IngMiguelMartinez/cnc-3d-social-housing-thesis/media/demo_cnc_2.gif

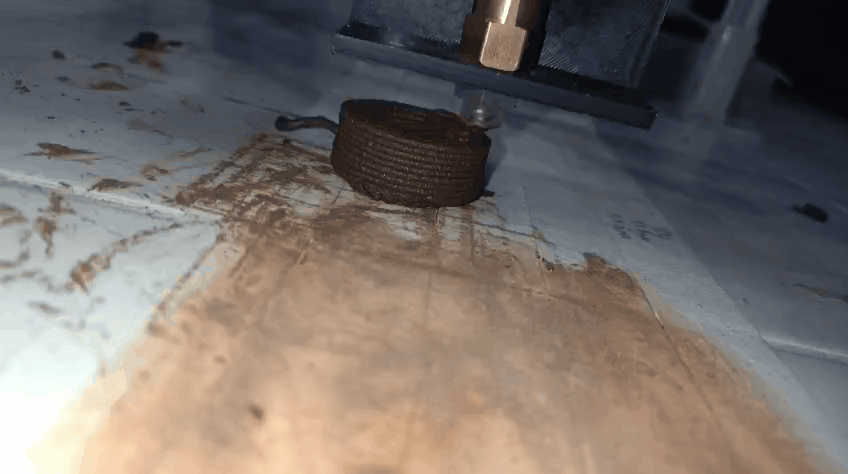
media/demo_cnc_2.gif
