IngMiguelMartinez/cnc-3d-social-housing-thesis/media/Vista_Frontal.jpeg

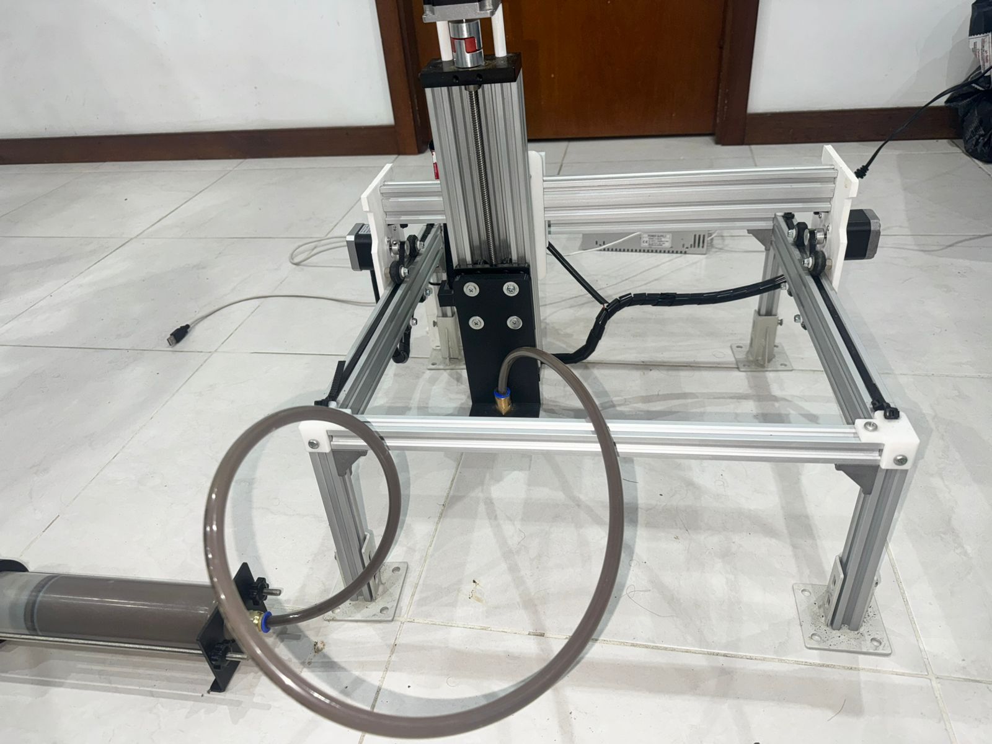
media/Vista_Frontal.jpeg
