IngMiguelMartinez/cnc-3d-social-housing-thesis/media/Vista_Frrontal2.jpeg

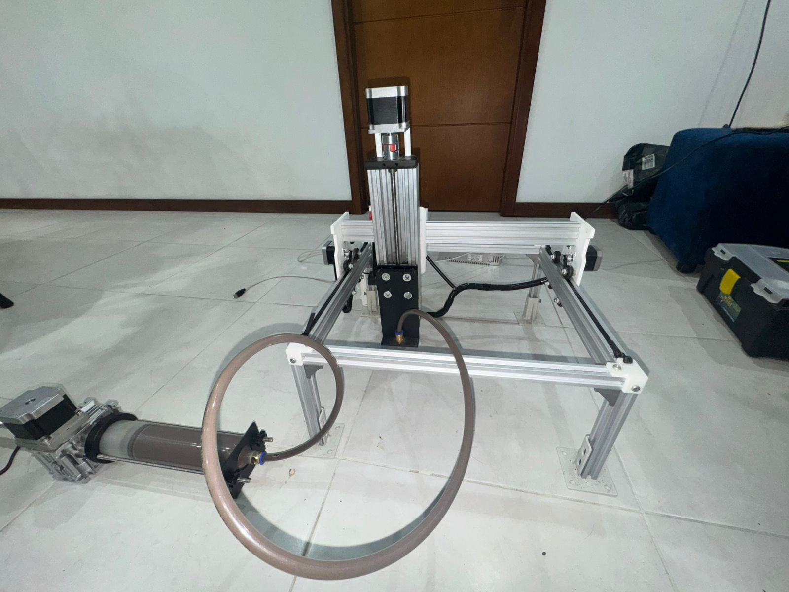
media/Vista_Frrontal2.jpeg
