IngMiguelMartinez/cnc-3d-social-housing-thesis/hardware/cad/ensamblaje_solidworks/Eje Z 300mm.SLDASM

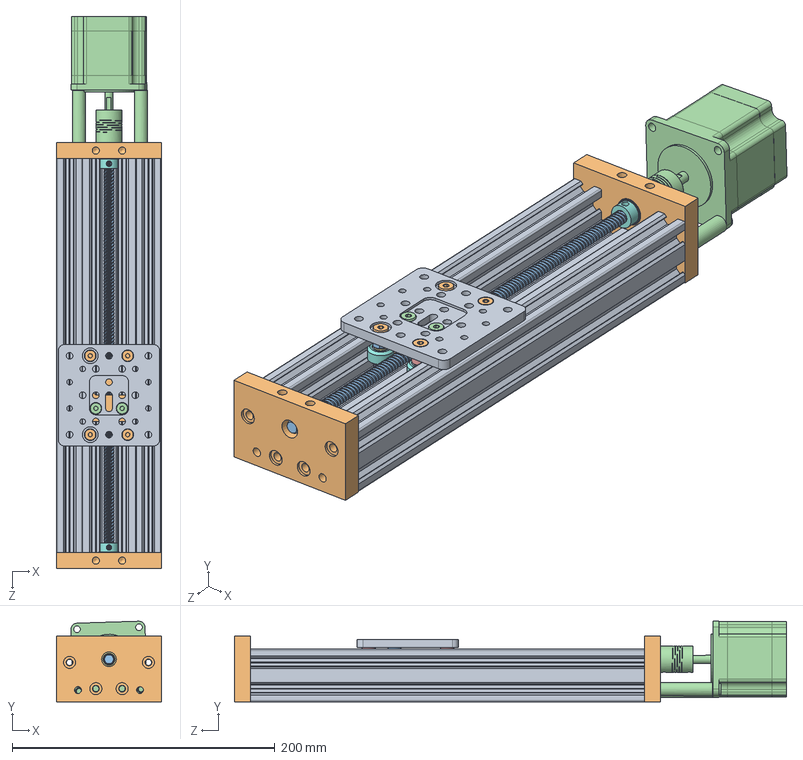
[picture p8: CAD file, 2026-01-31]
hardware/cad/ensamblaje_solidworks/Eje Z 300mm.SLDASM
80.0 x 61.3 x 420.0 mm
PF20-13 - Perfil 4080 C-Beam
Pieza85 x 2
Tornillo z
Acople FlexibleSLDPRT
dis_bilezik x 2
ic_bilezik x 2
kapak x 4
Lock Collar 8mm x 2
BaseMovil
Antibacklash camisa
Espaciador de aluminio 3mm x 2
Low Profile Screw M5 [20mm] x 2
Espaciador de aluminio 6mm x 2
Nylon Insert Lock Nut M5 x 4
Precision Shim 8 x 5 x 1 x 8
Xtreme Mini V Wheel x 4
Ball Bearing 5 x 10 x 4.2 x 8
Low Profile Screw M5 [25mm] x 4
Mini Eccentric Spacer 6mm x 2
Nema 23
