IngMiguelMartinez/cnc-3d-social-housing-thesis/hardware/cad/ensamblaje_solidworks/Rueda_ensamblZguia.SLDASM

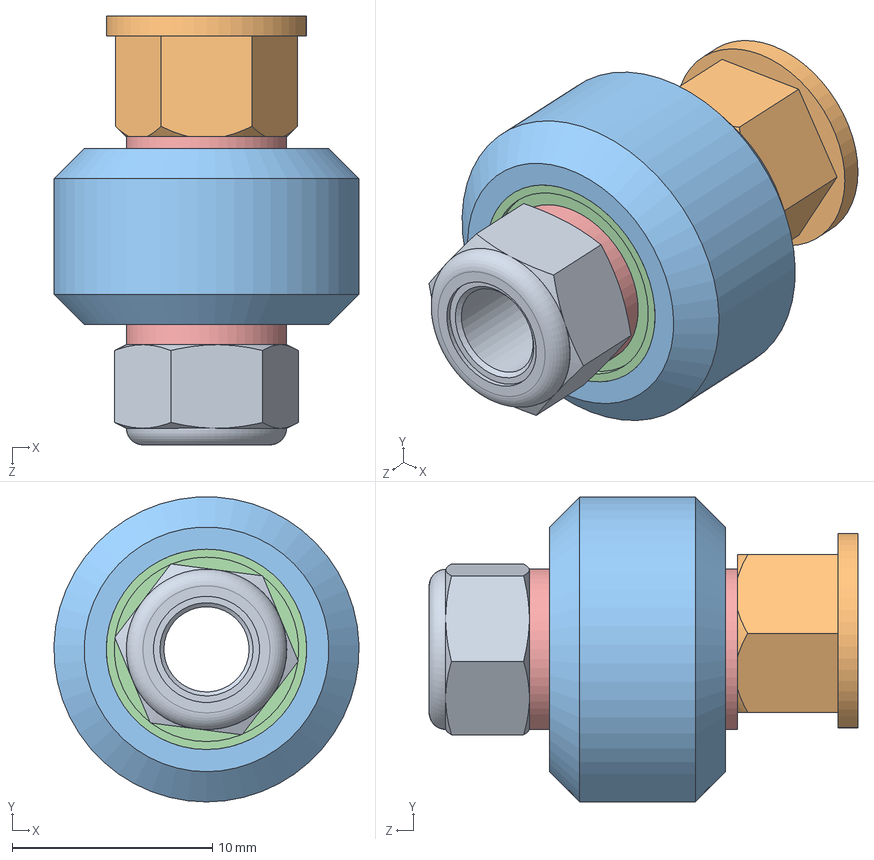
[picture p9: CAD file, 2026-01-31]
hardware/cad/ensamblaje_solidworks/Rueda_ensamblZguia.SLDASM
15.2 x 15.2 x 21.4 mm
Nylon Insert Lock Nut M5
Mini Eccentric Spacer 6mm
Xtreme Mini V Wheel
Ball Bearing 5 x 10 x 4.2 x 2
Precision Shim 8 x 5 x 1 x 2
