IngMiguelMartinez/cnc-3d-social-housing-thesis/hardware/cad/ensamblaje_solidworks/rueda_ensamb_x.SLDASM

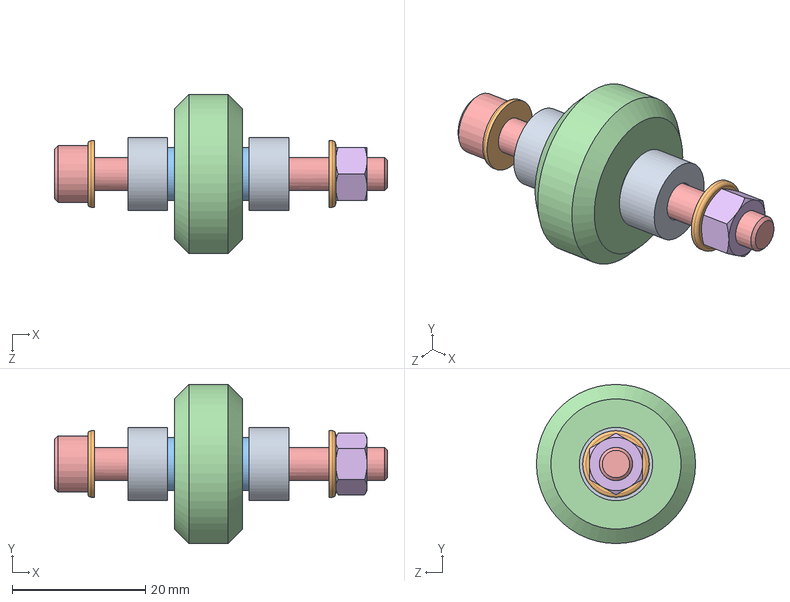
[picture p10: CAD file, 2026-01-31]
hardware/cad/ensamblaje_solidworks/rueda_ensamb_x.SLDASM
50.0 x 23.9 x 23.9 mm
anillo x 2
arandela x 2
arandela_presion x 2
rueda
socket head cap screw_am
hex nut style 1_am
