IngMiguelMartinez/cnc-3d-social-housing-thesis/hardware/cad/ensamblaje_solidworks/Ensamblaje XY.SLDASM

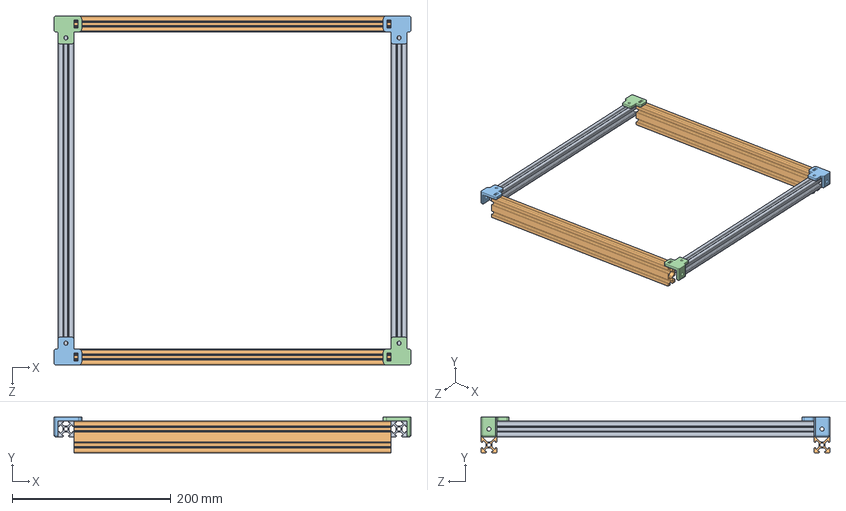
[picture p11: CAD file, 2026-01-31]
hardware/cad/ensamblaje_solidworks/Ensamblaje XY.SLDASM
450.0 x 45.0 x 440.0 mm
FRONTAL_PERFIL_2020 x 2
LATERAL_PERFIL_2040 x 2
tensorRtensor_correa x 2
tensor_correa x 2
