IngMiguelMartinez/cnc-3d-social-housing-thesis/hardware/cad/ensamblaje_solidworks/Prueba soporte.SLDASM

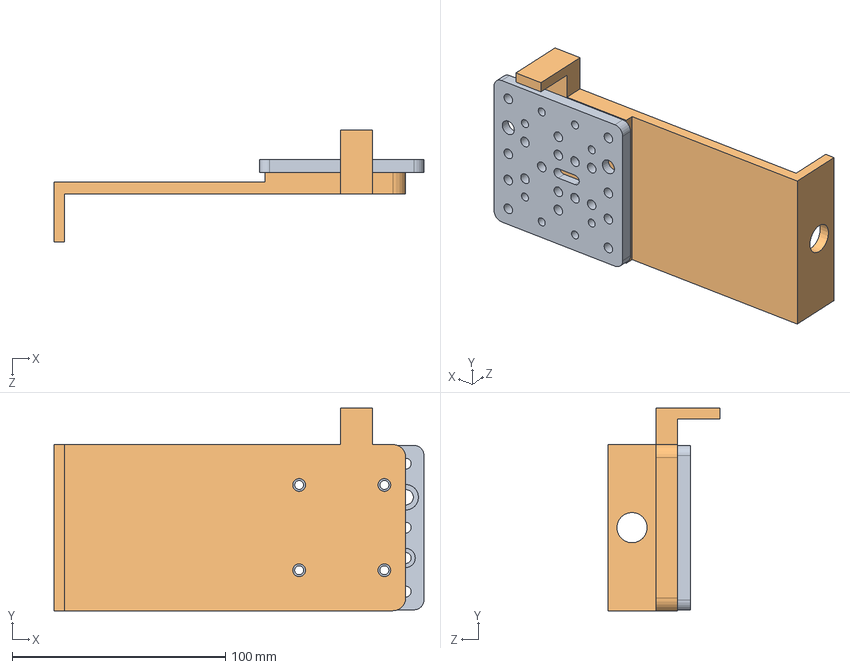
[picture p12: CAD file, 2026-01-31]
hardware/cad/ensamblaje_solidworks/Prueba soporte.SLDASM
173.6 x 95.0 x 52.7 mm
BaseMovil
Preliminar soporte boquilla
