IngMiguelMartinez/cnc-3d-social-housing-thesis/hardware/cad/ensamblaje_solidworks/EnsambleCarroY.SLDASM

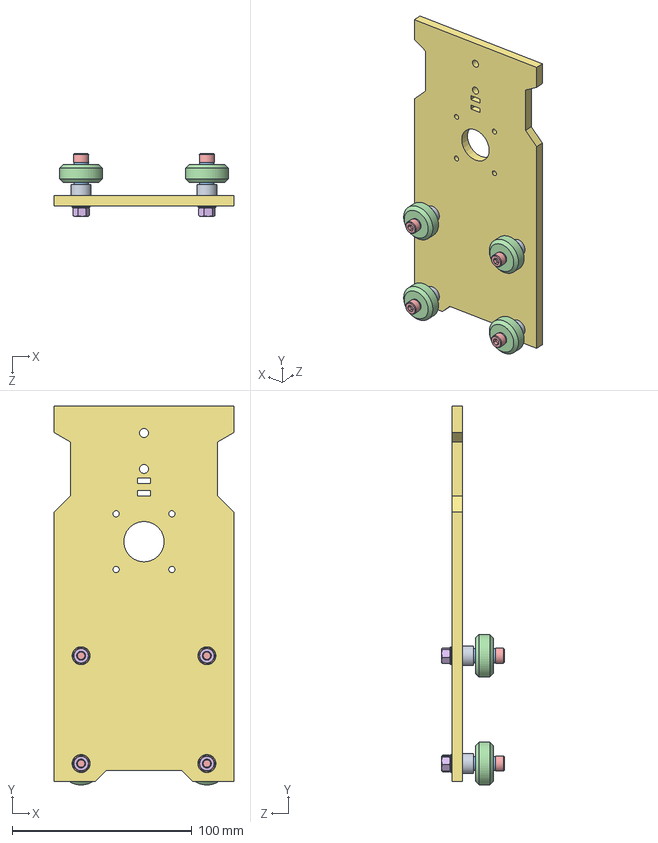
[picture p13: CAD file, 2026-01-31]
hardware/cad/ensamblaje_solidworks/EnsambleCarroY.SLDASM
100.0 x 210.9 x 35.0 mm
anillo x 4
arandela x 4
arandela_presion x 8
rueda x 4
socket head cap screw_am x 4
hex nut style 1_am x 4
carro eje Y
