IngMiguelMartinez/cnc-3d-social-housing-thesis/hardware/cad/ensamblaje_solidworks/688zz_bearing.SLDASM

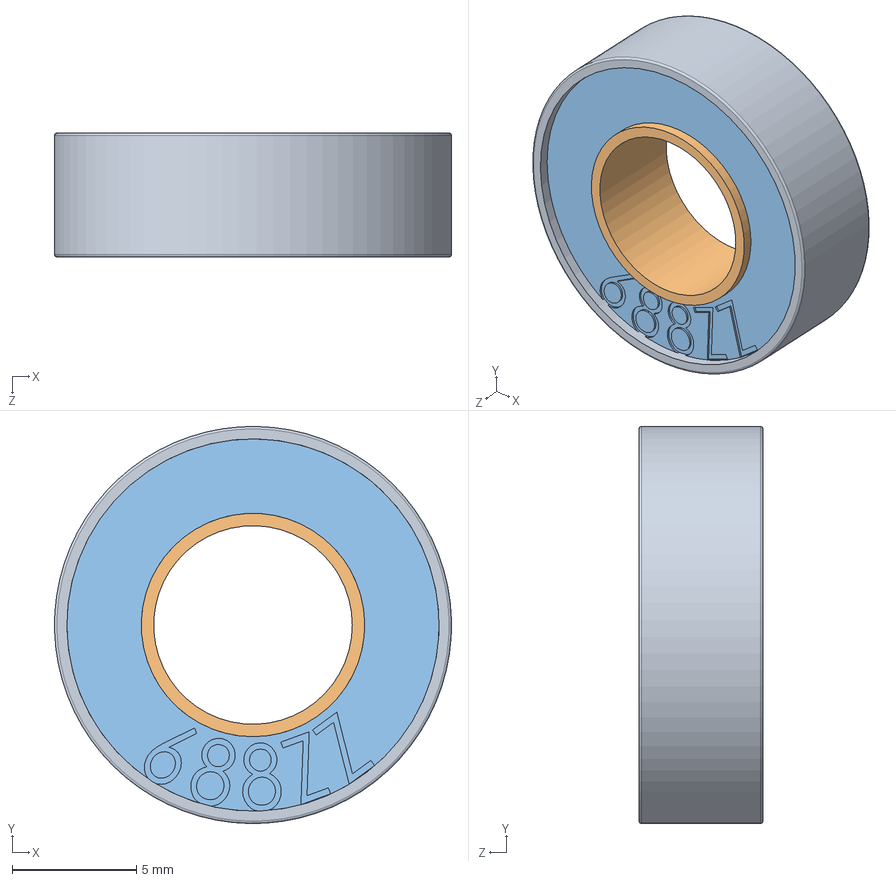
[picture p14: CAD file, 2026-01-31]
hardware/cad/ensamblaje_solidworks/688zz_bearing.SLDASM
16.0 x 16.0 x 5.00 mm
dis_bilezik
ic_bilezik
kapak x 2
