IngMiguelMartinez/cnc-3d-social-housing-thesis/hardware/cad/ensamblaje_solidworks/CarroX.SLDASM

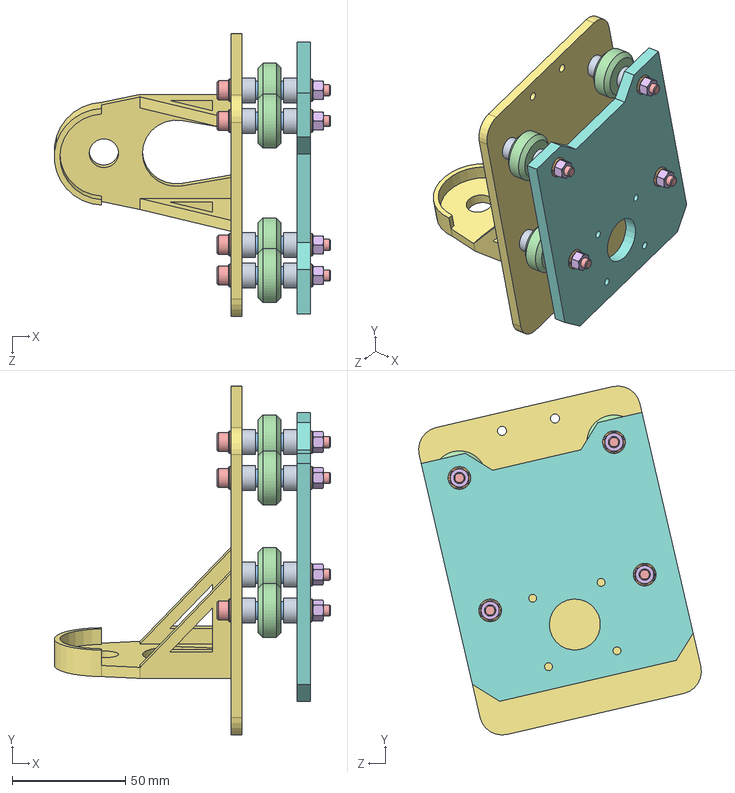
[picture p15: CAD file, 2026-01-31]
hardware/cad/ensamblaje_solidworks/CarroX.SLDASM
121.8 x 154.0 x 124.8 mm
anillo x 8
arandela x 8
arandela_presion x 8
rueda x 4
socket head cap screw_am x 4
hex nut style 1_am x 4
carro eje X_frontal
carro eje X
