IngMiguelMartinez/cnc-3d-social-housing-thesis/hardware/cad/ensamblaje_solidworks/Ensamblaje tanque.SLDASM

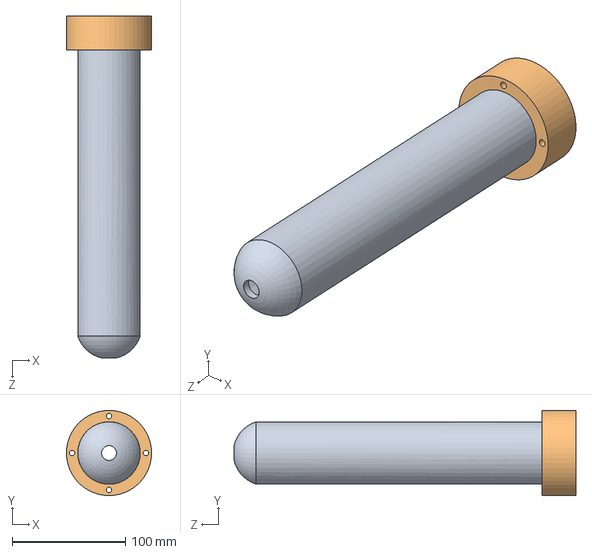
[picture p16: CAD file, 2026-01-31]
hardware/cad/ensamblaje_solidworks/Ensamblaje tanque.SLDASM
75.0 x 75.0 x 301.3 mm
Tanque
Tapa
