IngMiguelMartinez/cnc-3d-social-housing-thesis/hardware/cad/ensamblaje_solidworks/NMRV030.SLDASM

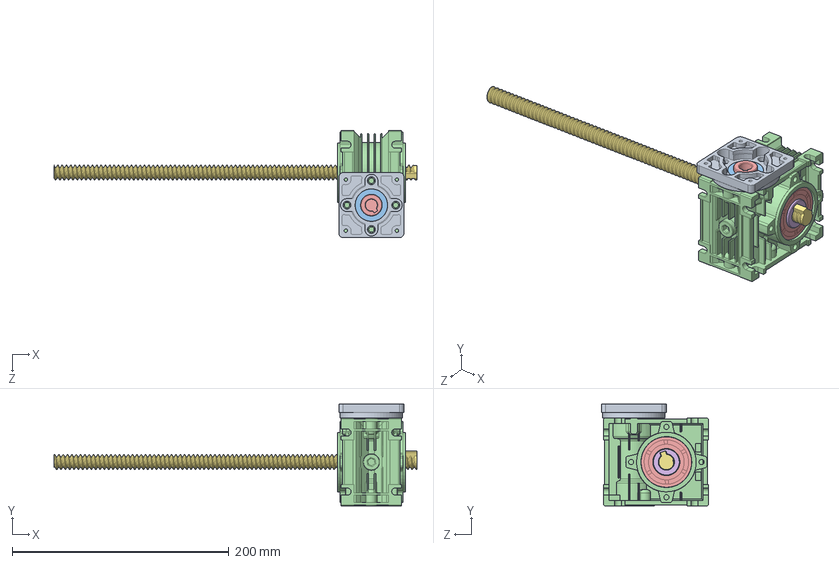
[picture p18: CAD file, 2026-01-31]
hardware/cad/ensamblaje_solidworks/NMRV030.SLDASM
335.0 x 94.0 x 99.0 mm
PrirubaDC300W
Okrouzek33x2
Gufero7x30x20
GearboxRV030Case
Gufero7x47x25 x 2
GearboxRV030OutputShaft
GearboxRV030Shaft
ZátkaNBR_32x7
Lozisko_16005_47x25x8 x 2
Pojistny Krouzek DIN 472 x 2
Lozisko_6201_32x12x10
Lozisko_61904_37x20x9
HridelSnek
