IngMiguelMartinez/cnc-3d-social-housing-thesis/hardware/cad/ensamblaje_solidworks/rueda_ensambl1.SLDASM

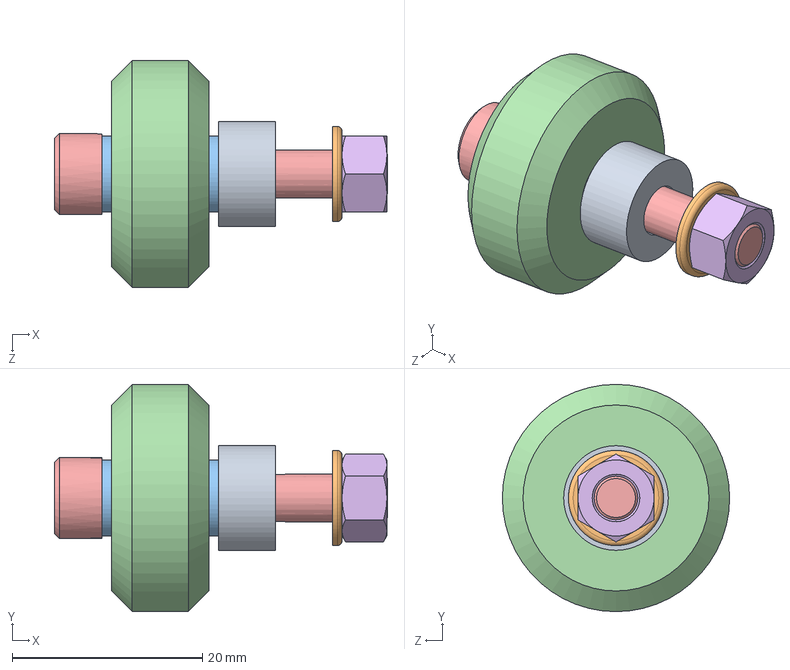
[picture p19: CAD file, 2026-01-31]
hardware/cad/ensamblaje_solidworks/rueda_ensambl1.SLDASM
35.0 x 23.9 x 23.9 mm
anillo
arandela
arandela_presion x 2
rueda
socket head cap screw_am
hex nut style 1_am
