IngMiguelMartinez/cnc-3d-social-housing-thesis/hardware/cad/ensamblaje_solidworks/GearboxRV030OutputShaft.SLDPRT

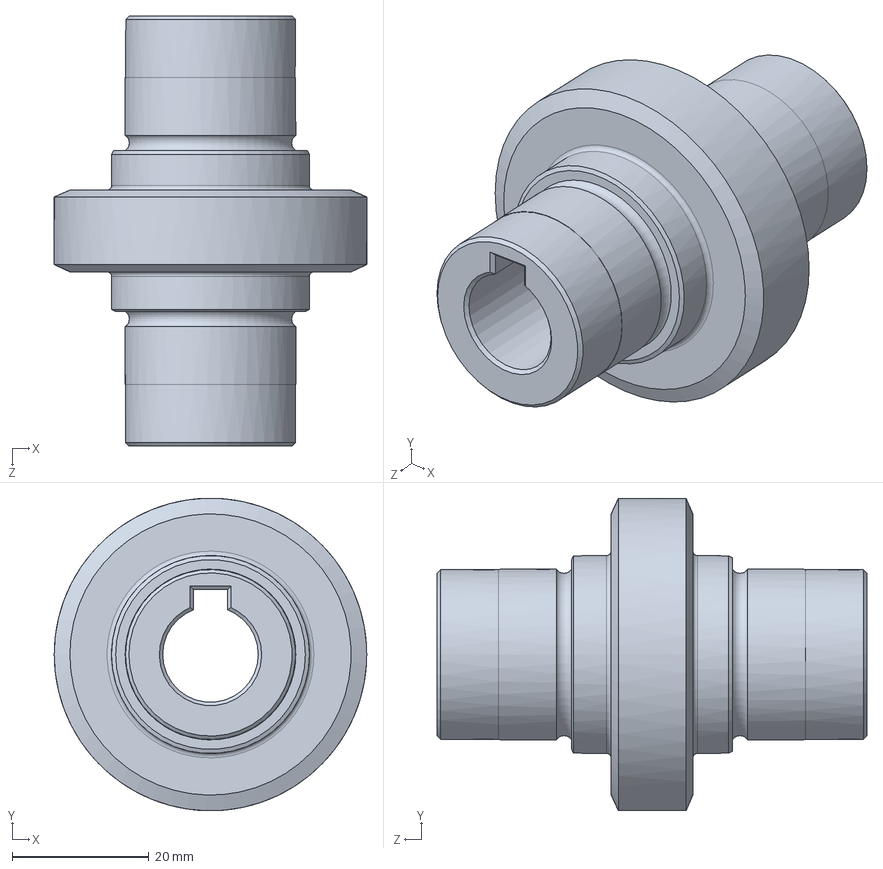
[picture p20: CAD file, 2026-01-31]
hardware/cad/ensamblaje_solidworks/GearboxRV030OutputShaft.SLDPRT
45.8 x 45.8 x 63.0 mm
