IngMiguelMartinez/cnc-3d-social-housing-thesis/hardware/cad/ensamblaje_solidworks/kapak.SLDPRT

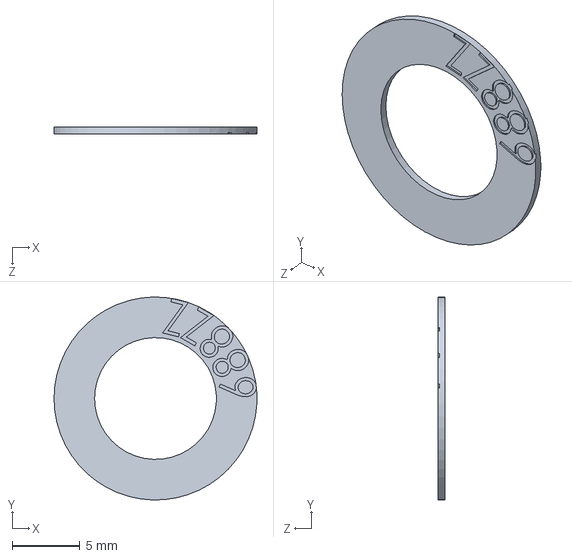
[picture p21: CAD file, 2026-01-31]
hardware/cad/ensamblaje_solidworks/kapak.SLDPRT
15.0 x 15.0 x 0.5 mm
