IngMiguelMartinez/cnc-3d-social-housing-thesis/hardware/cad/ensamblaje_solidworks/tensorRtensor_correa.SLDPRT

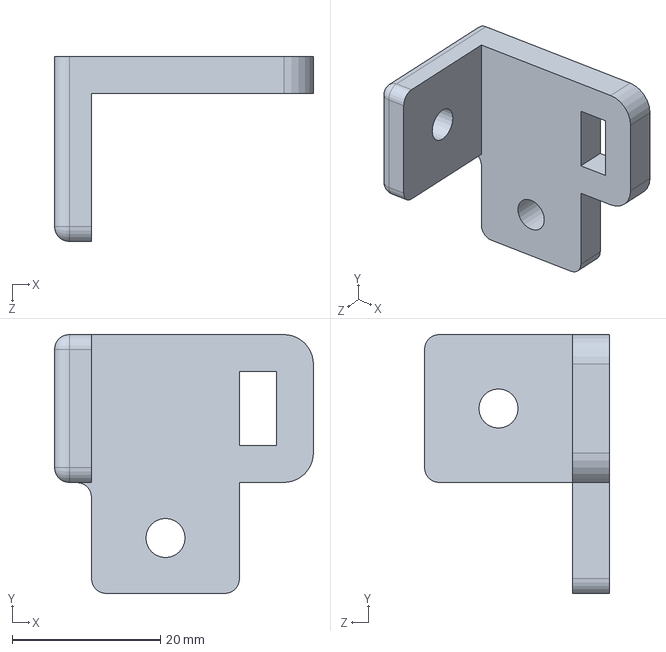
[picture p22: CAD file, 2026-01-31]
hardware/cad/ensamblaje_solidworks/tensorRtensor_correa.SLDPRT
35.0 x 35.0 x 25.0 mm
