IngMiguelMartinez/cnc-3d-social-housing-thesis/hardware/cad/ensamblaje_solidworks/carro eje Y.SLDPRT

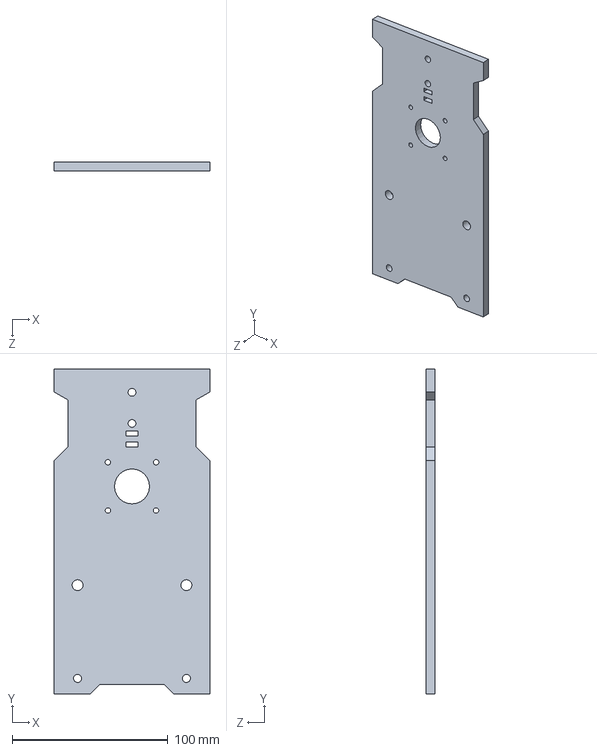
[picture p23: CAD file, 2026-01-31]
hardware/cad/ensamblaje_solidworks/carro eje Y.SLDPRT
100.0 x 209.0 x 6.00 mm
