IngMiguelMartinez/cnc-3d-social-housing-thesis/hardware/cad/ensamblaje_solidworks/ic_bilezik.SLDPRT

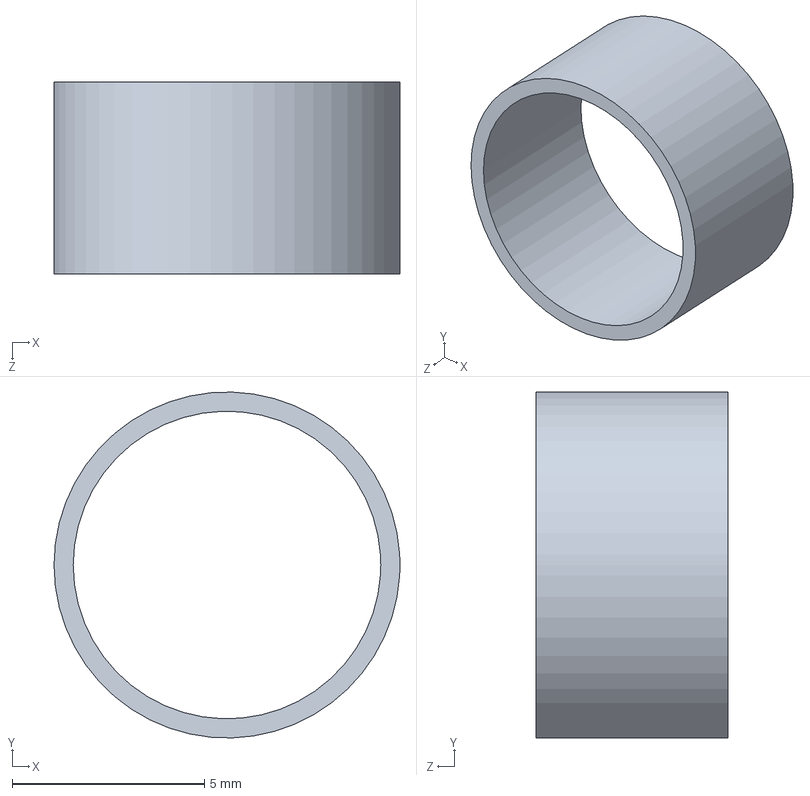
[picture p24: CAD file, 2026-01-31]
hardware/cad/ensamblaje_solidworks/ic_bilezik.SLDPRT
9.00 x 9.00 x 5.00 mm
