IngMiguelMartinez/cnc-3d-social-housing-thesis/hardware/cad/ensamblaje_solidworks/Nema 23.SLDPRT

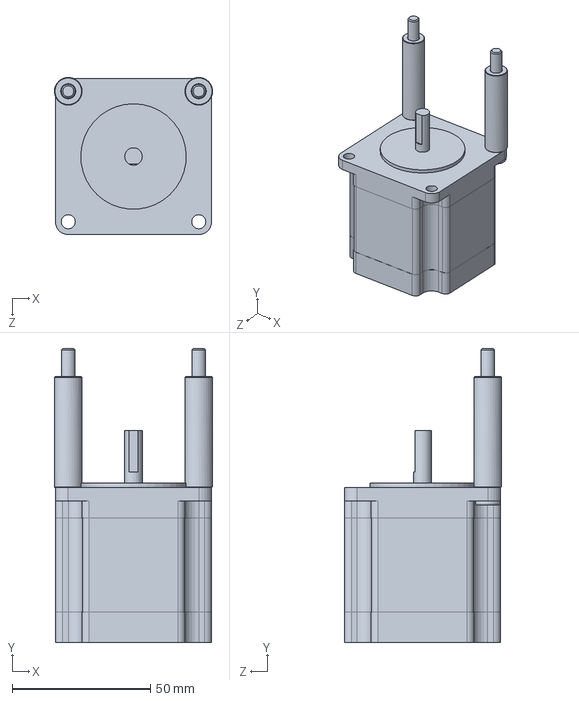
[picture p25: CAD file, 2026-01-31]
hardware/cad/ensamblaje_solidworks/Nema 23.SLDPRT
57.1 x 106.2 x 56.8 mm
