IngMiguelMartinez/cnc-3d-social-housing-thesis/hardware/cad/ensamblaje_solidworks/LATERAL_PERFIL_2040 X.SLDPRT

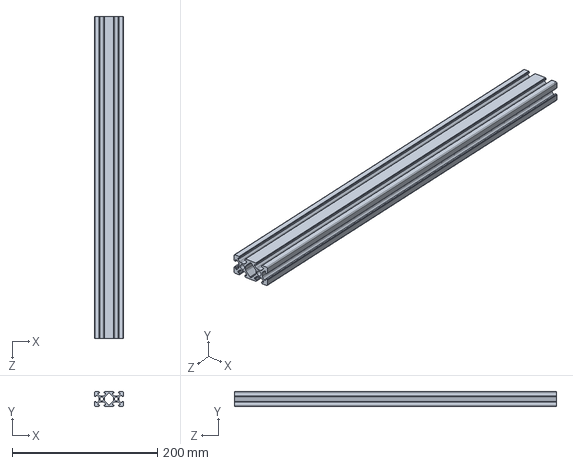
[picture p26: CAD file, 2026-01-31]
hardware/cad/ensamblaje_solidworks/LATERAL_PERFIL_2040 X.SLDPRT
40.0 x 20.0 x 444.0 mm
