IngMiguelMartinez/cnc-3d-social-housing-thesis/hardware/cad/ensamblaje_solidworks/ZátkaNBR_32x7.SLDPRT

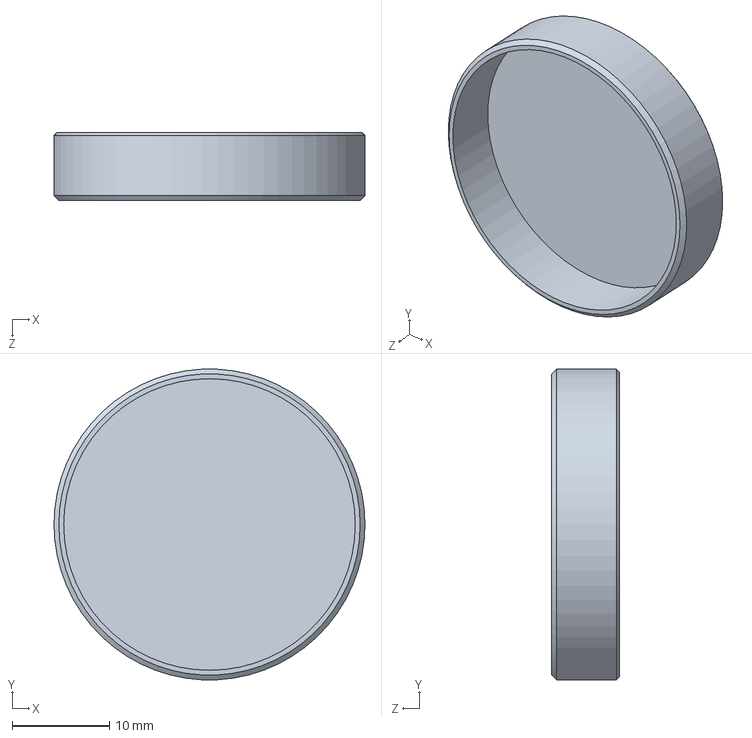
[picture p27: CAD file, 2026-01-31]
hardware/cad/ensamblaje_solidworks/ZátkaNBR_32x7.SLDPRT
32.0 x 32.0 x 7.00 mm
