IngMiguelMartinez/cnc-3d-social-housing-thesis/hardware/cad/ensamblaje_solidworks/Xtreme Mini V Wheel.SLDPRT

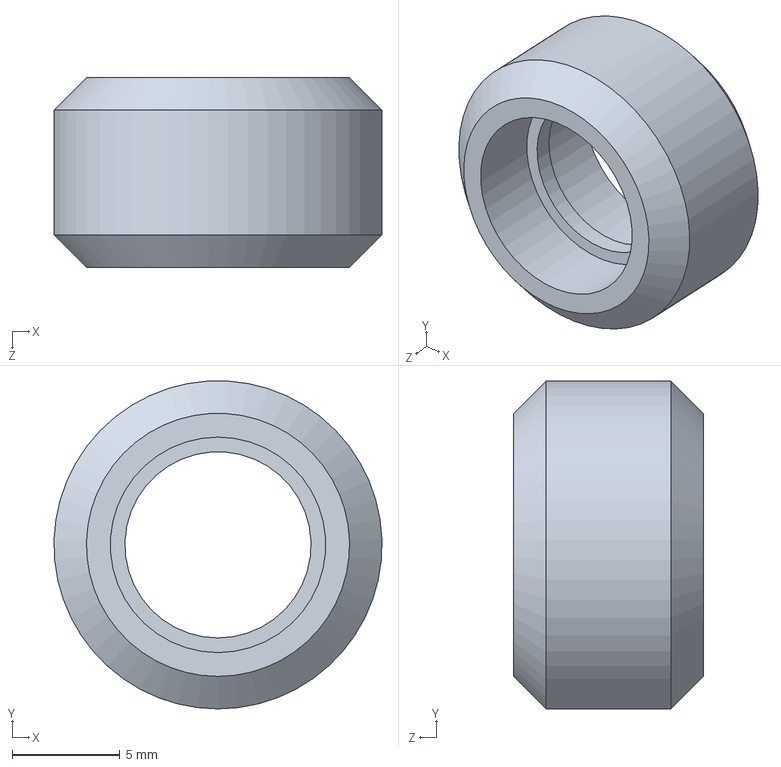
[picture p28: CAD file, 2026-01-31]
hardware/cad/ensamblaje_solidworks/Xtreme Mini V Wheel.SLDPRT
15.2 x 15.2 x 8.80 mm
