IngMiguelMartinez/cnc-3d-social-housing-thesis/hardware/cad/ensamblaje_solidworks/Tanque.SLDPRT

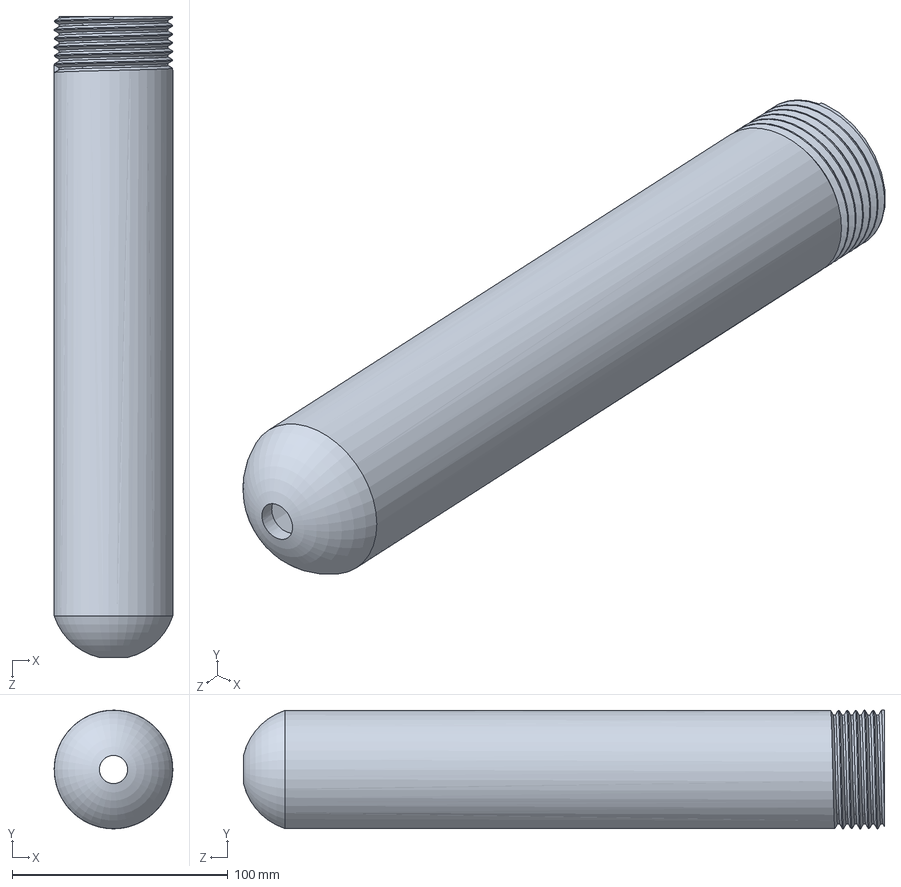
[picture p29: CAD file, 2026-01-31]
hardware/cad/ensamblaje_solidworks/Tanque.SLDPRT
55.0 x 55.0 x 297.3 mm
