IngMiguelMartinez/cnc-3d-social-housing-thesis/hardware/cad/ensamblaje_solidworks/Espaciador de aluminio 6mm.SLDPRT

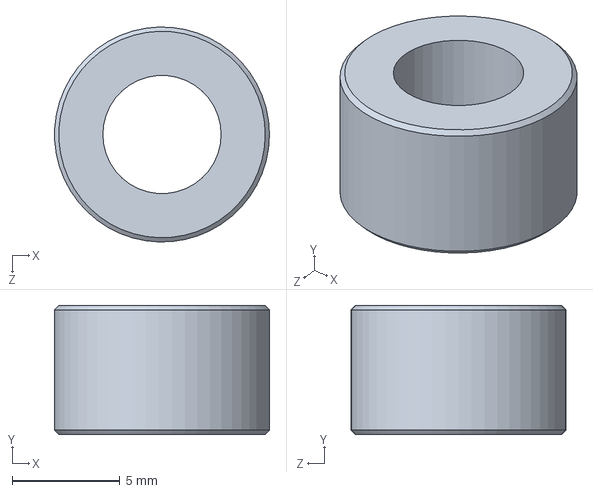
[picture p30: CAD file, 2026-01-31]
hardware/cad/ensamblaje_solidworks/Espaciador de aluminio 6mm.SLDPRT
10.0 x 6.00 x 10.00 mm
