IngMiguelMartinez/cnc-3d-social-housing-thesis/hardware/cad/ensamblaje_solidworks/carro eje X_frontal.SLDPRT

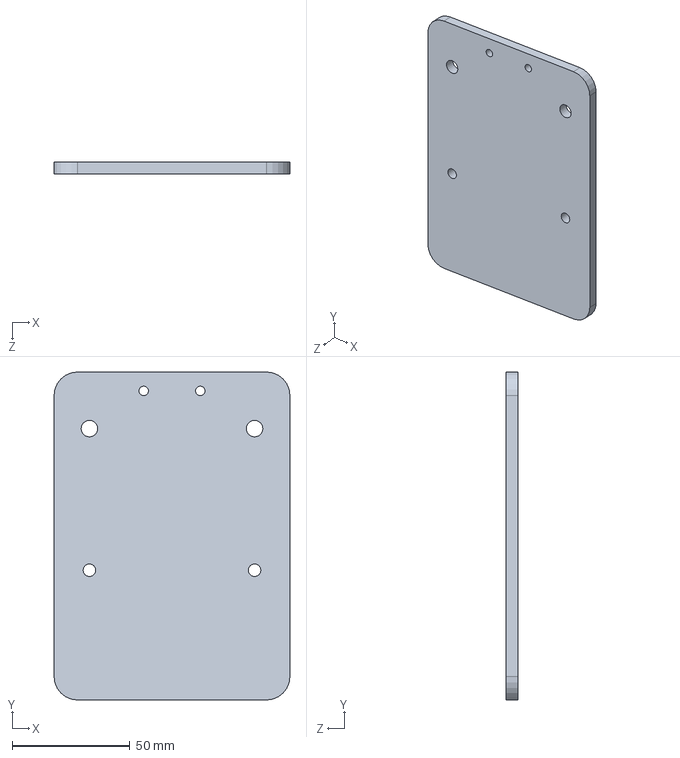
[picture p31: CAD file, 2026-01-31]
hardware/cad/ensamblaje_solidworks/carro eje X_frontal.SLDPRT
100.0 x 139.0 x 5.00 mm
