IngMiguelMartinez/cnc-3d-social-housing-thesis/hardware/cad/ensamblaje_solidworks/dis_bilezik.SLDPRT

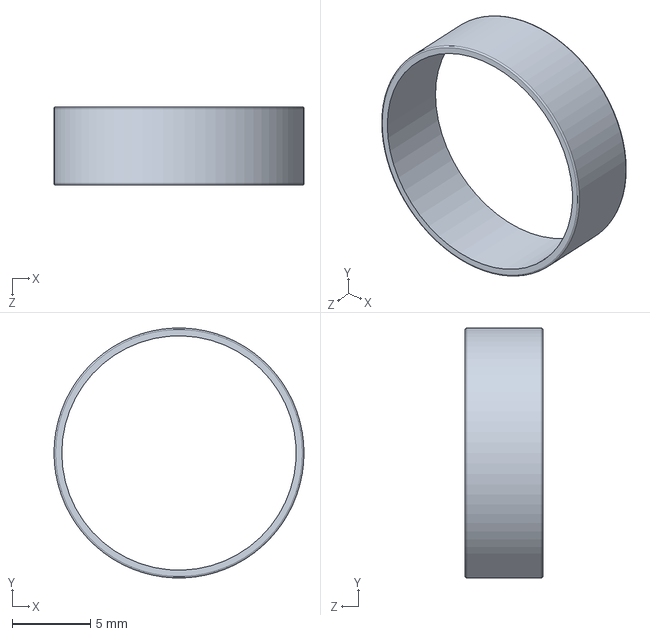
[picture p32: CAD file, 2026-01-31]
hardware/cad/ensamblaje_solidworks/dis_bilezik.SLDPRT
16.0 x 16.0 x 5.00 mm
