IngMiguelMartinez/cnc-3d-social-housing-thesis/hardware/cad/ensamblaje_solidworks/anillo.SLDPRT

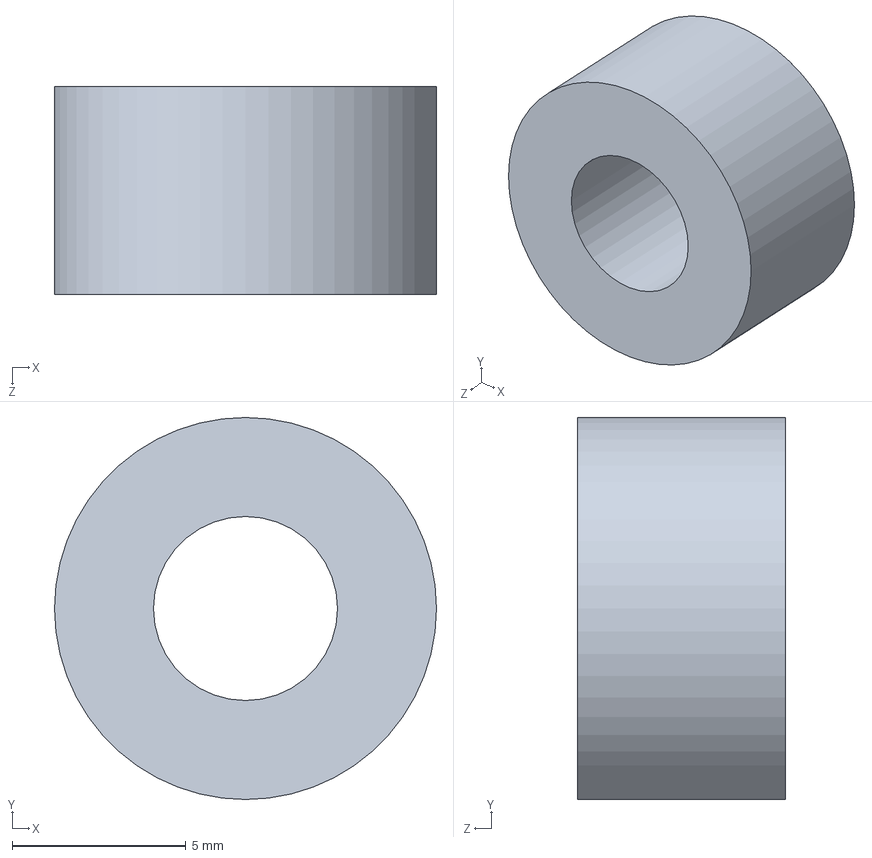
[picture p33: CAD file, 2026-01-31]
hardware/cad/ensamblaje_solidworks/anillo.SLDPRT
11.0 x 11.0 x 6.00 mm
