IngMiguelMartinez/cnc-3d-social-housing-thesis/hardware/cad/ensamblaje_solidworks/FRONTAL_PERFIL_2020.SLDPRT

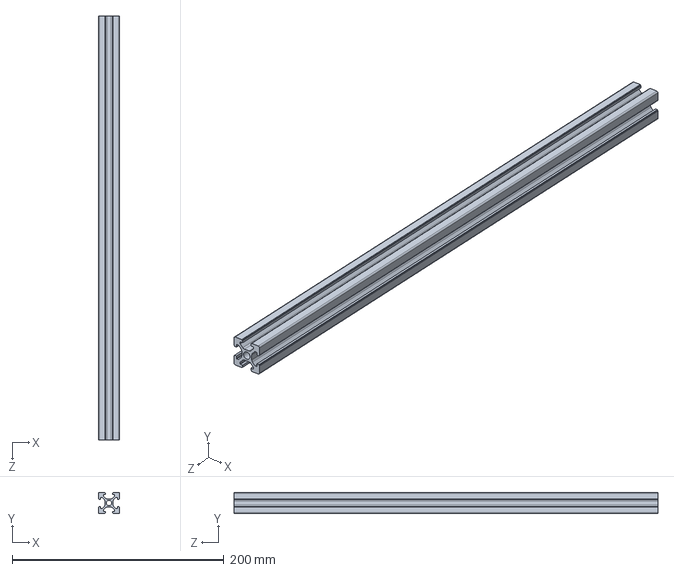
[picture p34: CAD file, 2026-01-31]
hardware/cad/ensamblaje_solidworks/FRONTAL_PERFIL_2020.SLDPRT
20.0 x 20.0 x 400.0 mm
