IngMiguelMartinez/cnc-3d-social-housing-thesis/hardware/cad/ensamblaje_solidworks/Lozisko_61904_37x20x9.SLDPRT

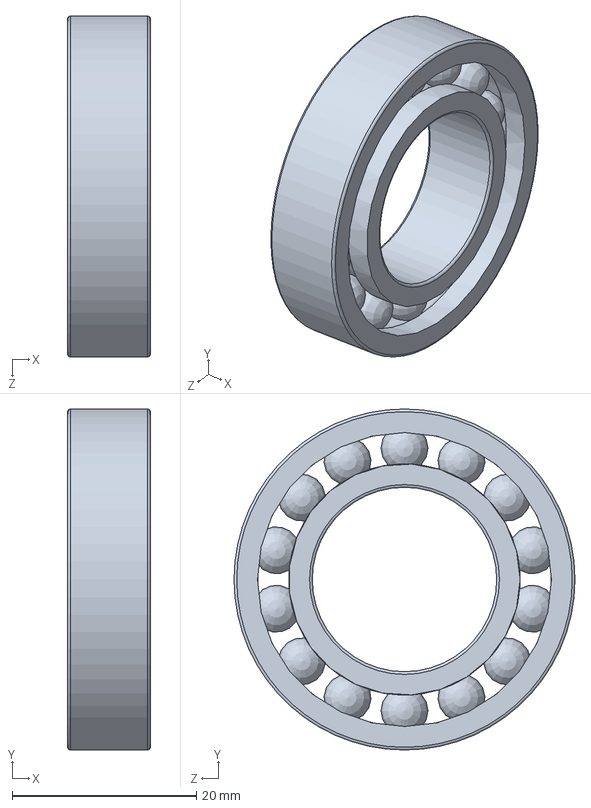
[picture p35: CAD file, 2026-01-31]
hardware/cad/ensamblaje_solidworks/Lozisko_61904_37x20x9.SLDPRT
9.00 x 37.0 x 37.0 mm
