IngMiguelMartinez/cnc-3d-social-housing-thesis/hardware/cad/ensamblaje_solidworks/arandela.SLDPRT

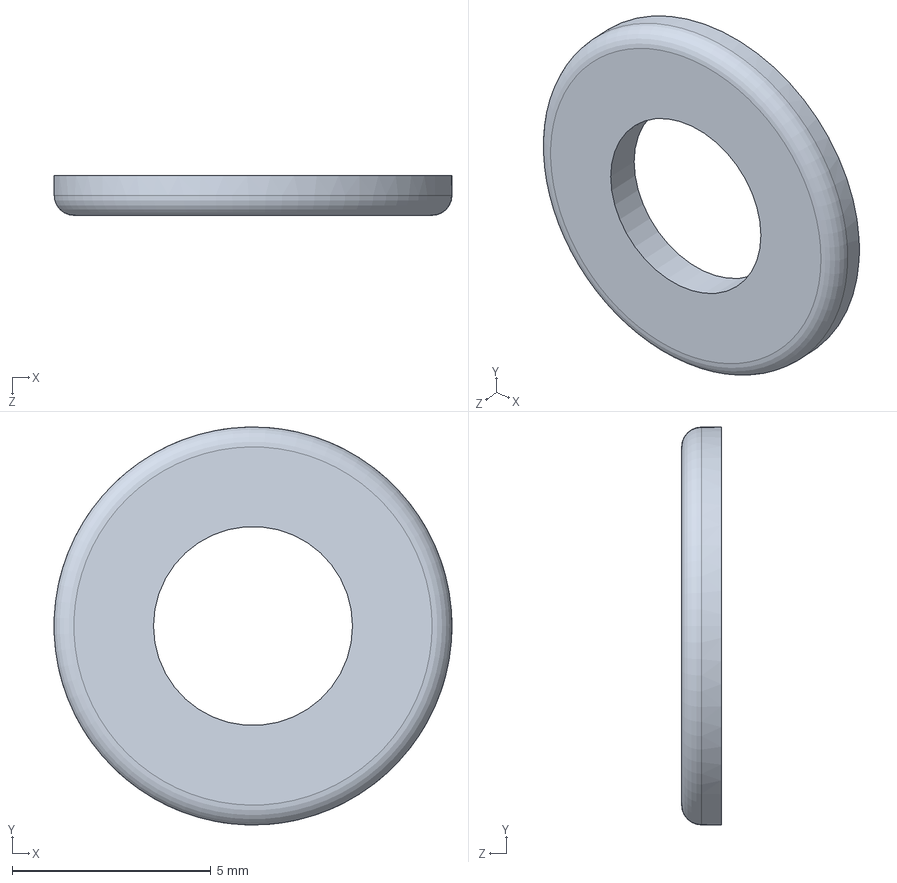
[picture p36: CAD file, 2026-01-31]
hardware/cad/ensamblaje_solidworks/arandela.SLDPRT
10.0 x 10.00 x 1.00 mm
