IngMiguelMartinez/cnc-3d-social-housing-thesis/hardware/cad/ensamblaje_solidworks/arandela_presion.SLDPRT

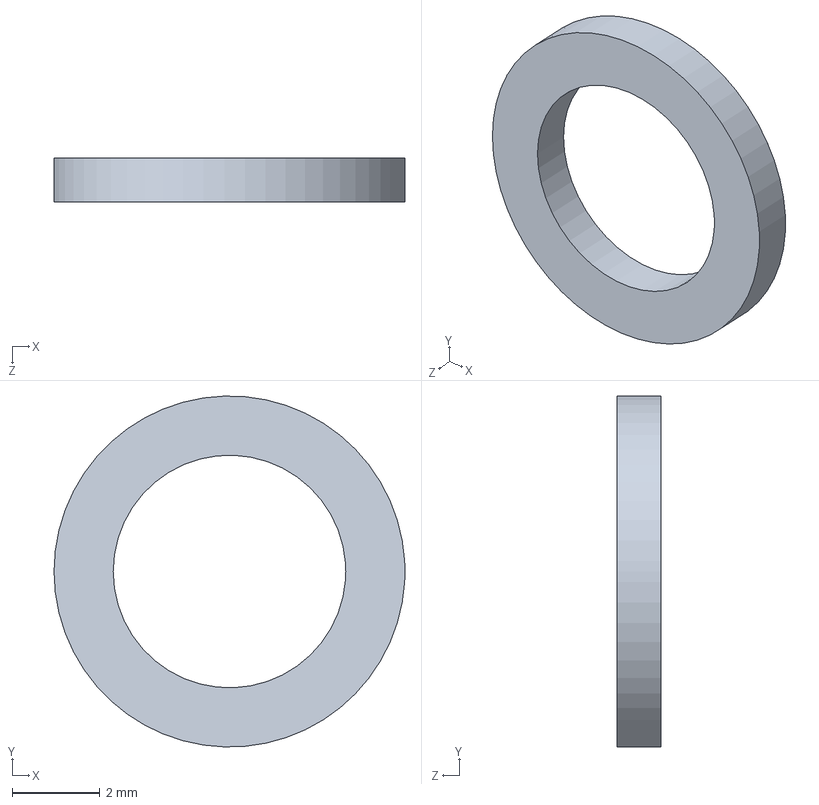
[picture p37: CAD file, 2026-01-31]
hardware/cad/ensamblaje_solidworks/arandela_presion.SLDPRT
8.00 x 8.00 x 1.00 mm
