IngMiguelMartinez/cnc-3d-social-housing-thesis/hardware/cad/ensamblaje_solidworks/Lock Collar 8mm.SLDPRT

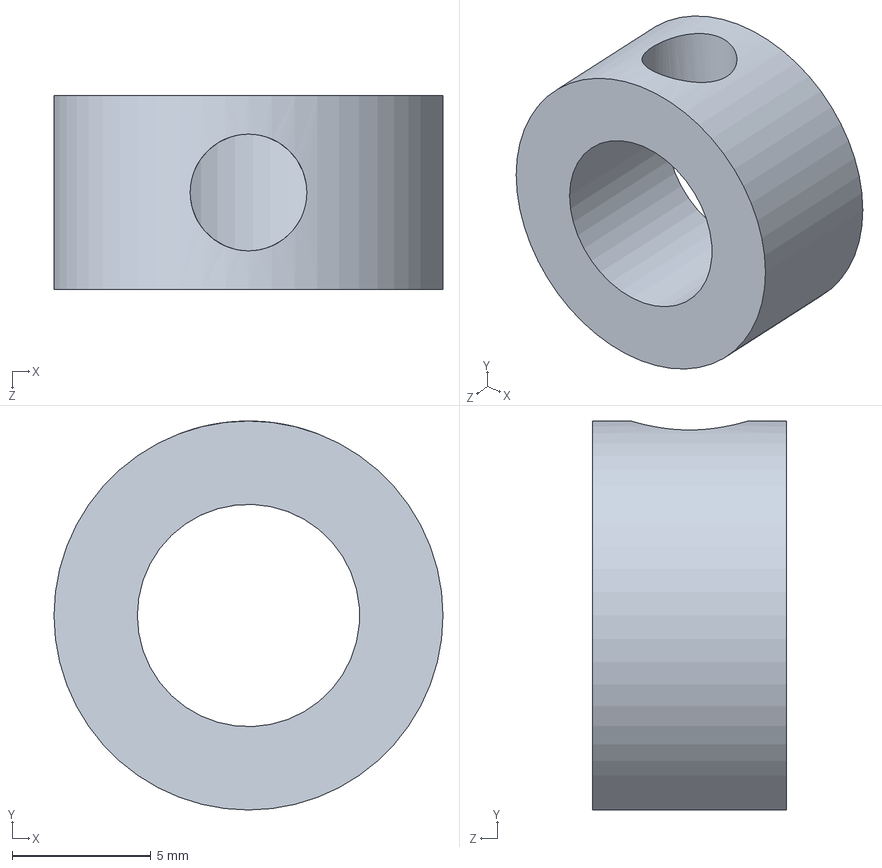
[picture p38: CAD file, 2026-01-31]
hardware/cad/ensamblaje_solidworks/Lock Collar 8mm.SLDPRT
14.0 x 14.0 x 7.00 mm
