IngMiguelMartinez/cnc-3d-social-housing-thesis/hardware/cad/ensamblaje_solidworks/Gufero7x30x20.SLDPRT

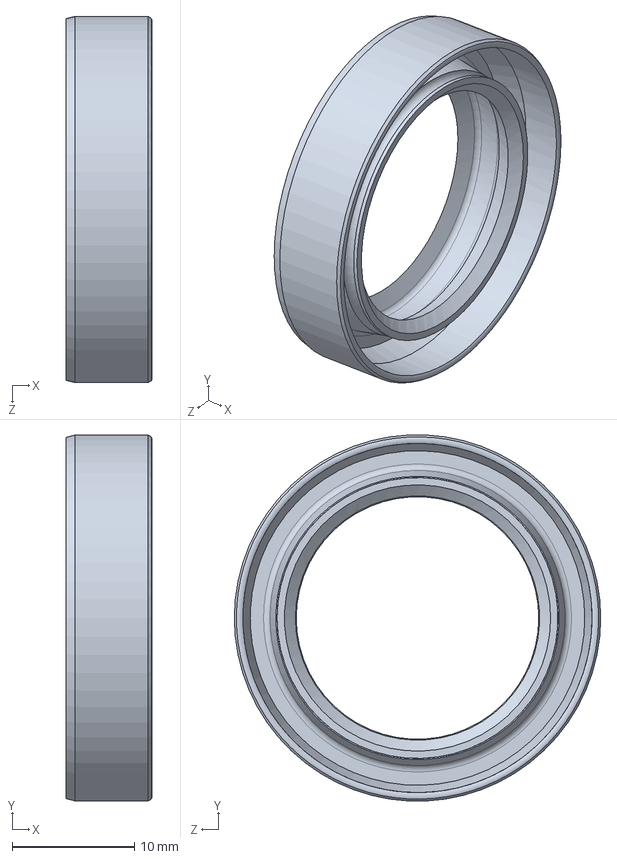
[picture p39: CAD file, 2026-01-31]
hardware/cad/ensamblaje_solidworks/Gufero7x30x20.SLDPRT
7.05 x 30.0 x 30.0 mm
