IngMiguelMartinez/cnc-3d-social-housing-thesis/hardware/cad/ensamblaje_solidworks/Antibacklash camisa.SLDPRT

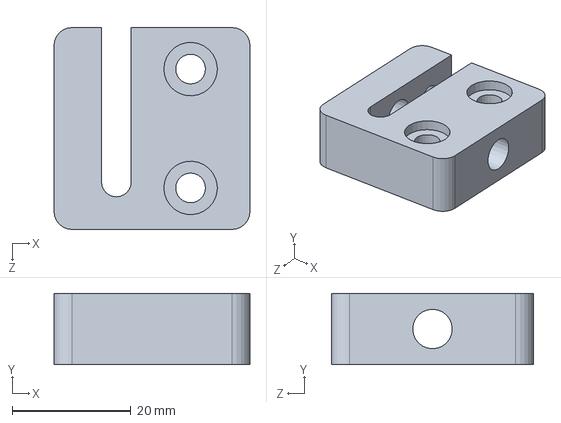
[picture p40: CAD file, 2026-01-31]
hardware/cad/ensamblaje_solidworks/Antibacklash camisa.SLDPRT
33.0 x 12.0 x 34.0 mm
