IngMiguelMartinez/cnc-3d-social-housing-thesis/hardware/cad/ensamblaje_solidworks/GearboxRV030Shaft.SLDPRT

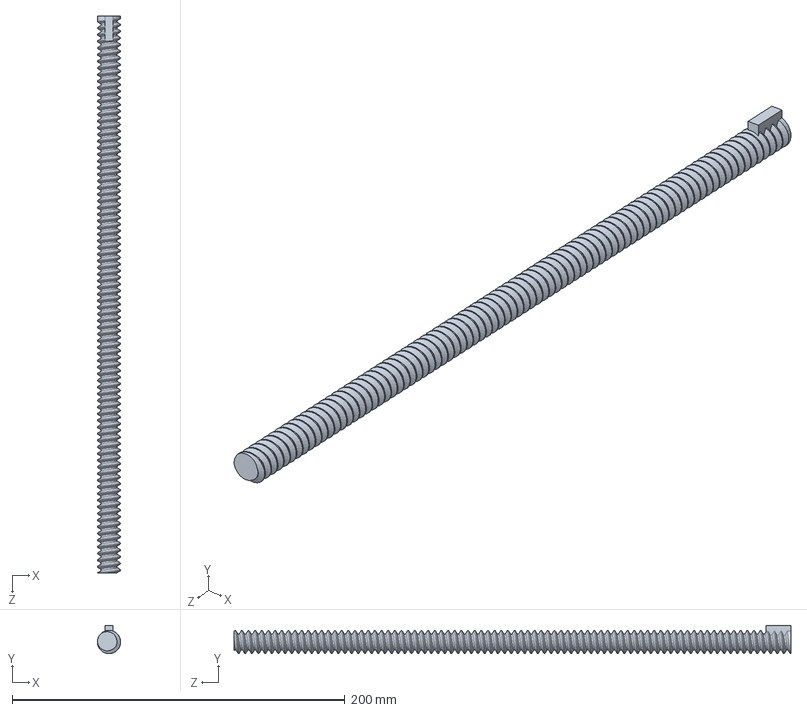
[picture p41: CAD file, 2026-01-31]
hardware/cad/ensamblaje_solidworks/GearboxRV030Shaft.SLDPRT
14.0 x 17.0 x 335.0 mm
