IngMiguelMartinez/cnc-3d-social-housing-thesis/hardware/cad/ensamblaje_solidworks/Okrouzek33x2.SLDPRT

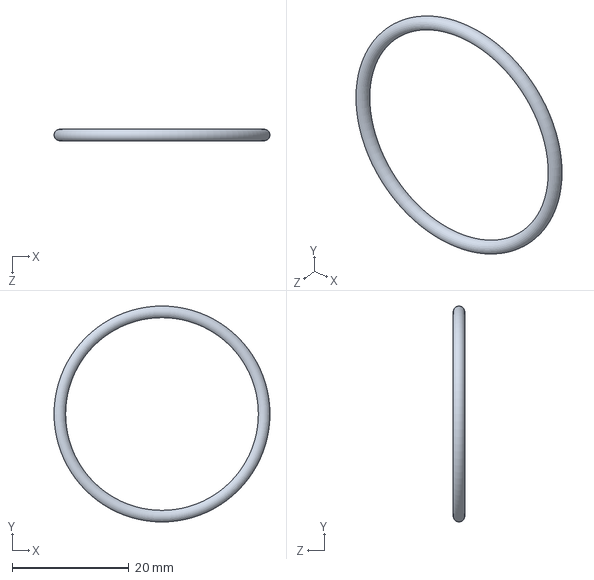
[picture p42: CAD file, 2026-01-31]
hardware/cad/ensamblaje_solidworks/Okrouzek33x2.SLDPRT
37.0 x 37.0 x 2.00 mm
