IngMiguelMartinez/cnc-3d-social-housing-thesis/hardware/cad/ensamblaje_solidworks/BaseMovil.SLDPRT

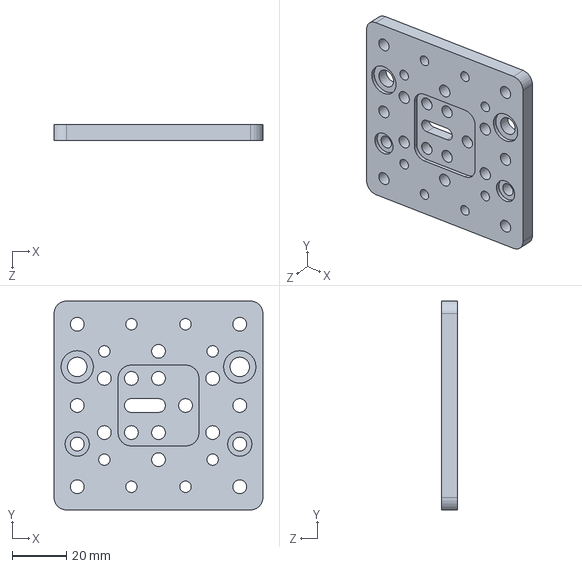
[picture p43: CAD file, 2026-01-31]
hardware/cad/ensamblaje_solidworks/BaseMovil.SLDPRT
77.2 x 77.2 x 6.00 mm
