IngMiguelMartinez/cnc-3d-social-housing-thesis/hardware/cad/ensamblaje_solidworks/Lozisko_6201_32x12x10.SLDPRT

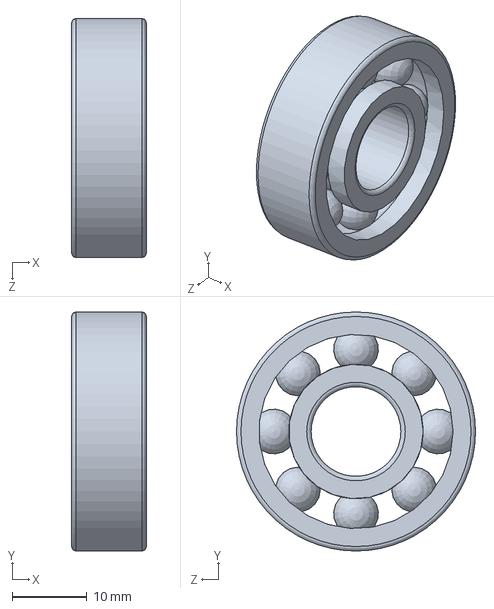
[picture p44: CAD file, 2026-01-31]
hardware/cad/ensamblaje_solidworks/Lozisko_6201_32x12x10.SLDPRT
10.0 x 32.0 x 32.0 mm
