IngMiguelMartinez/cnc-3d-social-housing-thesis/hardware/cad/ensamblaje_solidworks/Nema17.SLDPRT

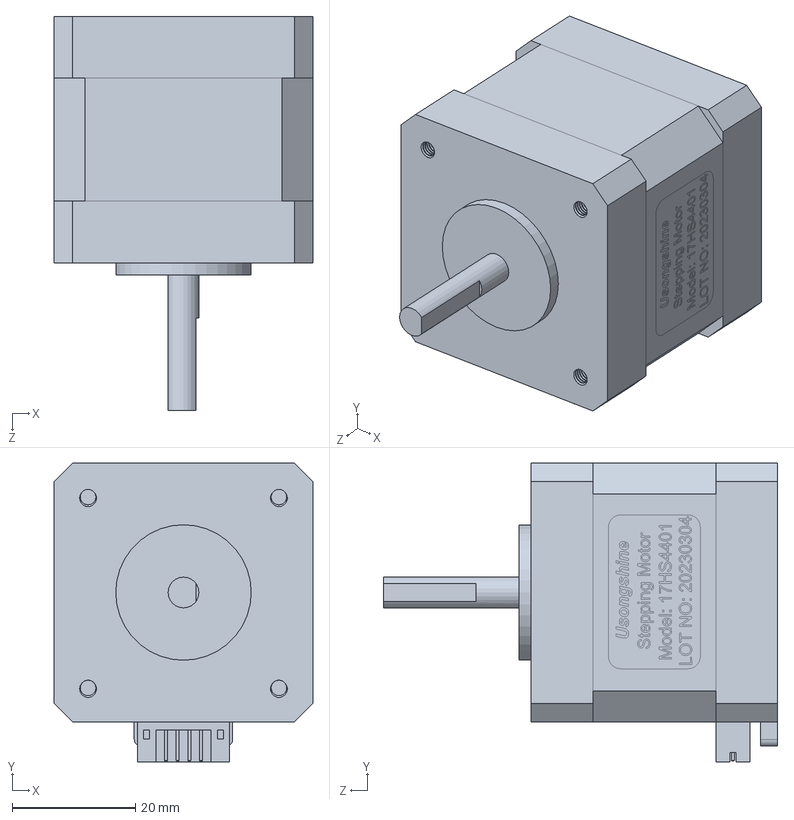
[picture p45: CAD file, 2026-01-31]
hardware/cad/ensamblaje_solidworks/Nema17.SLDPRT
42.0 x 48.5 x 64.0 mm
