IngMiguelMartinez/cnc-3d-social-housing-thesis/hardware/cad/ensamblaje_solidworks/Lozisko_16005_47x25x8.SLDPRT

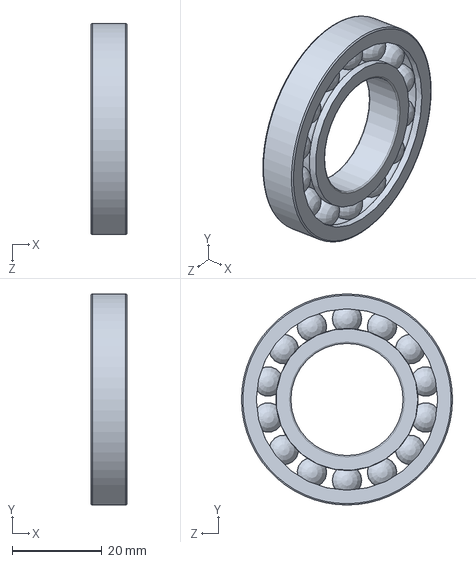
[picture p46: CAD file, 2026-01-31]
hardware/cad/ensamblaje_solidworks/Lozisko_16005_47x25x8.SLDPRT
8.00 x 47.0 x 47.0 mm
