IngMiguelMartinez/cnc-3d-social-housing-thesis/hardware/cad/ensamblaje_solidworks/Tornillo z.SLDPRT

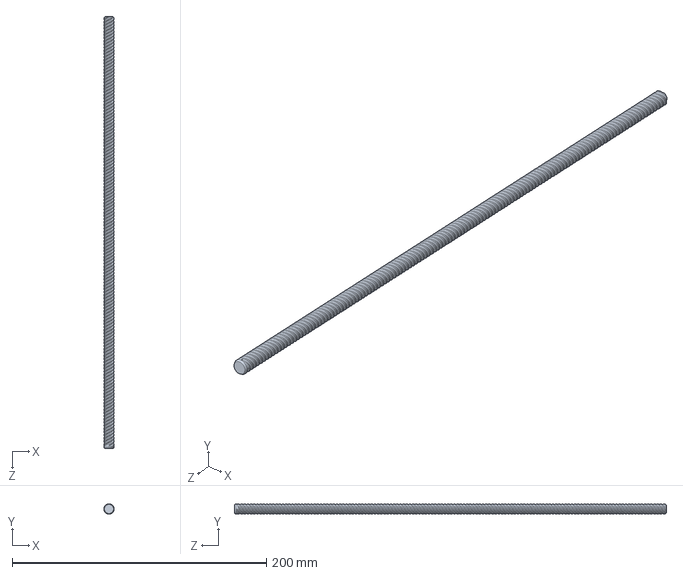
[picture p47: CAD file, 2026-01-31]
hardware/cad/ensamblaje_solidworks/Tornillo z.SLDPRT
8.00 x 8.00 x 340.0 mm
