IngMiguelMartinez/cnc-3d-social-housing-thesis/hardware/cad/ensamblaje_solidworks/Piston.SLDPRT

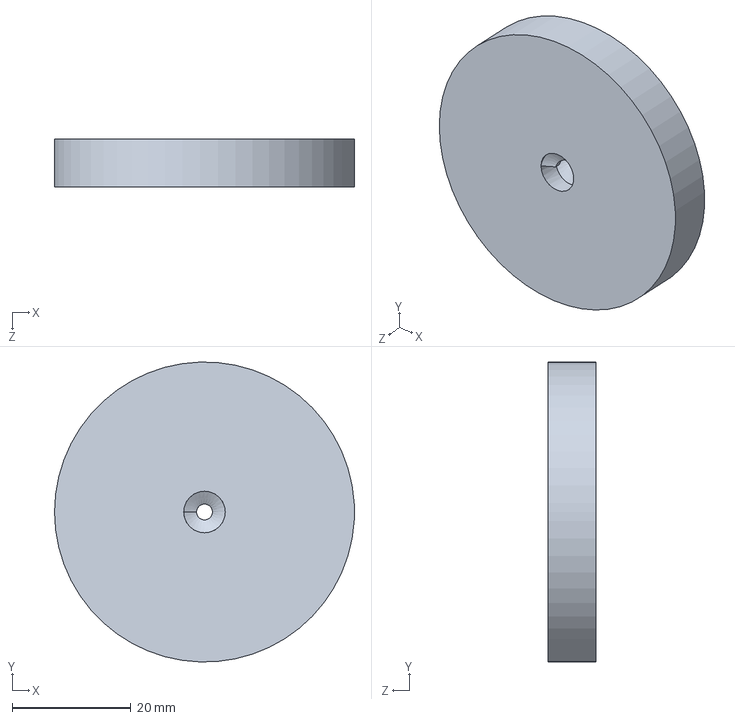
[picture p48: CAD file, 2026-01-31]
hardware/cad/ensamblaje_solidworks/Piston.SLDPRT
50.5 x 50.4 x 8.00 mm
