IngMiguelMartinez/cnc-3d-social-housing-thesis/hardware/cad/ensamblaje_solidworks/PF20-01 - Perfil 2020 básico.SLDPRT

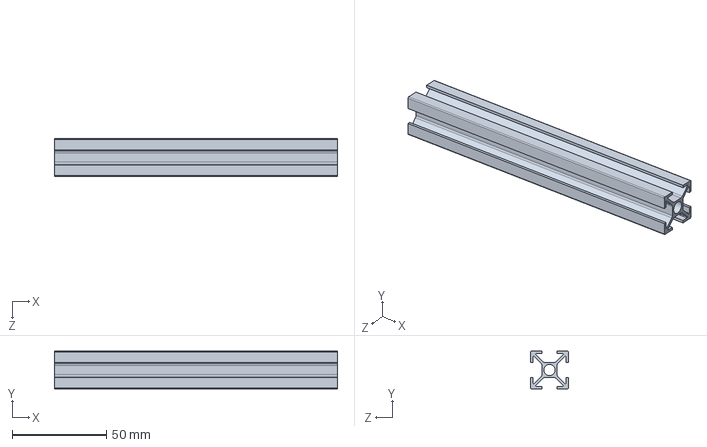
[picture p49: CAD file, 2026-01-31]
hardware/cad/ensamblaje_solidworks/PF20-01 - Perfil 2020 básico.SLDPRT
150.0 x 20.0 x 20.0 mm
