IngMiguelMartinez/cnc-3d-social-housing-thesis/hardware/cad/ensamblaje_solidworks/GearboxRV030Case.SLDPRT

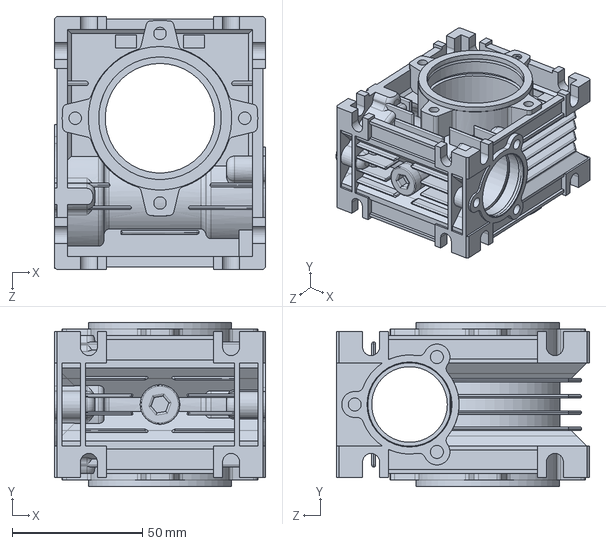
[picture p50: CAD file, 2026-01-31]
hardware/cad/ensamblaje_solidworks/GearboxRV030Case.SLDPRT
81.0 x 63.0 x 97.0 mm
