IngMiguelMartinez/cnc-3d-social-housing-thesis/hardware/cad/ensamblaje_solidworks/PrirubaDC300W.SLDPRT

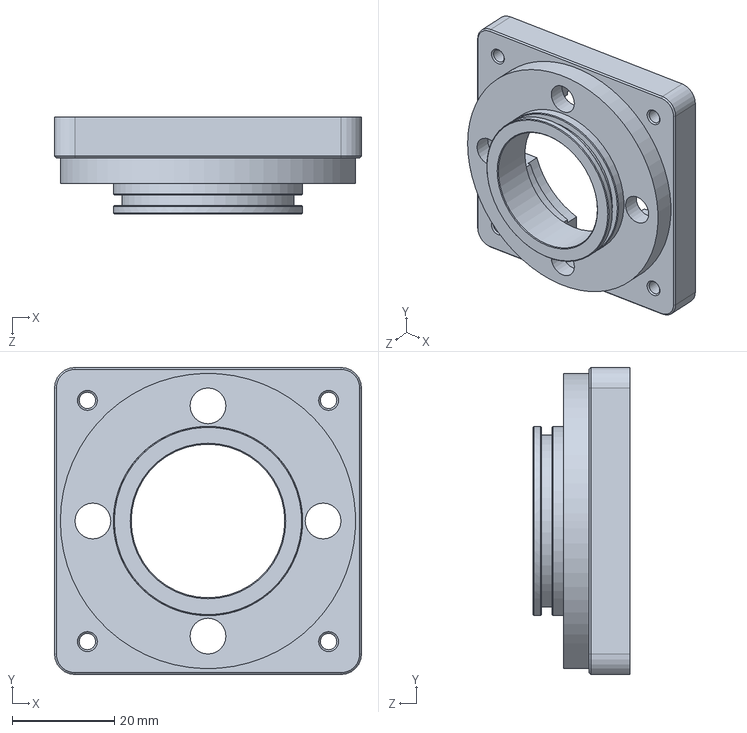
[picture p51: CAD file, 2026-01-31]
hardware/cad/ensamblaje_solidworks/PrirubaDC300W.SLDPRT
60.0 x 60.0 x 19.0 mm
