IngMiguelMartinez/cnc-3d-social-housing-thesis/hardware/cad/ensamblaje_solidworks/HridelSnek.SLDPRT

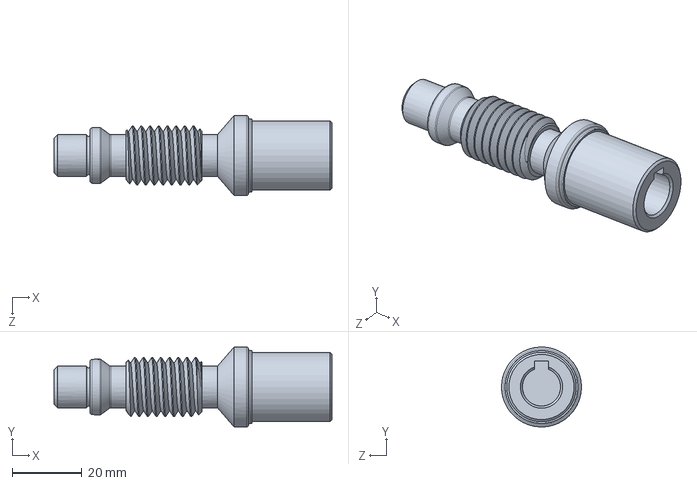
[picture p52: CAD file, 2026-01-31]
hardware/cad/ensamblaje_solidworks/HridelSnek.SLDPRT
80.0 x 23.0 x 23.0 mm
