IngMiguelMartinez/cnc-3d-social-housing-thesis/hardware/cad/ensamblaje_solidworks/carro eje X.SLDPRT

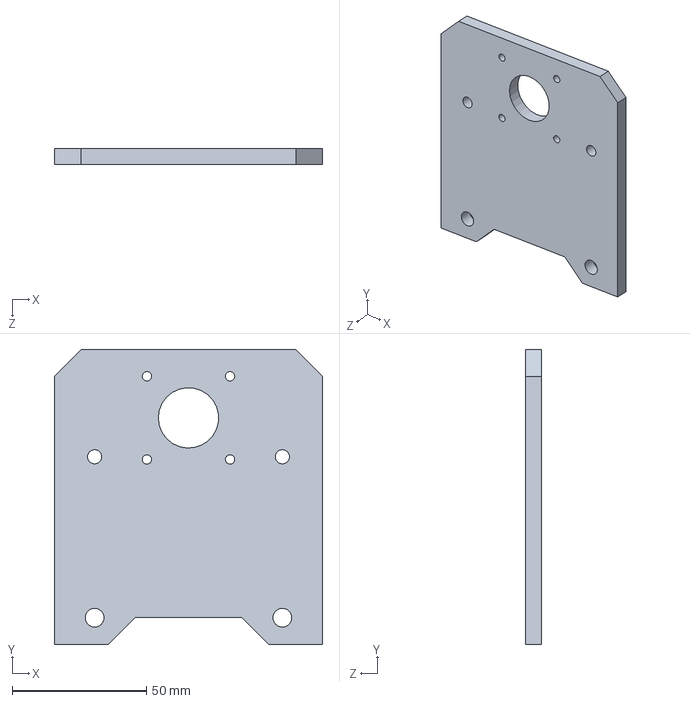
[picture p53: CAD file, 2026-01-31]
hardware/cad/ensamblaje_solidworks/carro eje X.SLDPRT
100.0 x 110.0 x 6.00 mm
