IngMiguelMartinez/cnc-3d-social-housing-thesis/hardware/cad/ensamblaje_solidworks/Pieza85.SLDPRT

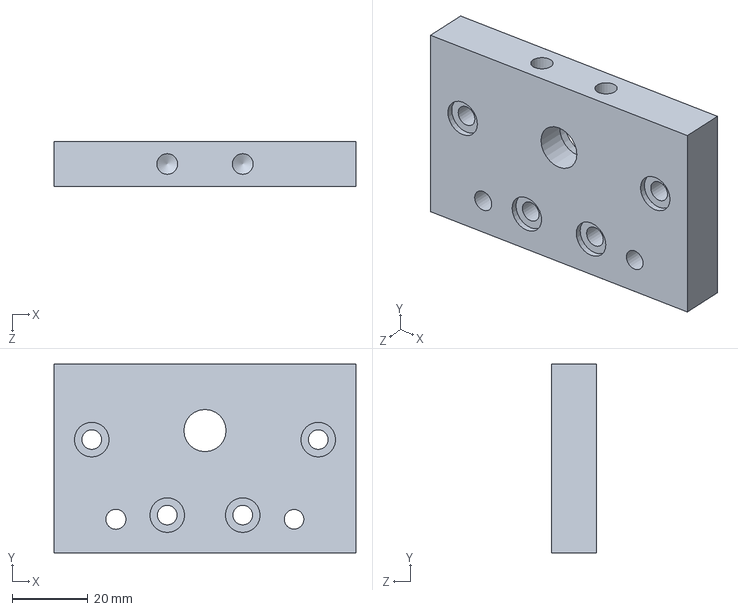
[picture p54: CAD file, 2026-01-31]
hardware/cad/ensamblaje_solidworks/Pieza85.SLDPRT
80.0 x 50.0 x 12.0 mm
