IngMiguelMartinez/cnc-3d-social-housing-thesis/hardware/cad/ensamblaje_solidworks/Precision Shim 8 x 5 x 1.SLDPRT

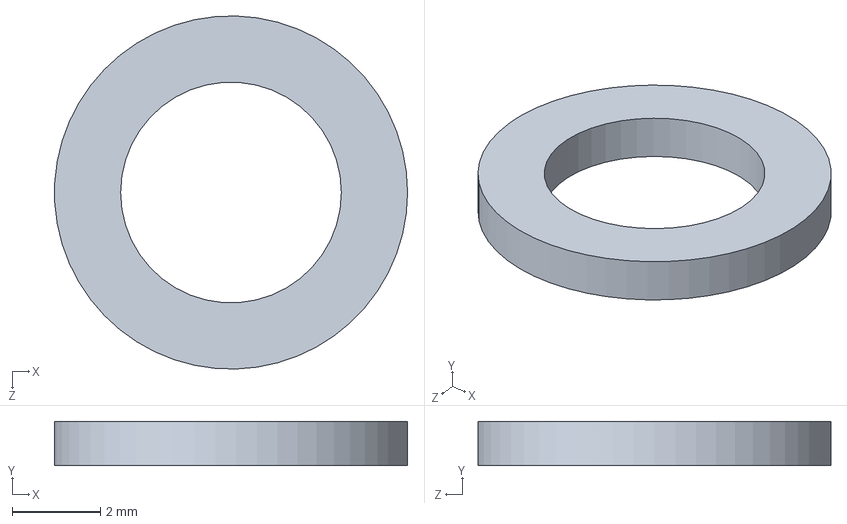
[picture p55: CAD file, 2026-01-31]
hardware/cad/ensamblaje_solidworks/Precision Shim 8 x 5 x 1.SLDPRT
8.00 x 1.00 x 8.00 mm
