IngMiguelMartinez/cnc-3d-social-housing-thesis/hardware/cad/ensamblaje_solidworks/PF20-13 - Perfil 4080 C-Beam.SLDPRT

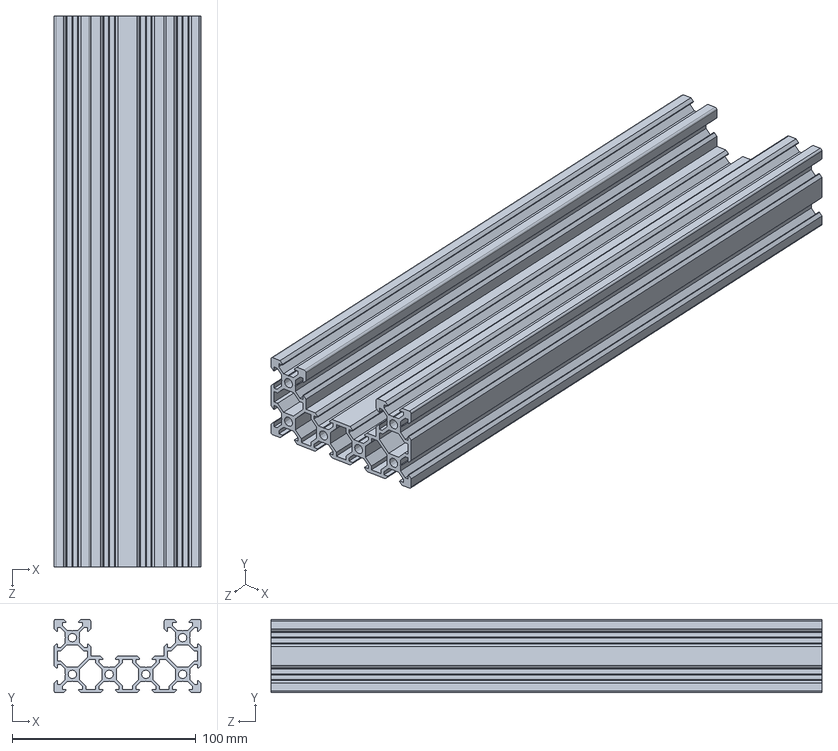
[picture p56: CAD file, 2026-01-31]
hardware/cad/ensamblaje_solidworks/PF20-13 - Perfil 4080 C-Beam.SLDPRT
80.0 x 40.0 x 300.0 mm
