IngMiguelMartinez/cnc-3d-social-housing-thesis/hardware/cad/ensamblaje_solidworks/Gufero7x47x25.SLDPRT

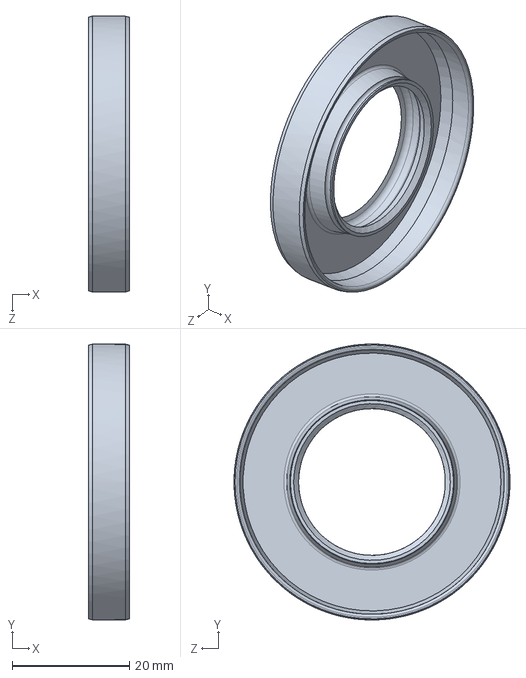
[picture p57: CAD file, 2026-01-31]
hardware/cad/ensamblaje_solidworks/Gufero7x47x25.SLDPRT
7.00 x 47.0 x 47.0 mm
