IngMiguelMartinez/cnc-3d-social-housing-thesis/hardware/cad/ensamblaje_solidworks/Mini Eccentric Spacer 6mm.SLDPRT

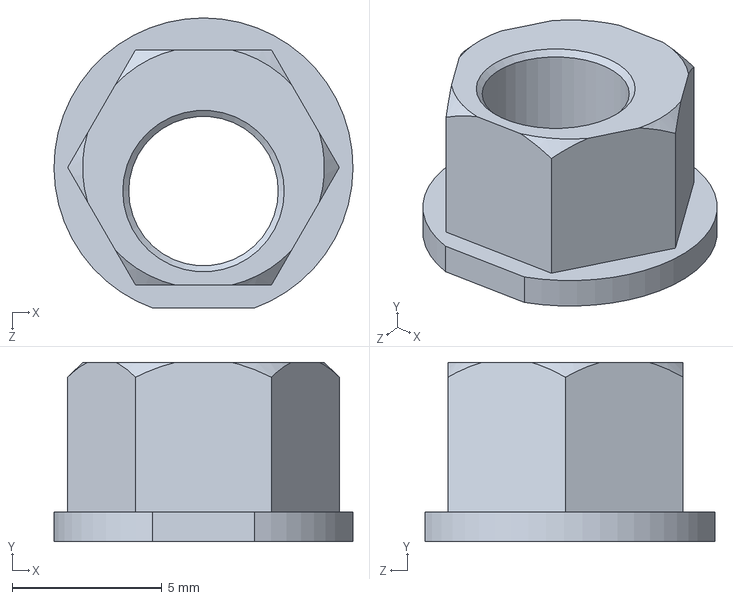
[picture p58: CAD file, 2026-01-31]
hardware/cad/ensamblaje_solidworks/Mini Eccentric Spacer 6mm.SLDPRT
10.00 x 6.00 x 9.70 mm
