IngMiguelMartinez/cnc-3d-social-housing-thesis/hardware/cad/ensamblaje_solidworks/Ball Bearing 5 x 10 x 4.2.SLDPRT

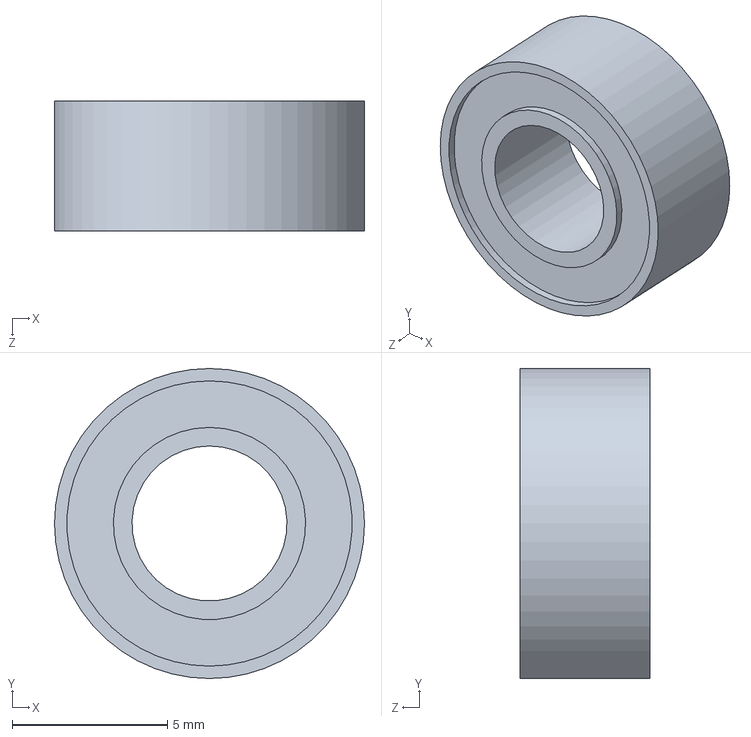
[picture p59: CAD file, 2026-01-31]
hardware/cad/ensamblaje_solidworks/Ball Bearing 5 x 10 x 4.2.SLDPRT
10.0 x 10.0 x 4.20 mm
