IngMiguelMartinez/cnc-3d-social-housing-thesis/hardware/cad/ensamblaje_solidworks/Pojistny Krouzek DIN 472.SLDPRT

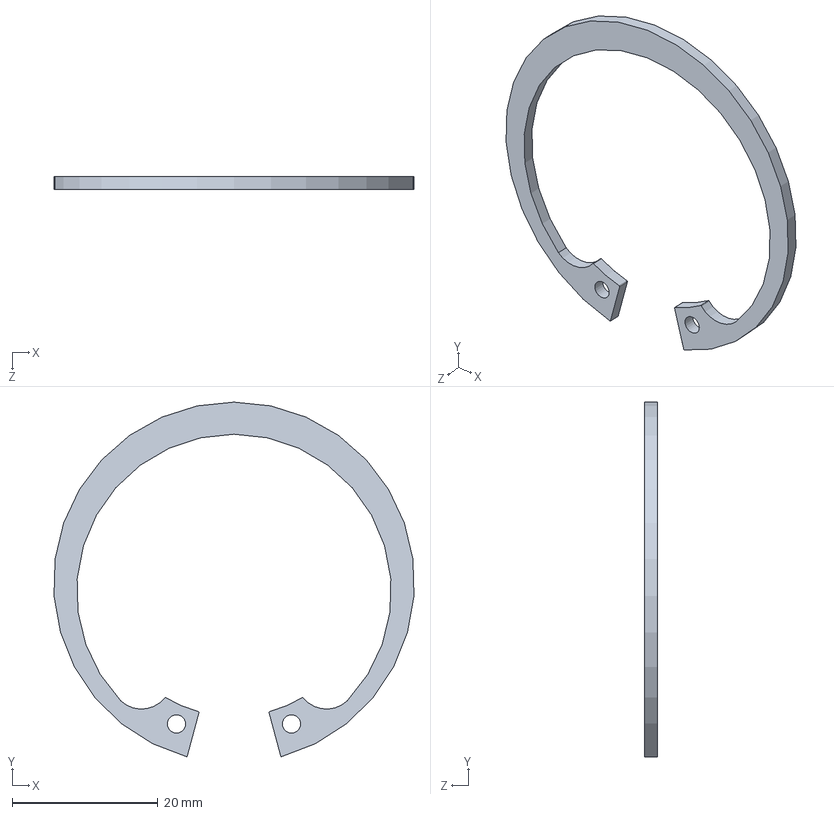
[picture p60: CAD file, 2026-01-31]
hardware/cad/ensamblaje_solidworks/Pojistny Krouzek DIN 472.SLDPRT
49.4 x 48.6 x 1.75 mm
