IngMiguelMartinez/cnc-3d-social-housing-thesis/hardware/cad/ensamblaje_solidworks/Espaciador de aluminio 3mm.SLDPRT

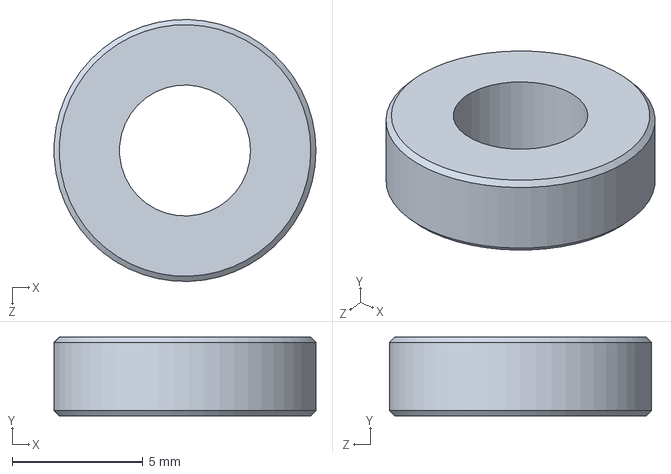
[picture p61: CAD file, 2026-01-31]
hardware/cad/ensamblaje_solidworks/Espaciador de aluminio 3mm.SLDPRT
10.0 x 3.00 x 10.00 mm
