IngMiguelMartinez/cnc-3d-social-housing-thesis/hardware/cad/ensamblaje_solidworks/Preliminar soporte boquilla.SLDPRT

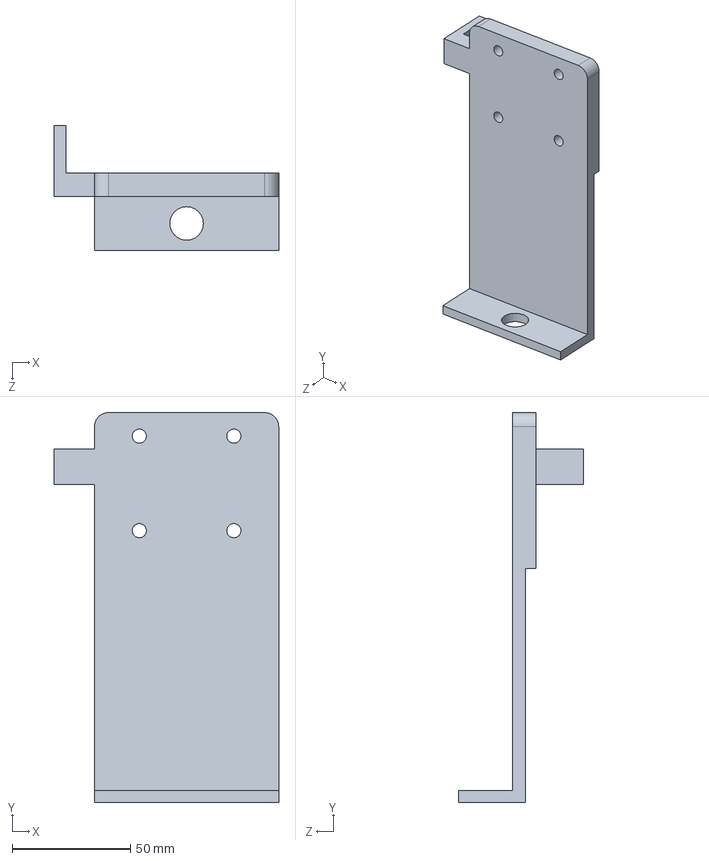
[picture p62: CAD file, 2026-01-31]
hardware/cad/ensamblaje_solidworks/Preliminar soporte boquilla.SLDPRT
95.0 x 165.0 x 52.7 mm
