IngMiguelMartinez/cnc-3d-social-housing-thesis/hardware/cad/ensamblaje_solidworks/Soporte boquilla.3mf

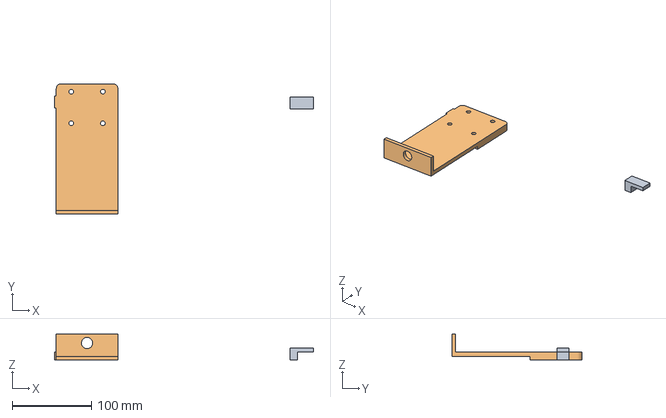
[picture p63: CAD file, 2026-01-31]
hardware/cad/ensamblaje_solidworks/Soporte boquilla.3mf
327.6 x 165.0 x 32.7 mm
Soporte boquilla.STL x 2
