IngMiguelMartinez/cnc-3d-social-housing-thesis/hardware/cad/ensamblaje_solidworks/Tapa.SLDPRT

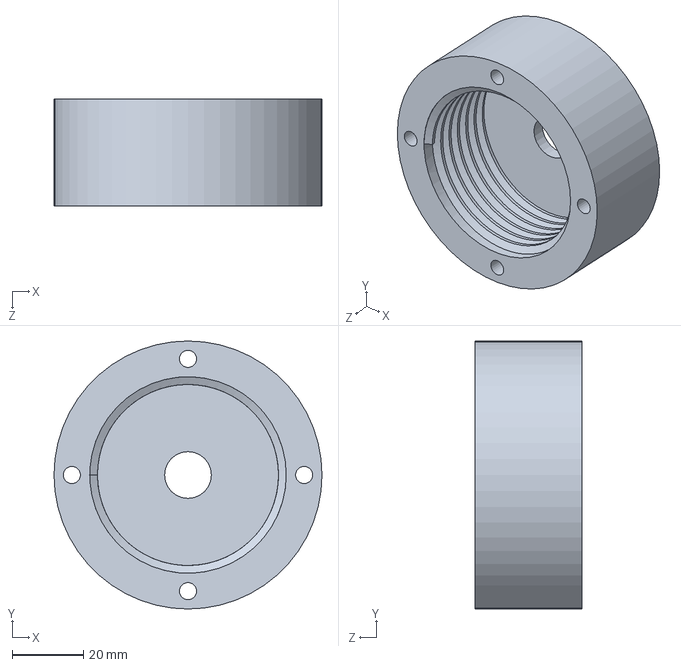
[picture p64: CAD file, 2026-01-31]
hardware/cad/ensamblaje_solidworks/Tapa.SLDPRT
75.0 x 75.0 x 30.0 mm
