IngMiguelMartinez/cnc-3d-social-housing-thesis/hardware/cad/ensamblaje_solidworks/rueda.SLDPRT

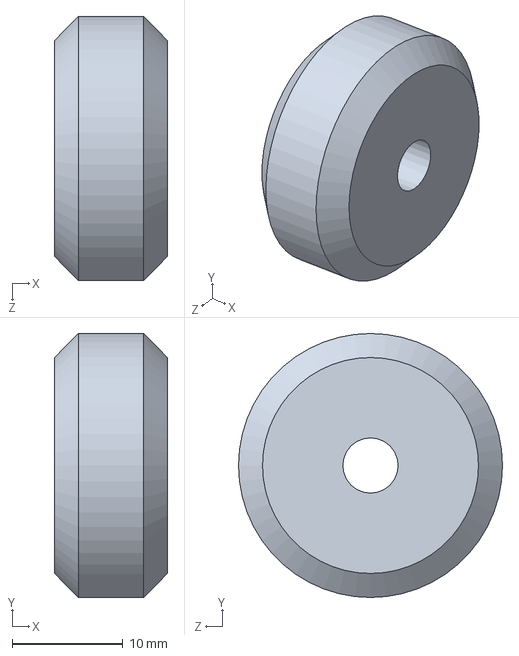
[picture p65: CAD file, 2026-01-31]
hardware/cad/ensamblaje_solidworks/rueda.SLDPRT
10.2 x 23.9 x 23.9 mm
