IngMiguelMartinez/cnc-3d-social-housing-thesis/(list of files, cad)

Other CAD files:
hardware/cad/ensamblaje_solidworks/Rueda_ensamblZ.SLDASM
hardware/cad/ensamblaje_solidworks/tensor_correa.SLDPRT
hardware/cad/ensamblaje_solidworks/Acople FlexibleSLDPRT.SLDPRT
hardware/cad/ensamblaje_solidworks/Low Profile Screw M5 [20mm].SLDPRT
hardware/cad/ensamblaje_solidworks/Low Profile Screw M5 [25mm].SLDPRT
hardware/cad/ensamblaje_solidworks/Nylon Insert Lock Nut M5.SLDPRT
hardware/cad/ensamblaje_solidworks/Soporte boquilla.STL
