IngMiguelMartinez/cnc-3d-social-housing-thesis/hardware/planos/planos.pdf

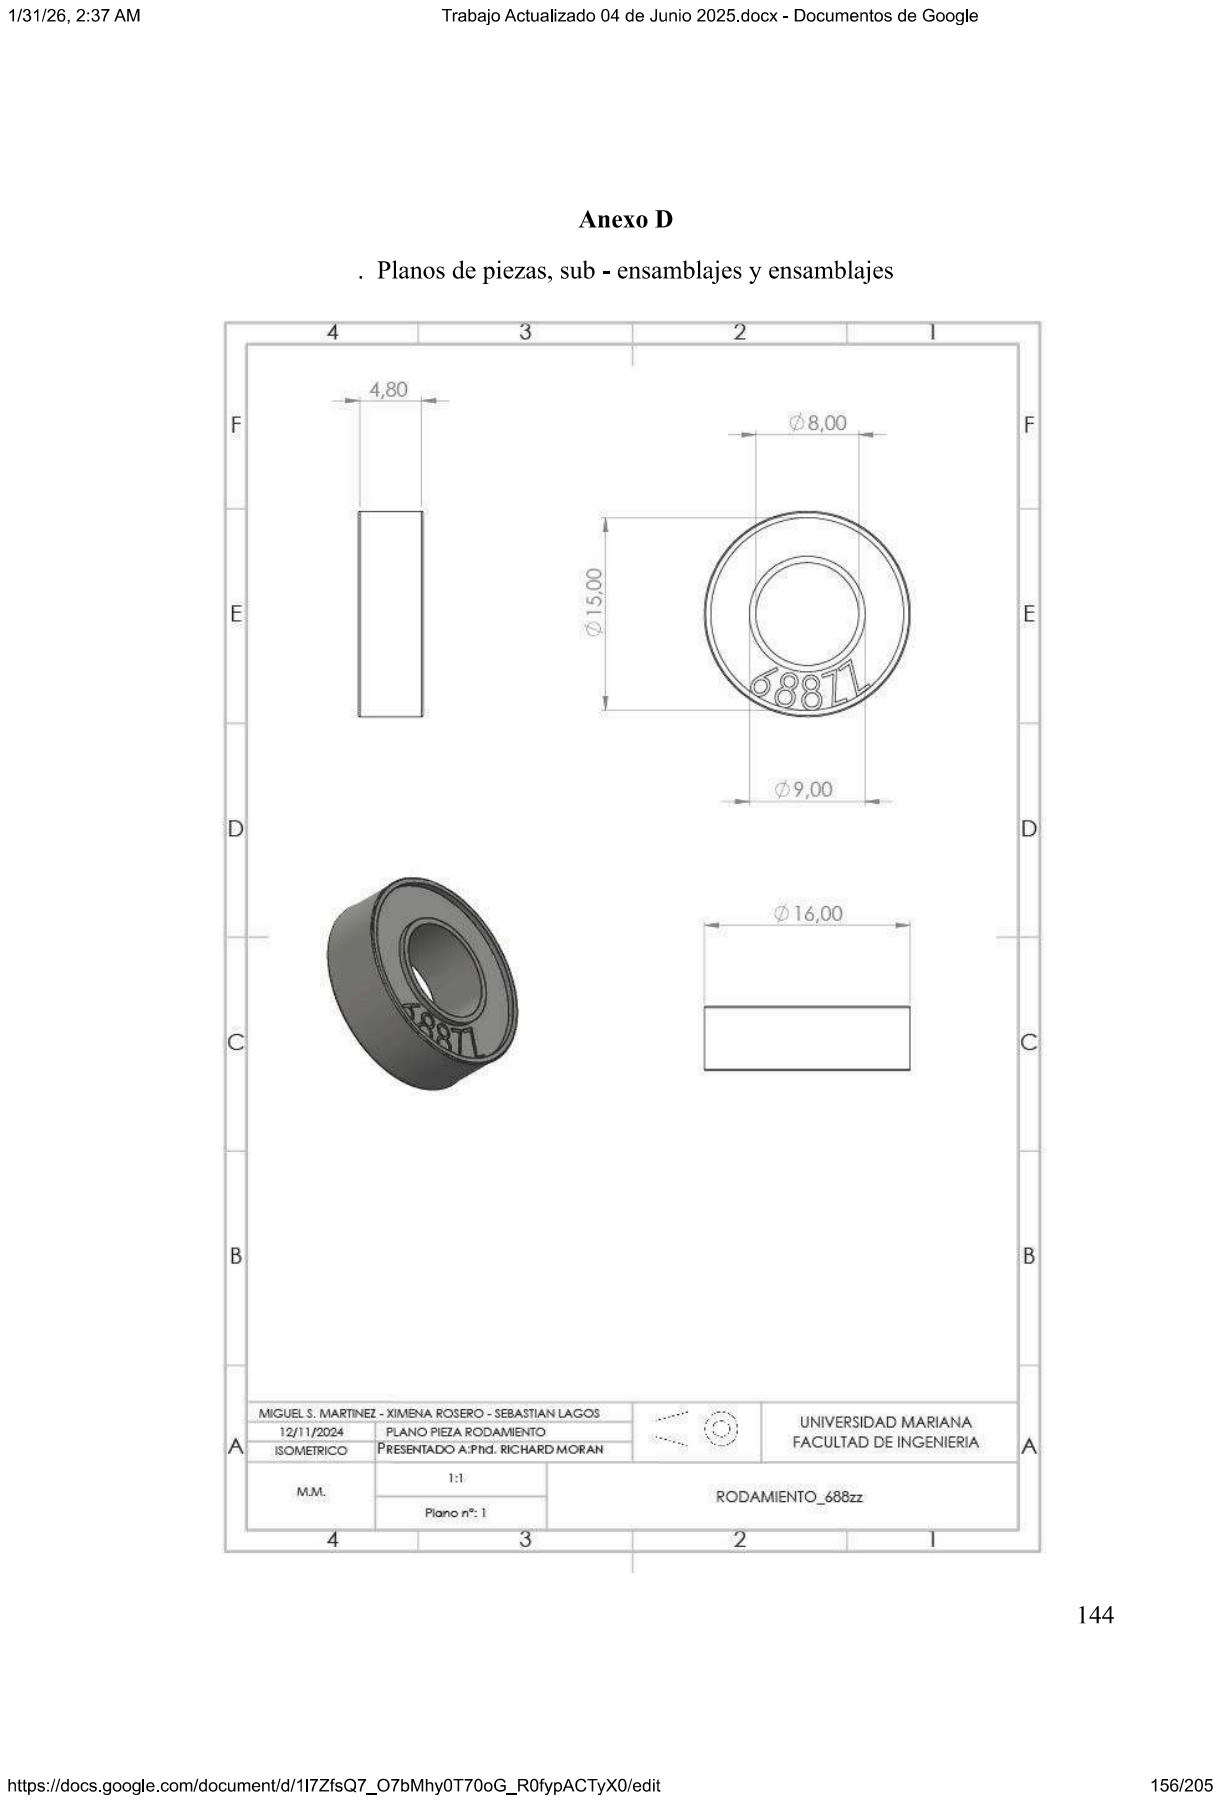
[picture p78: page 1]

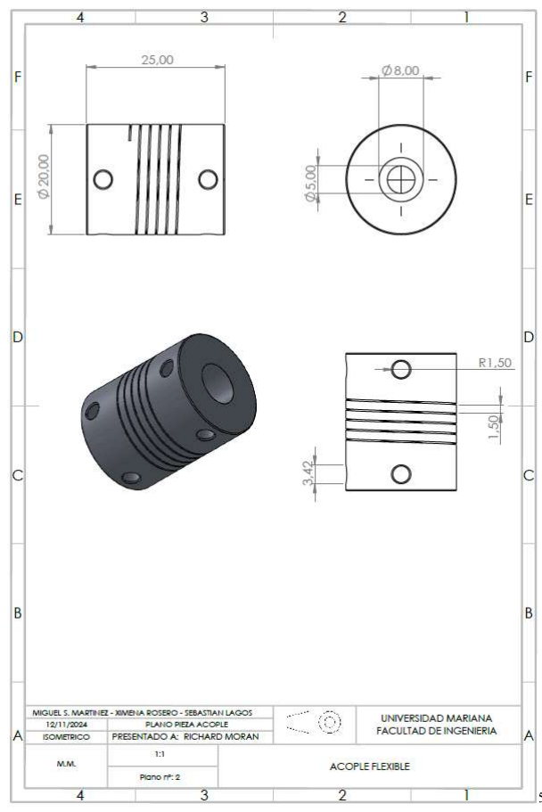
[picture p79: figure]
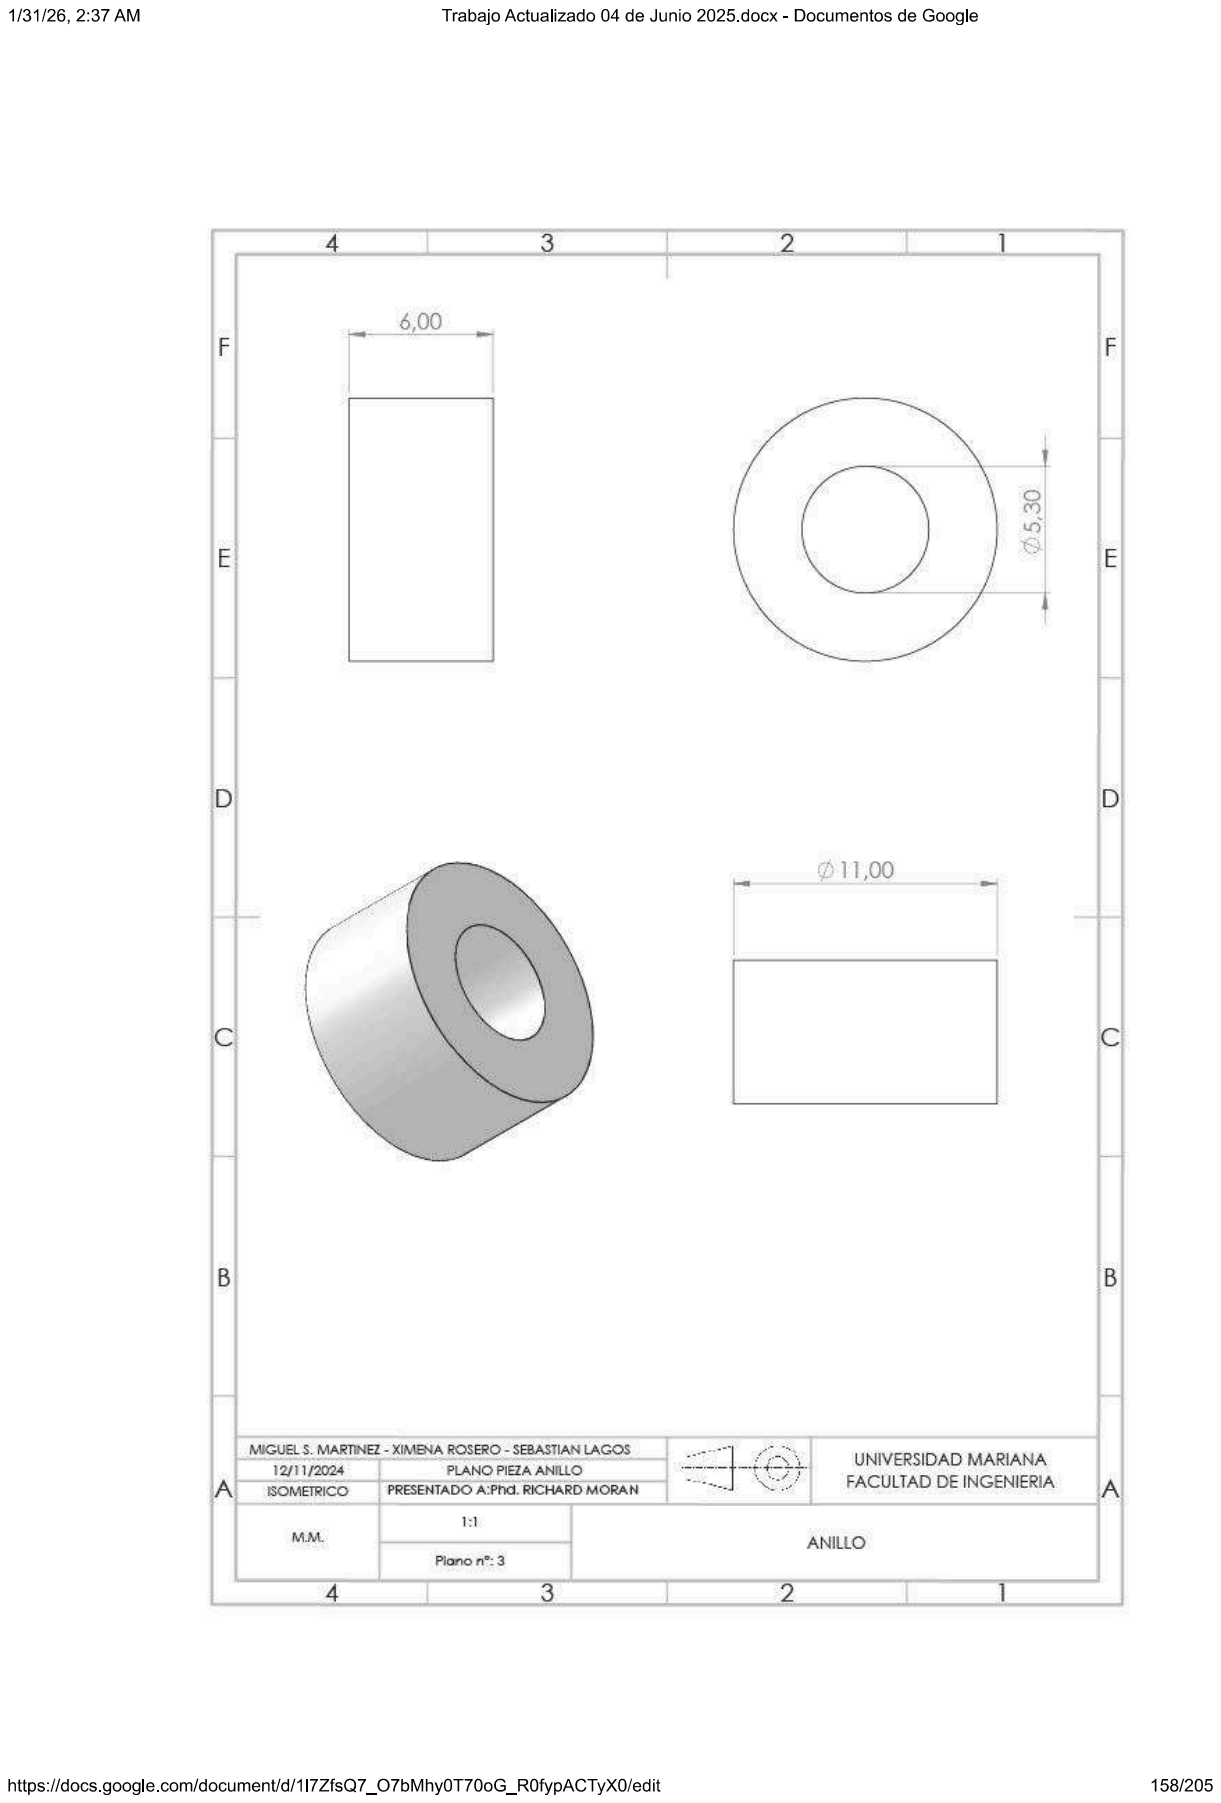
[picture p80: page 3]

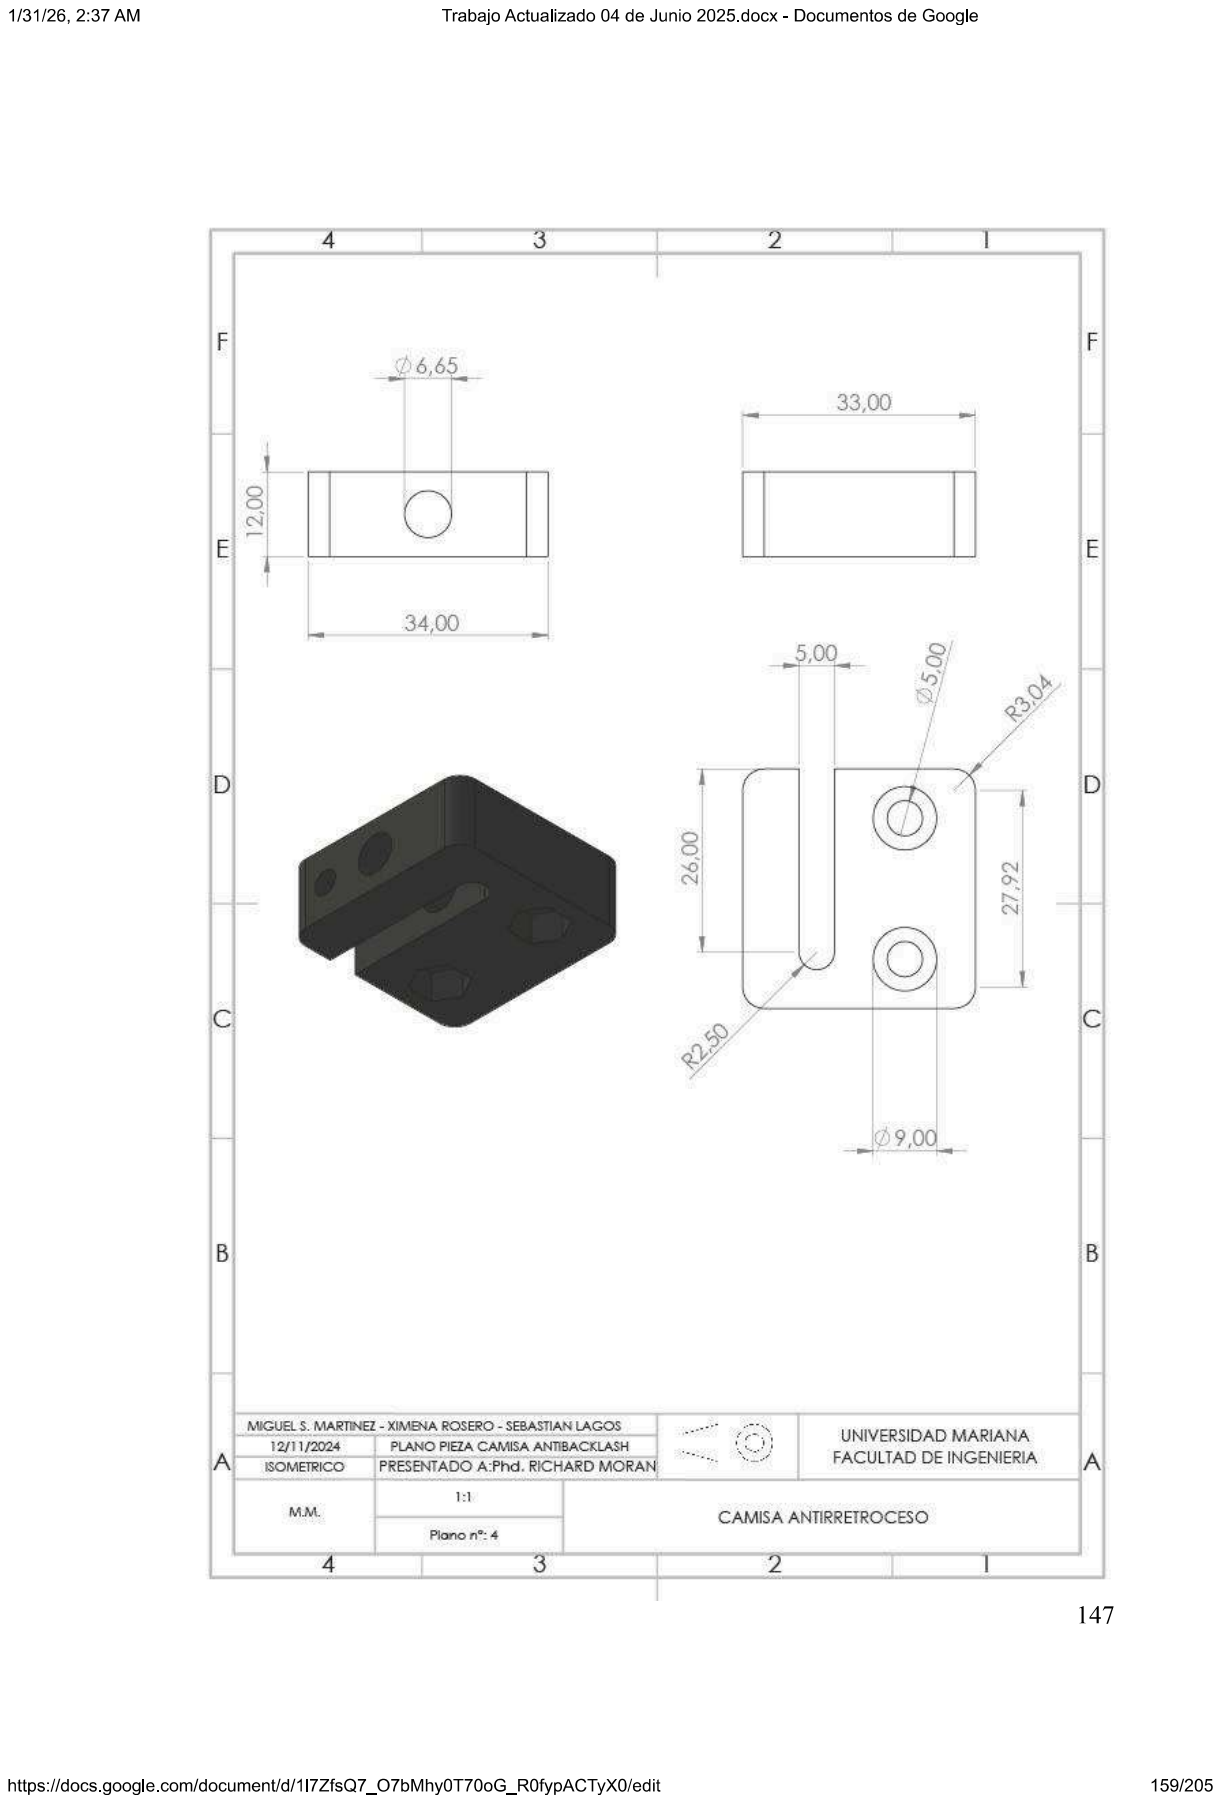
[picture p81: page 4]

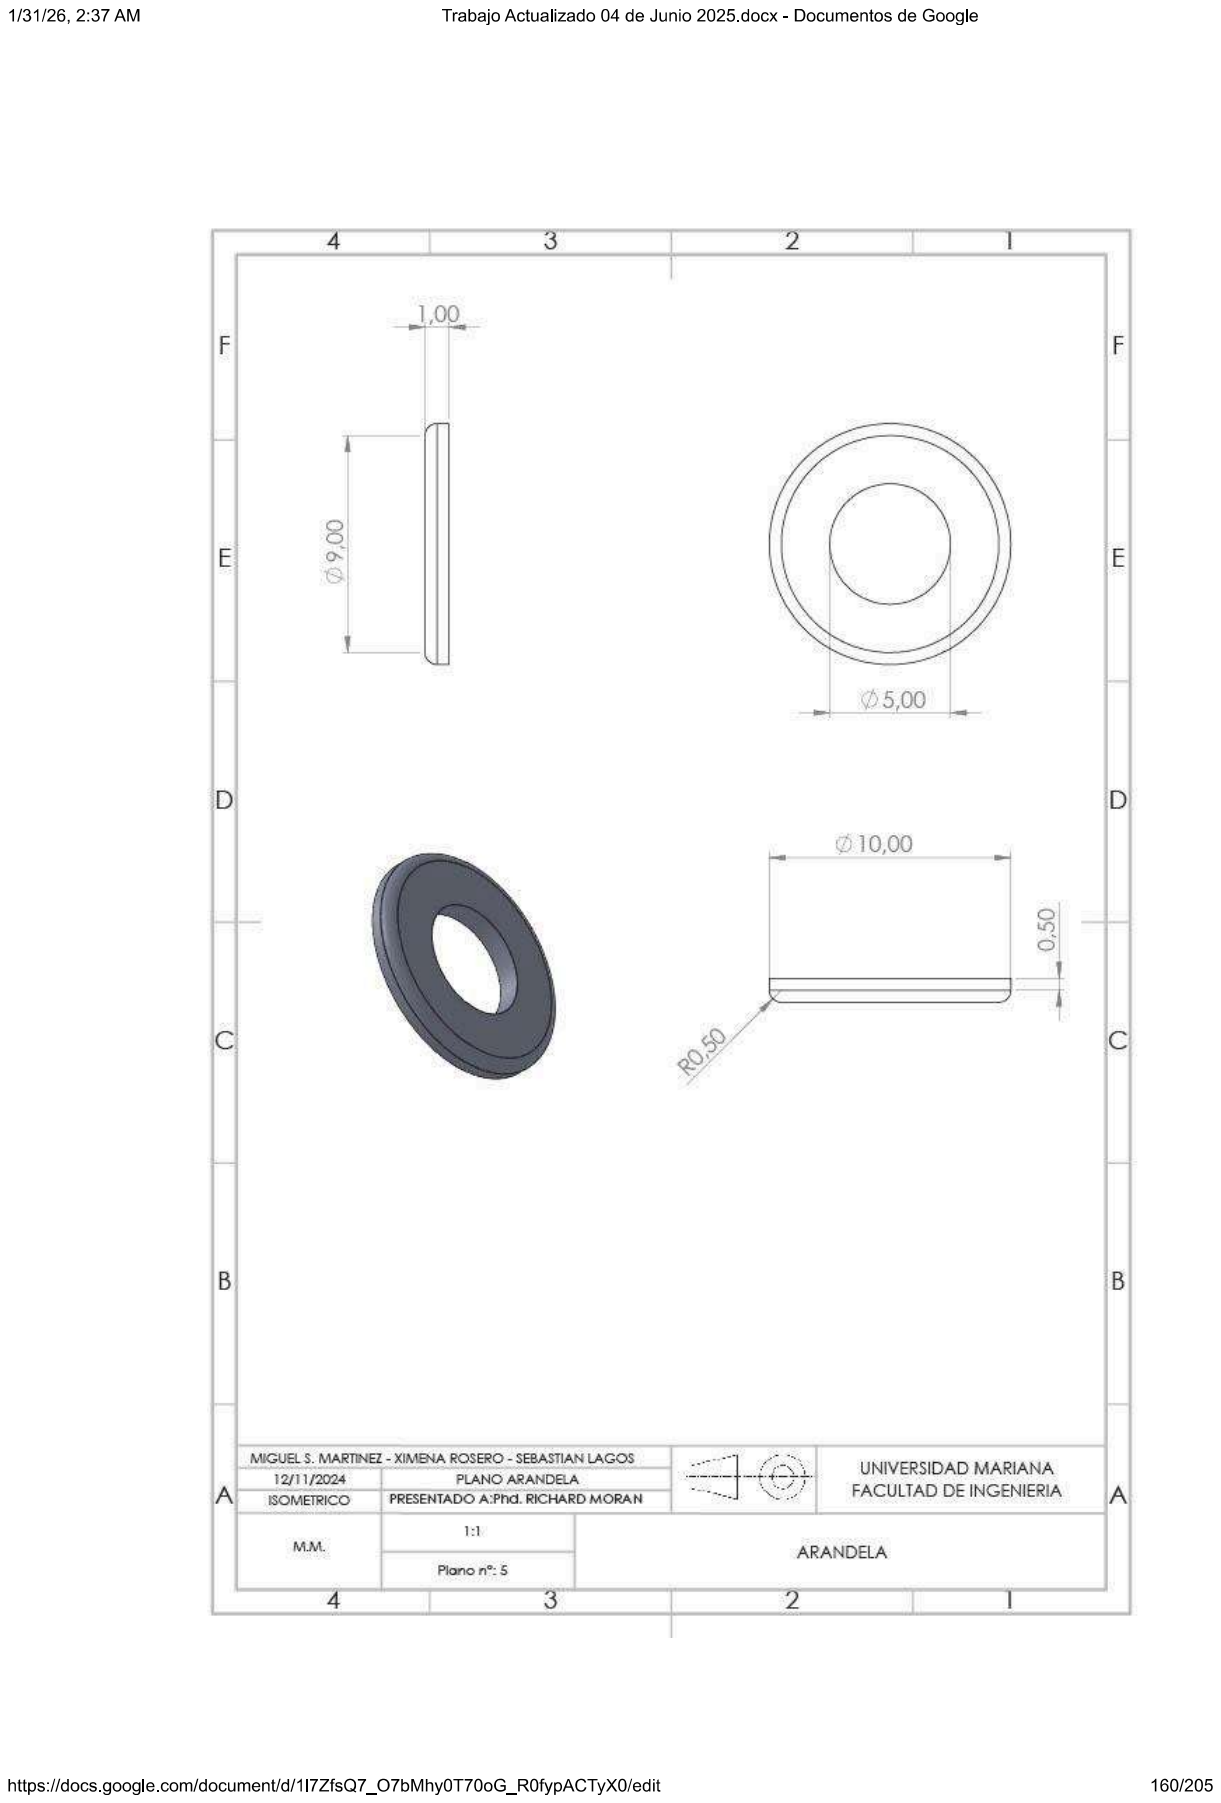
[picture p82: page 5]

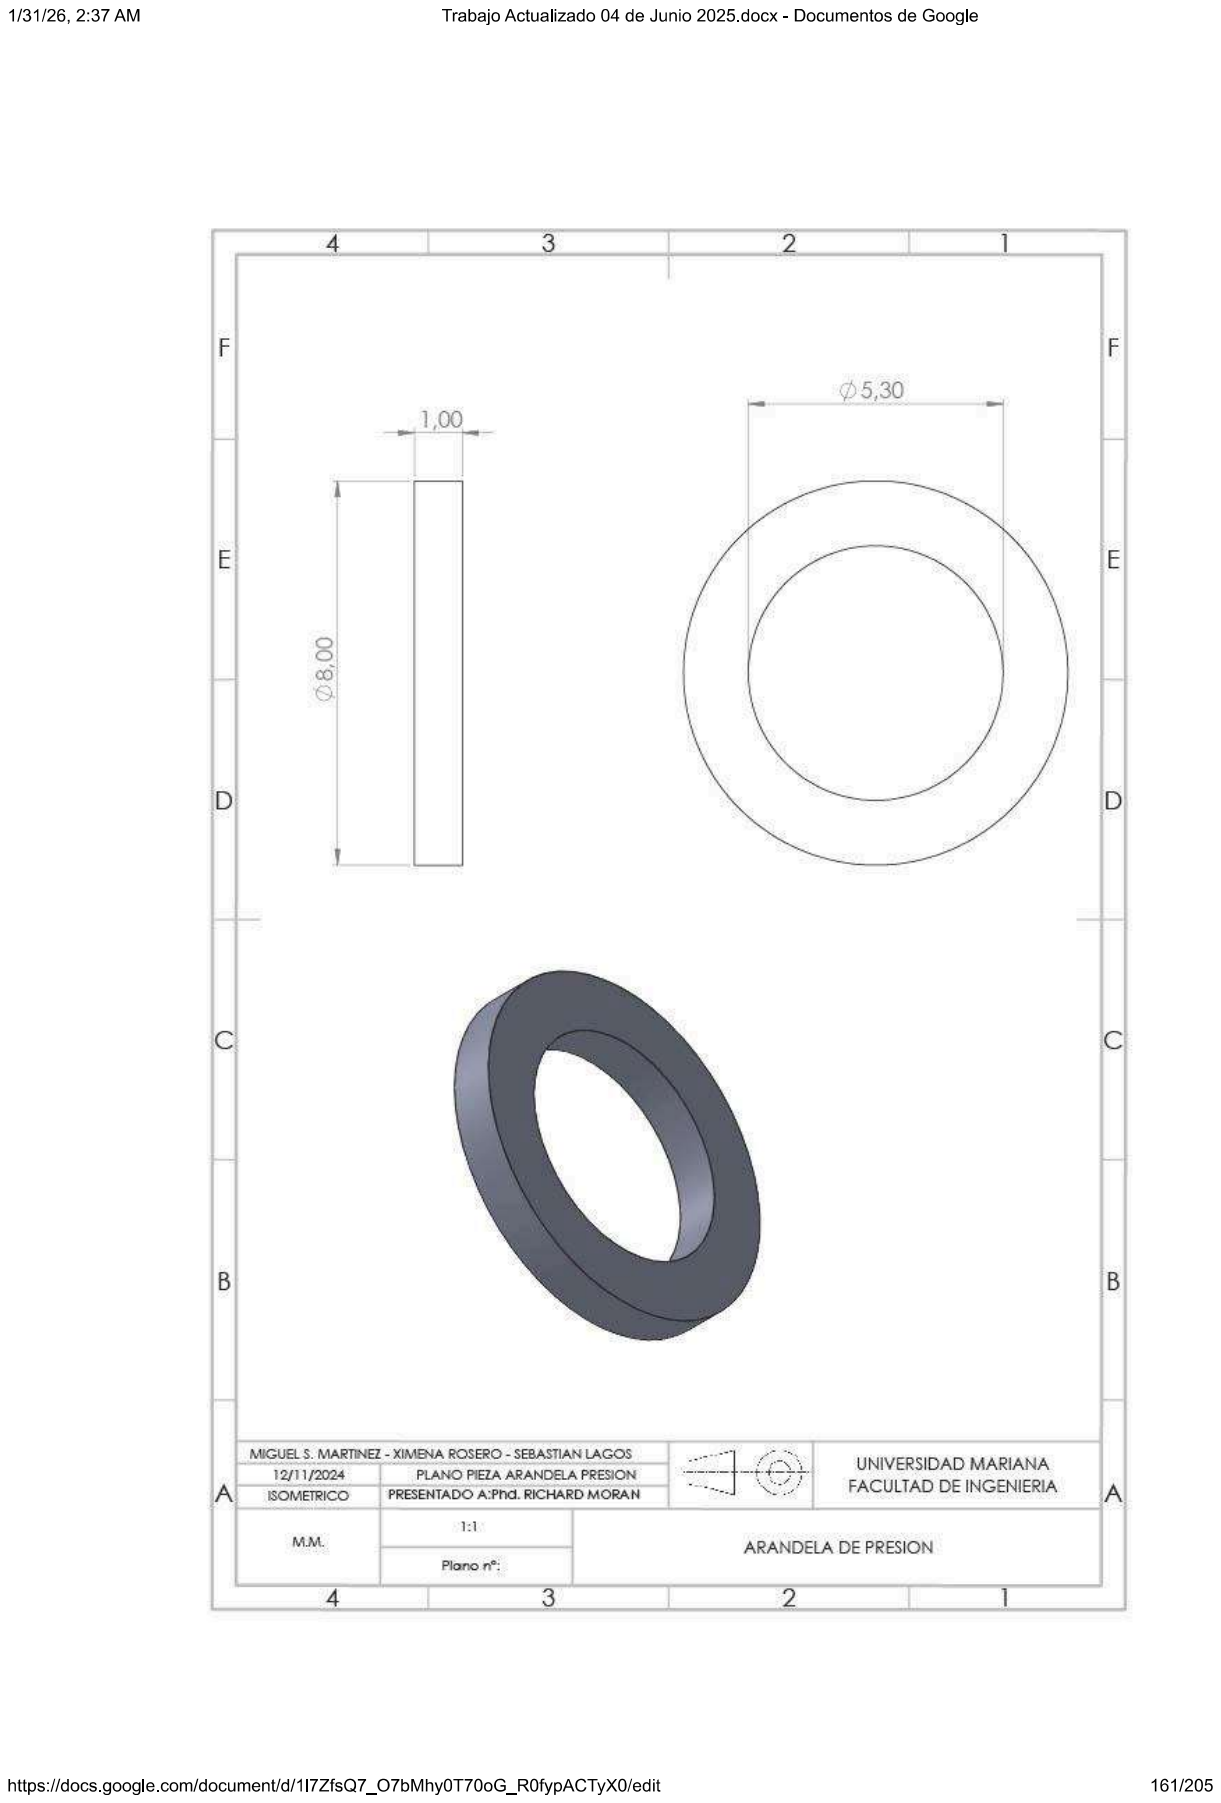
[picture p83: page 6]

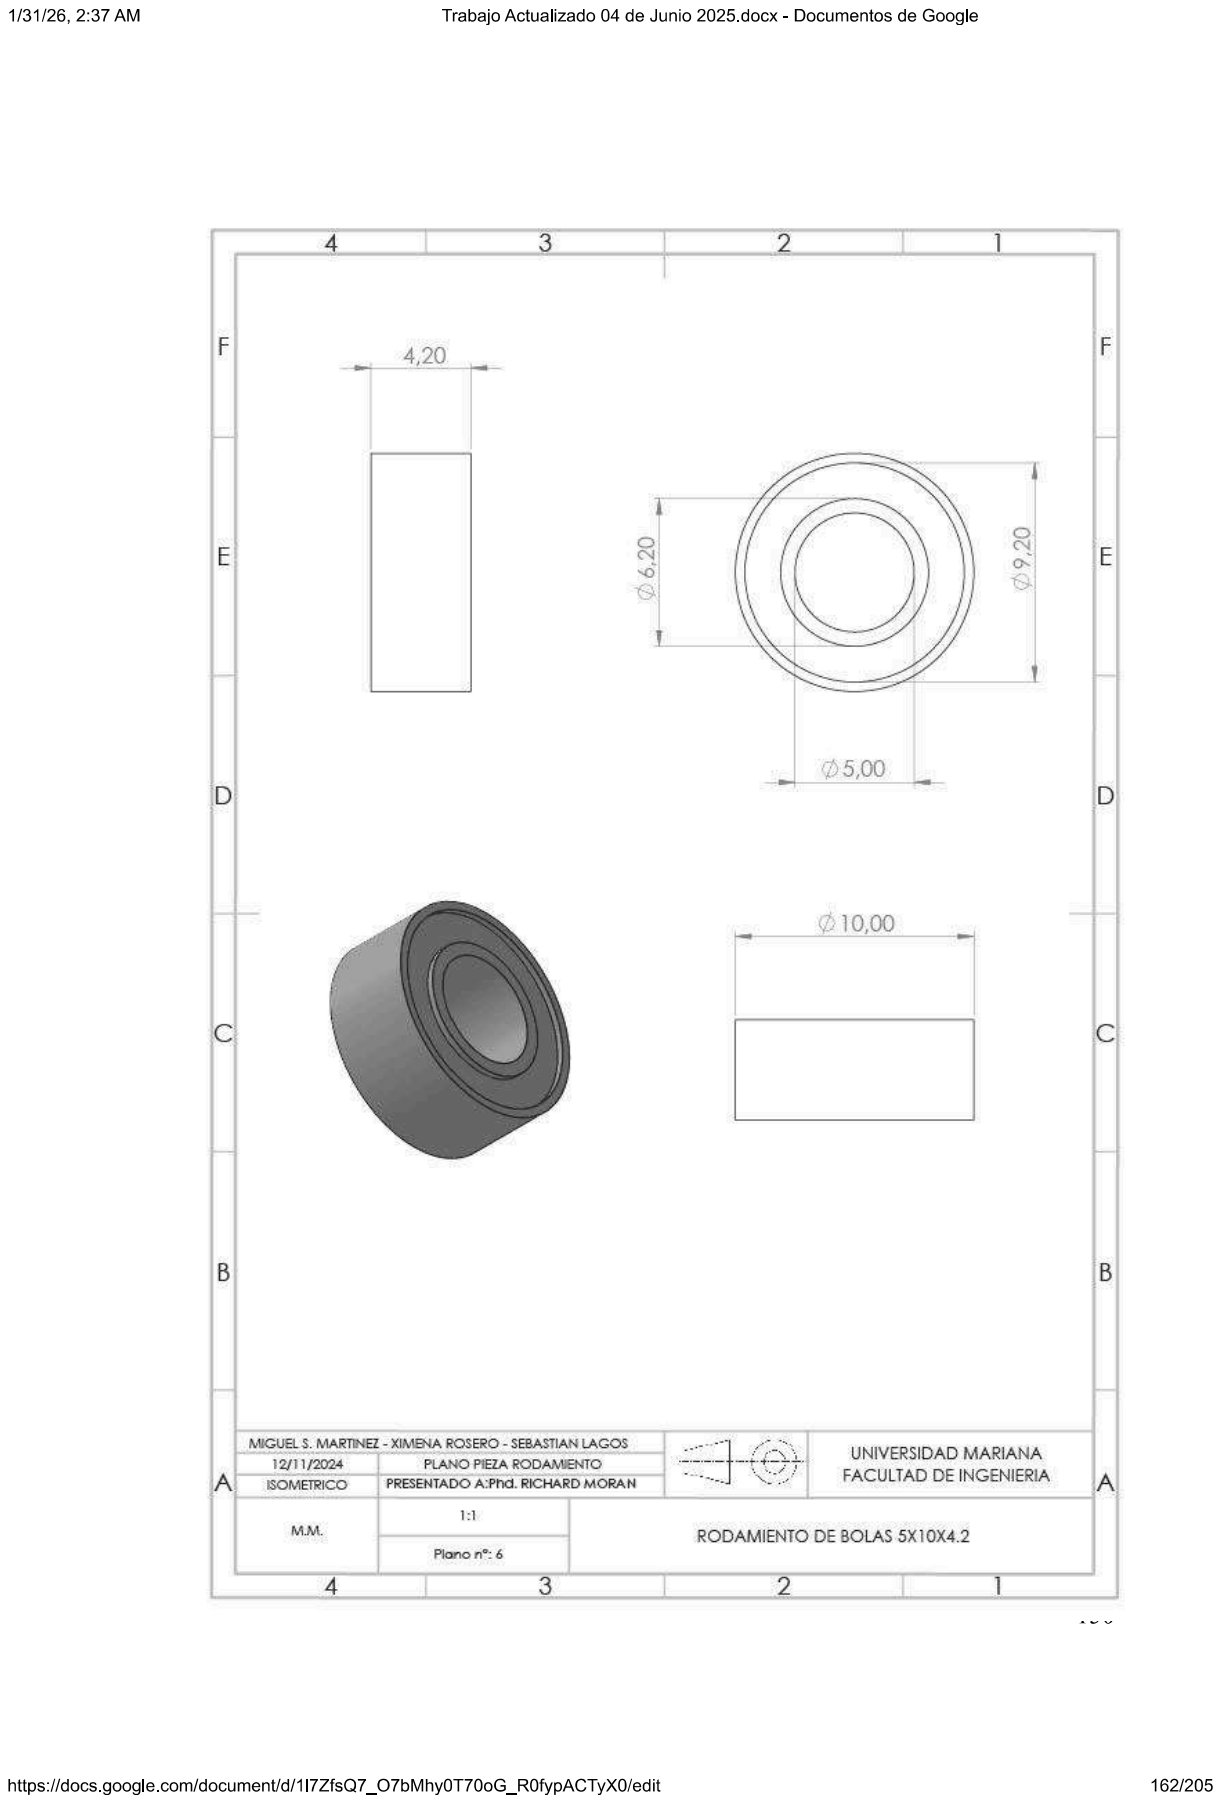
[picture p84: page 7]

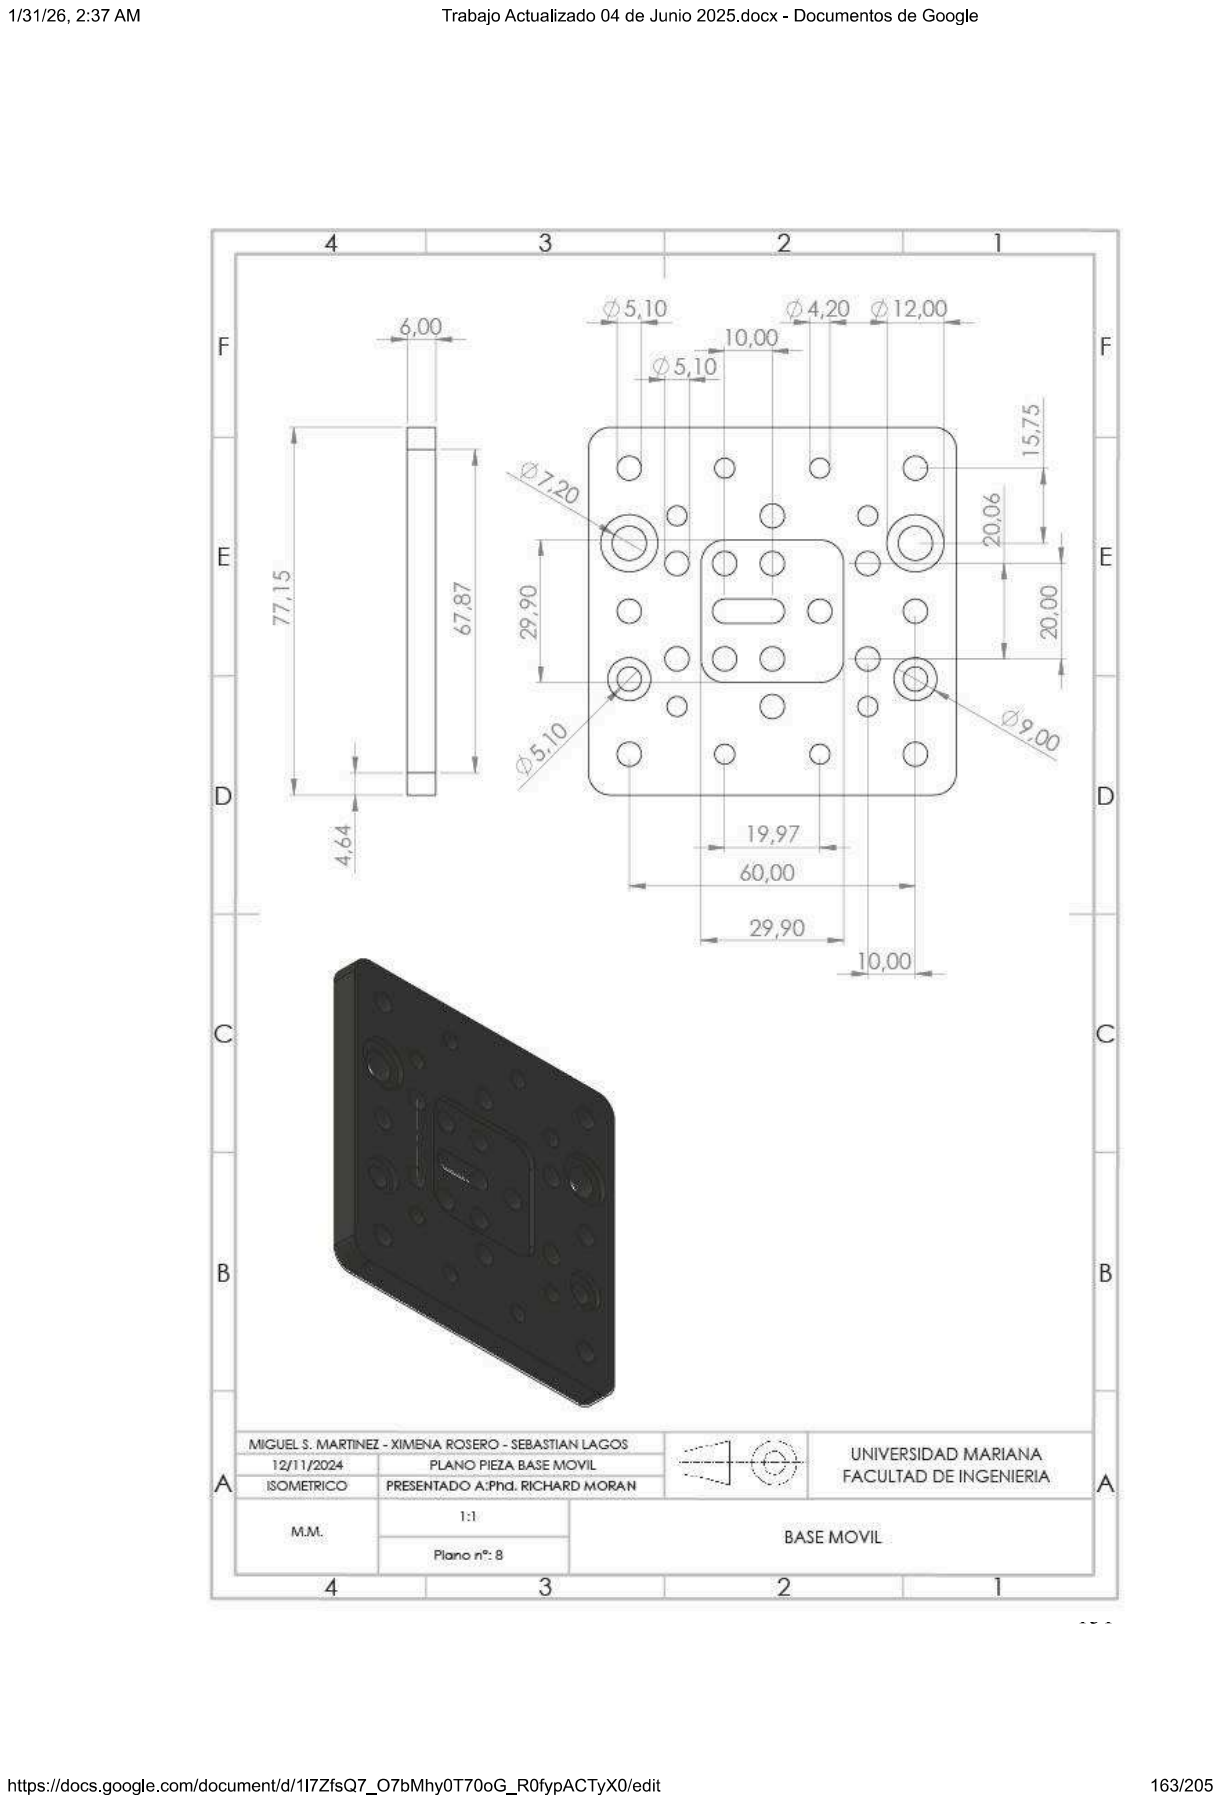
[picture p85: page 8]

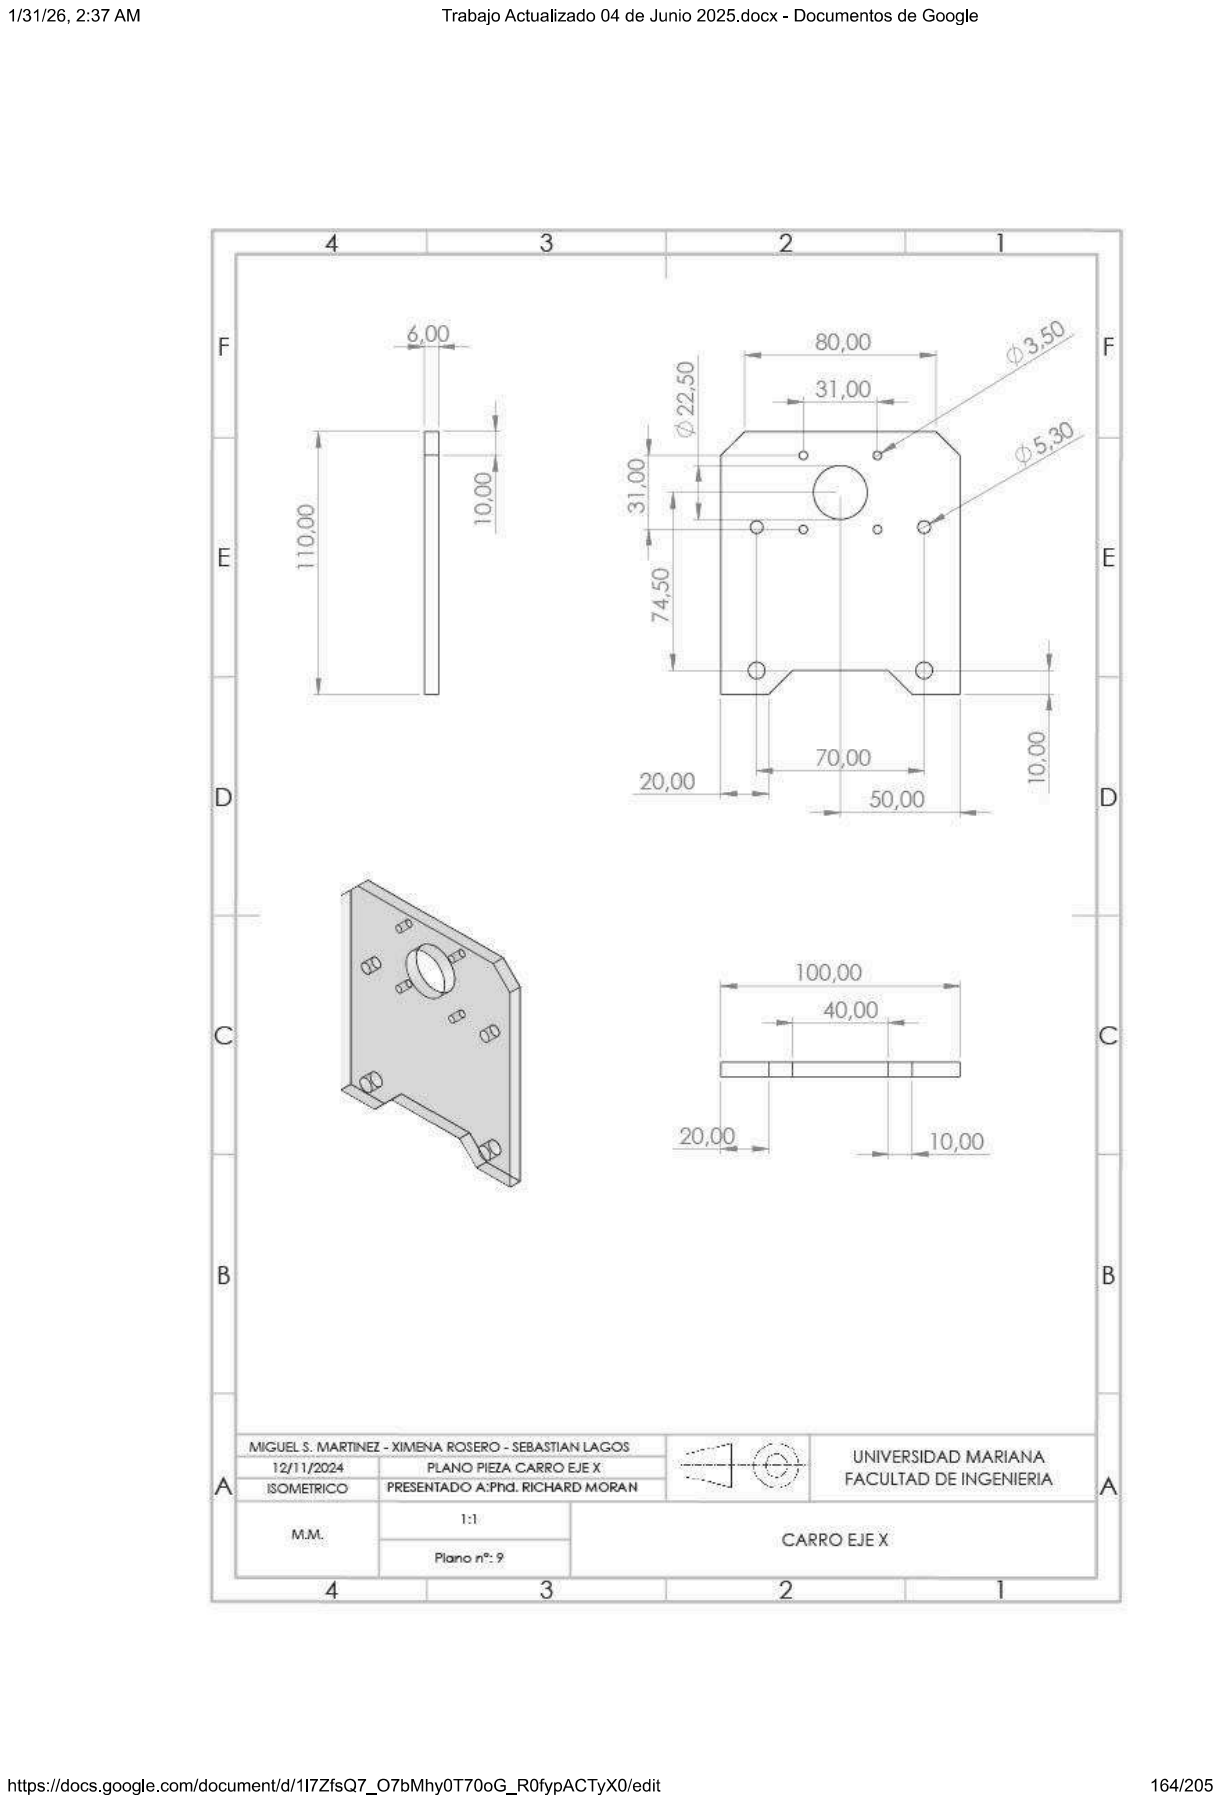
[picture p86: page 9]

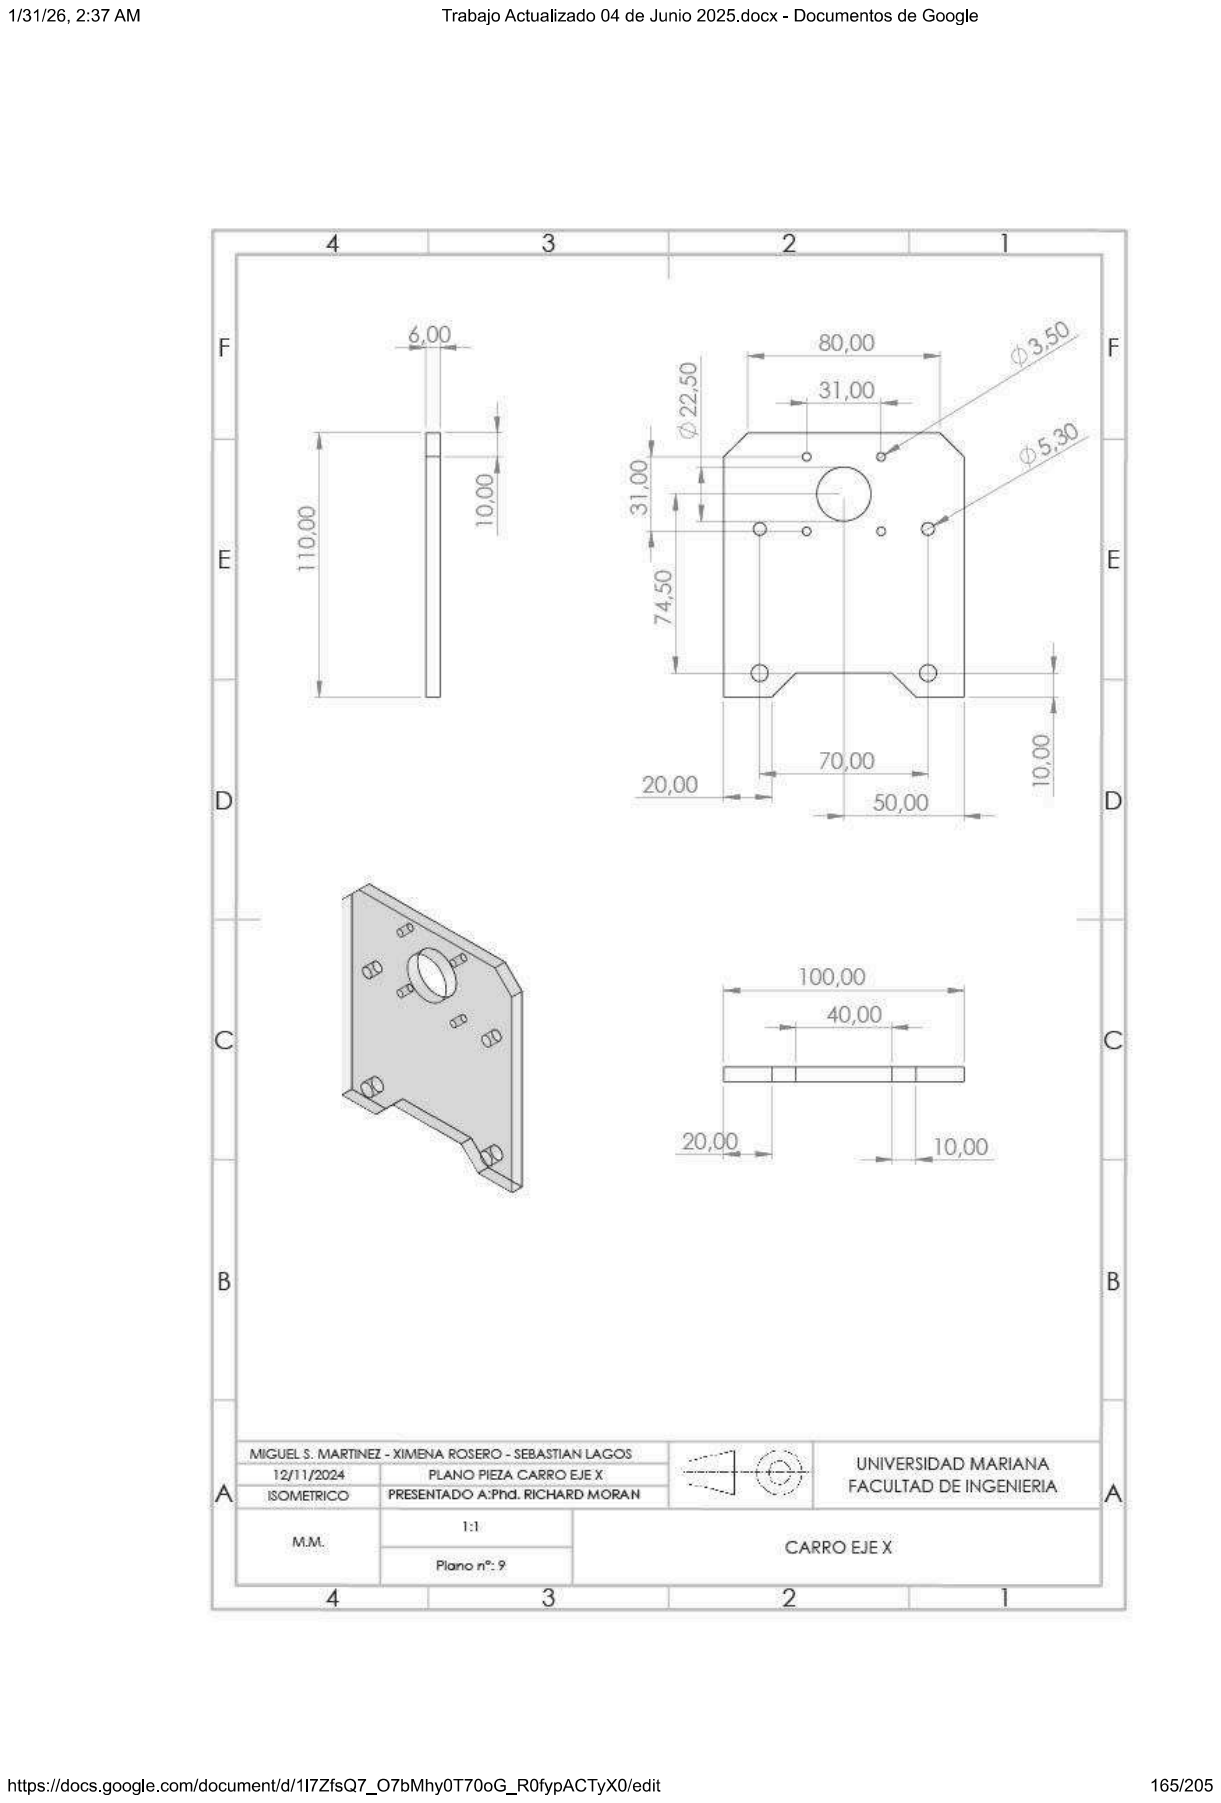
[picture p87: page 10]

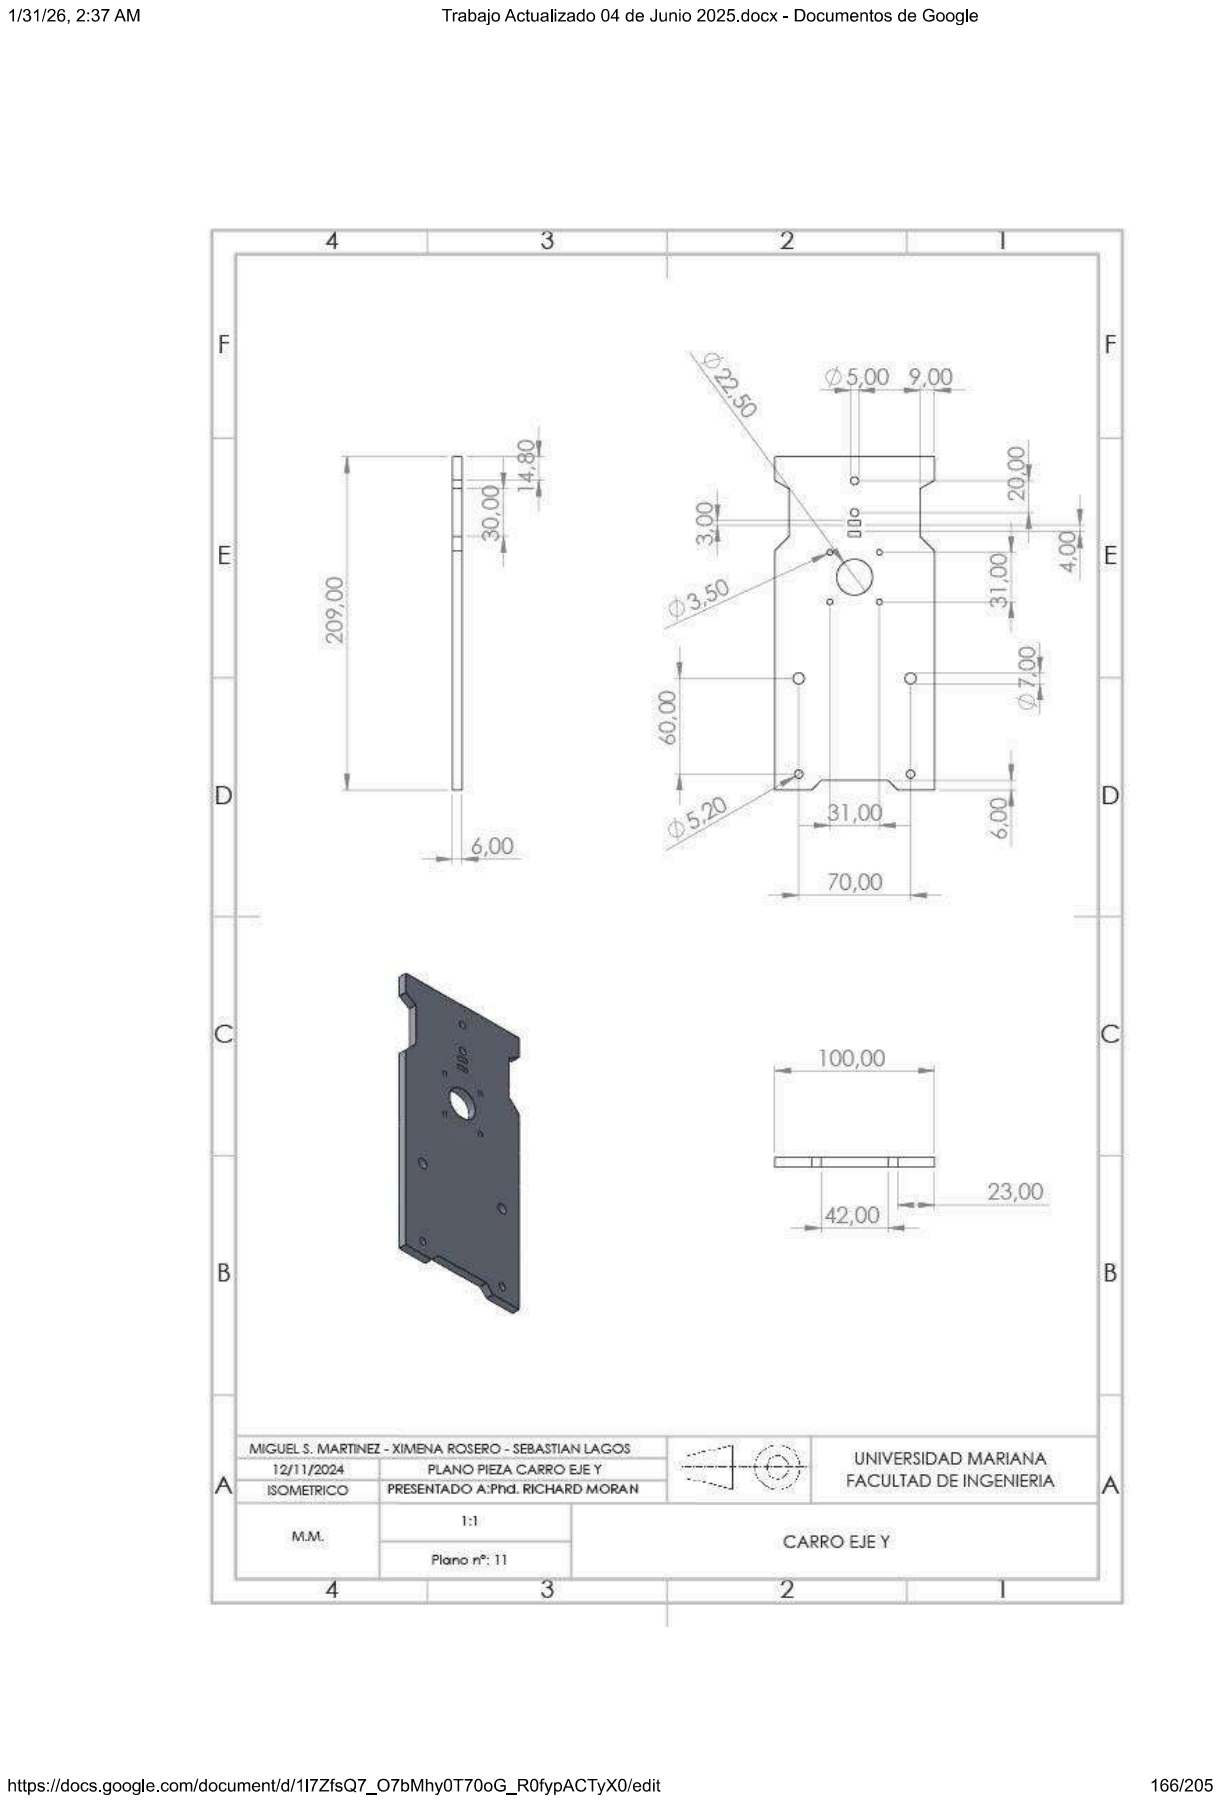
[picture p88: page 11]

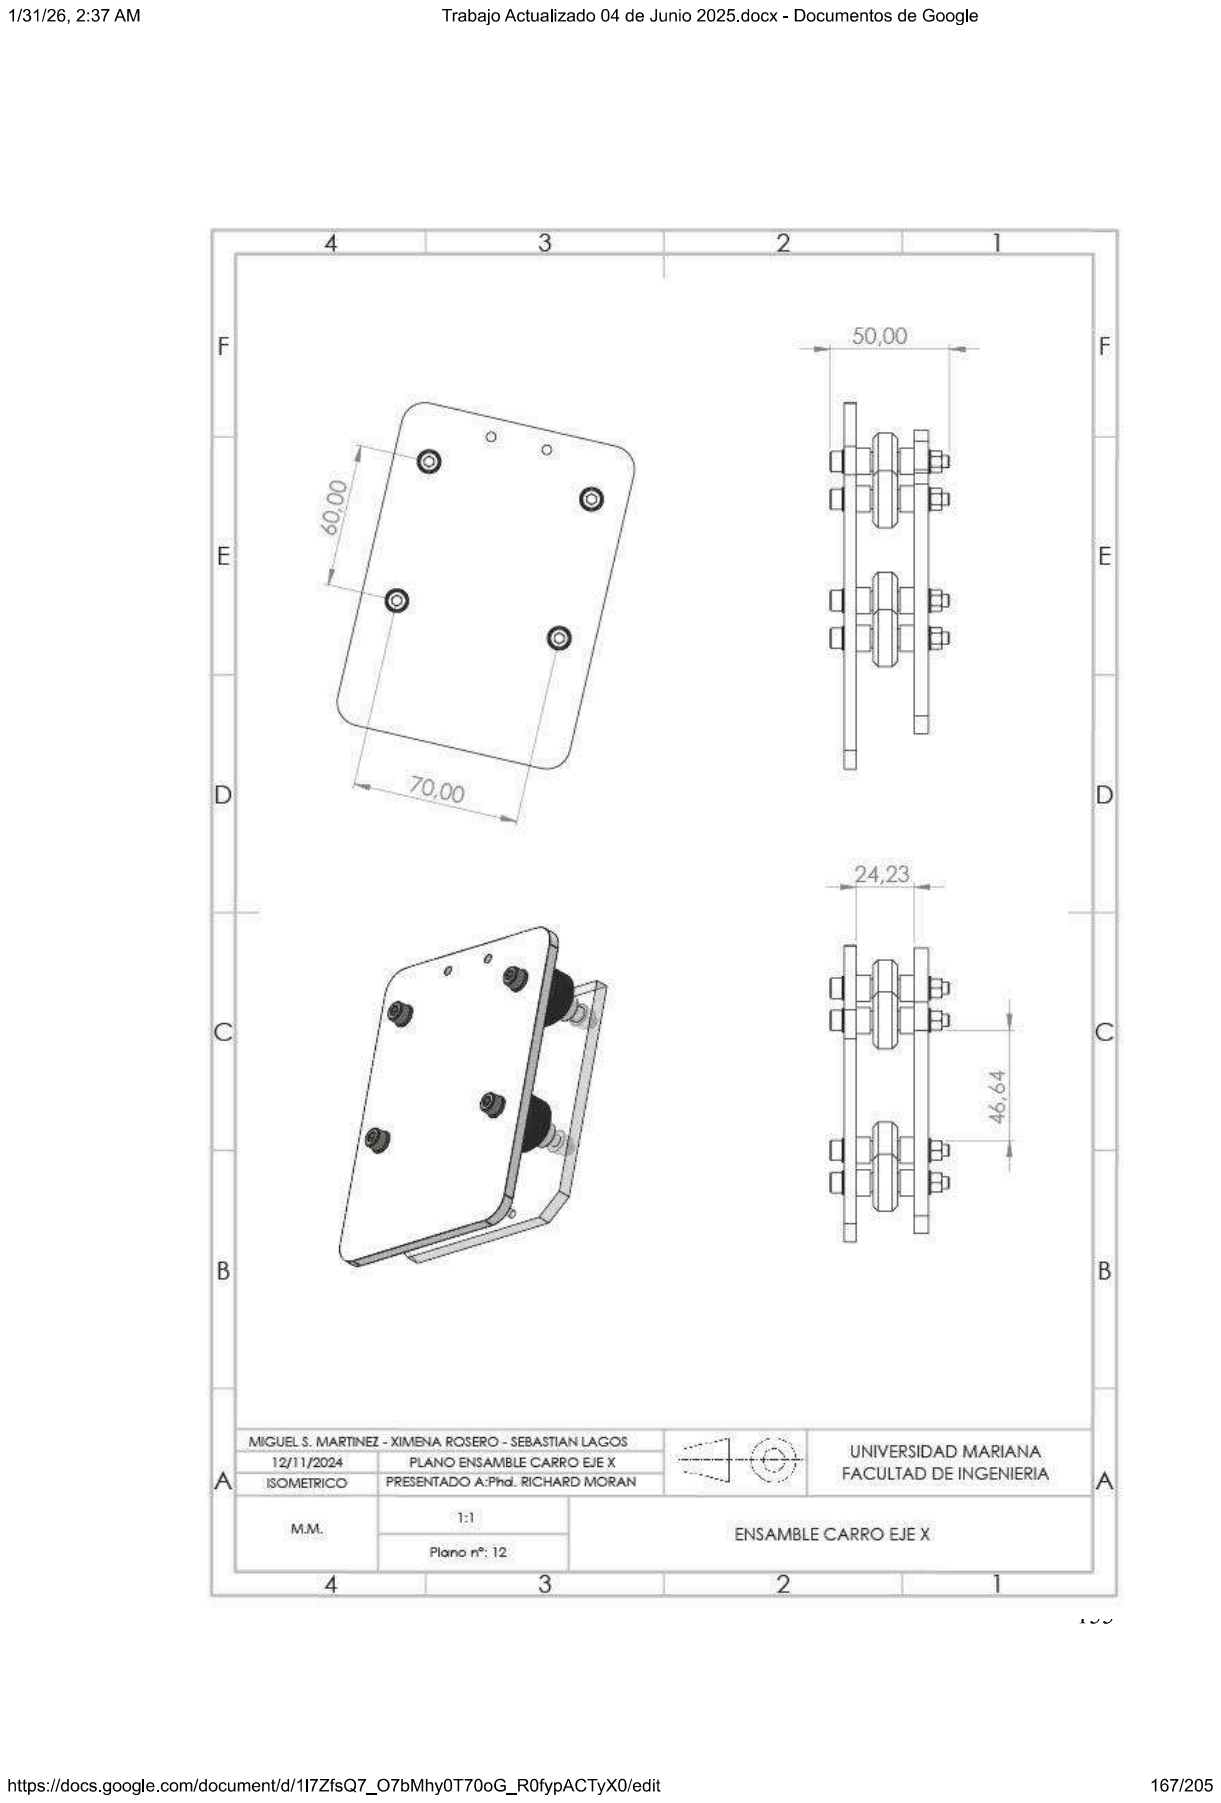
[picture p89: page 12]

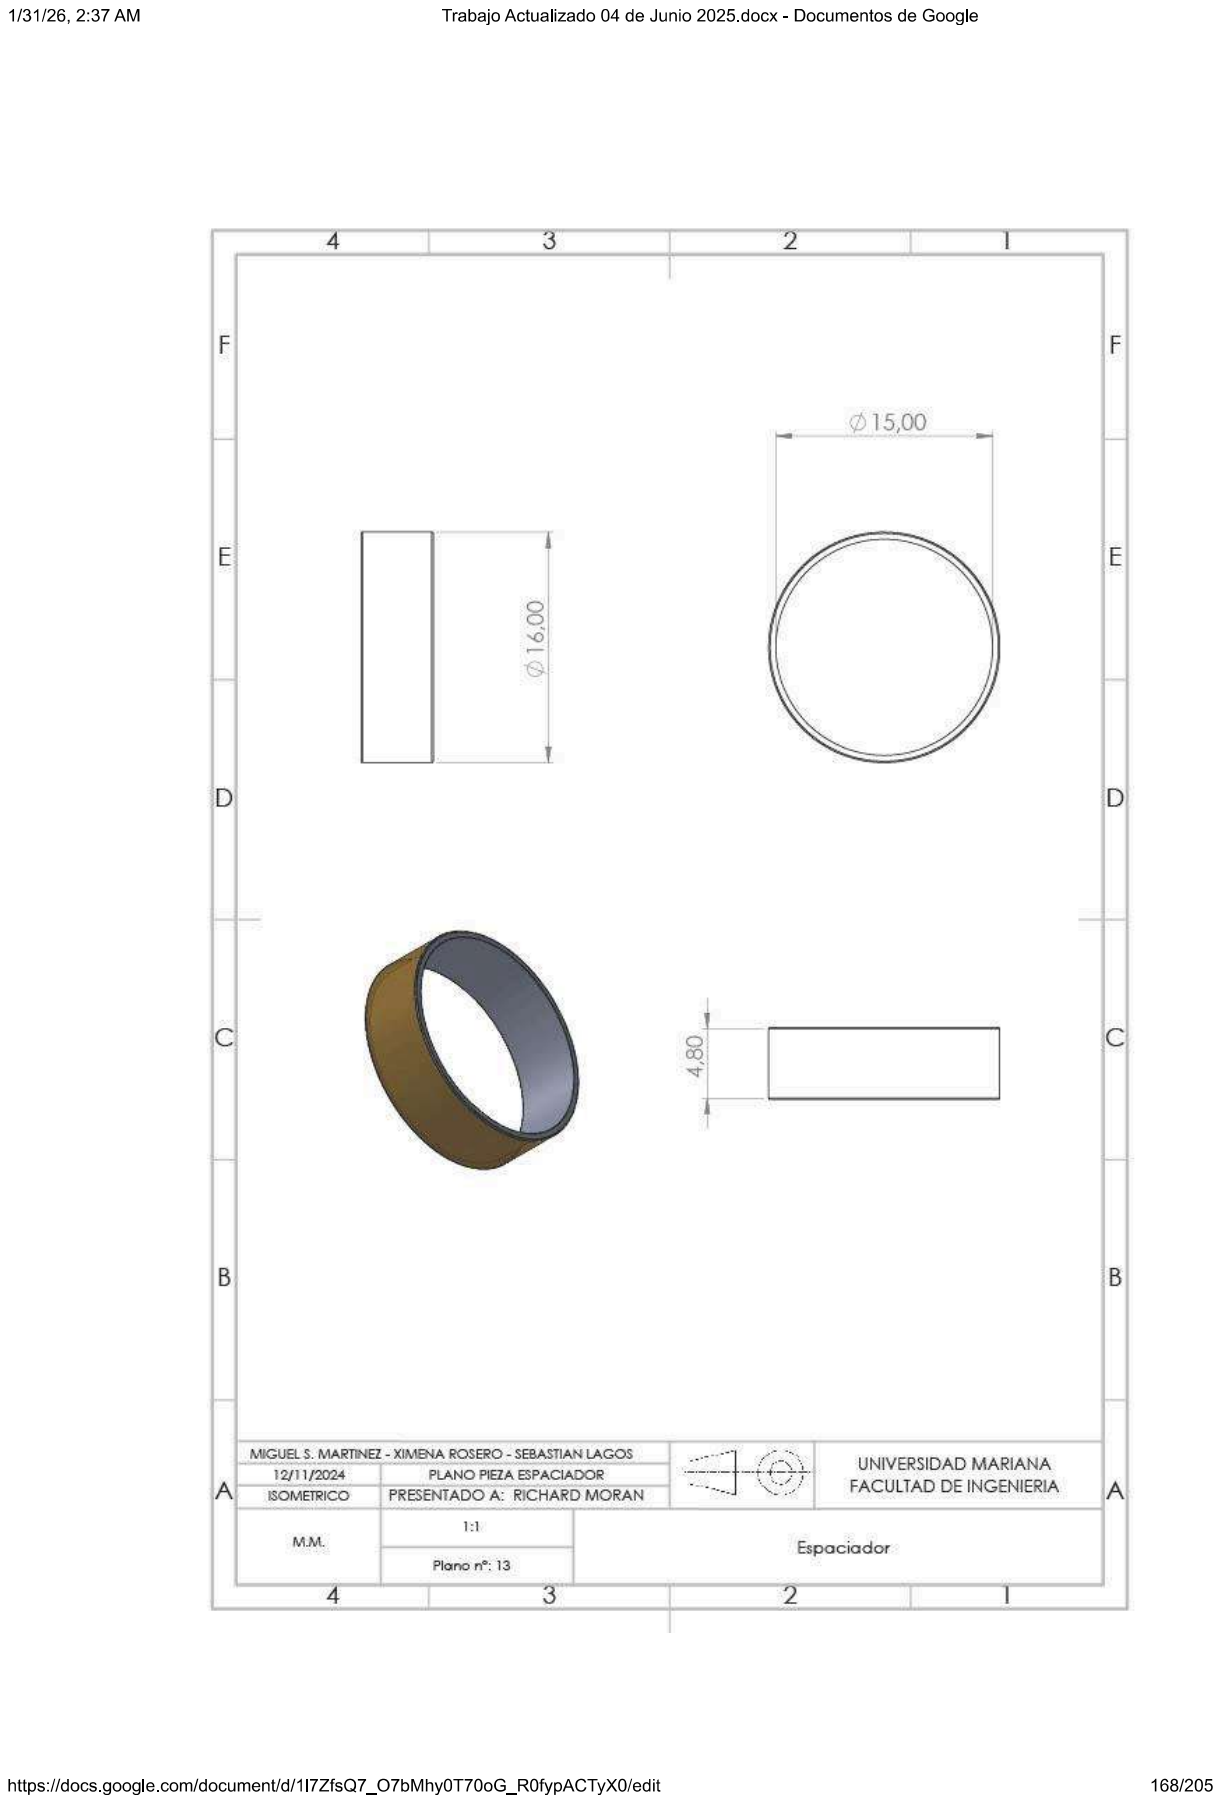
[picture p90: page 13]

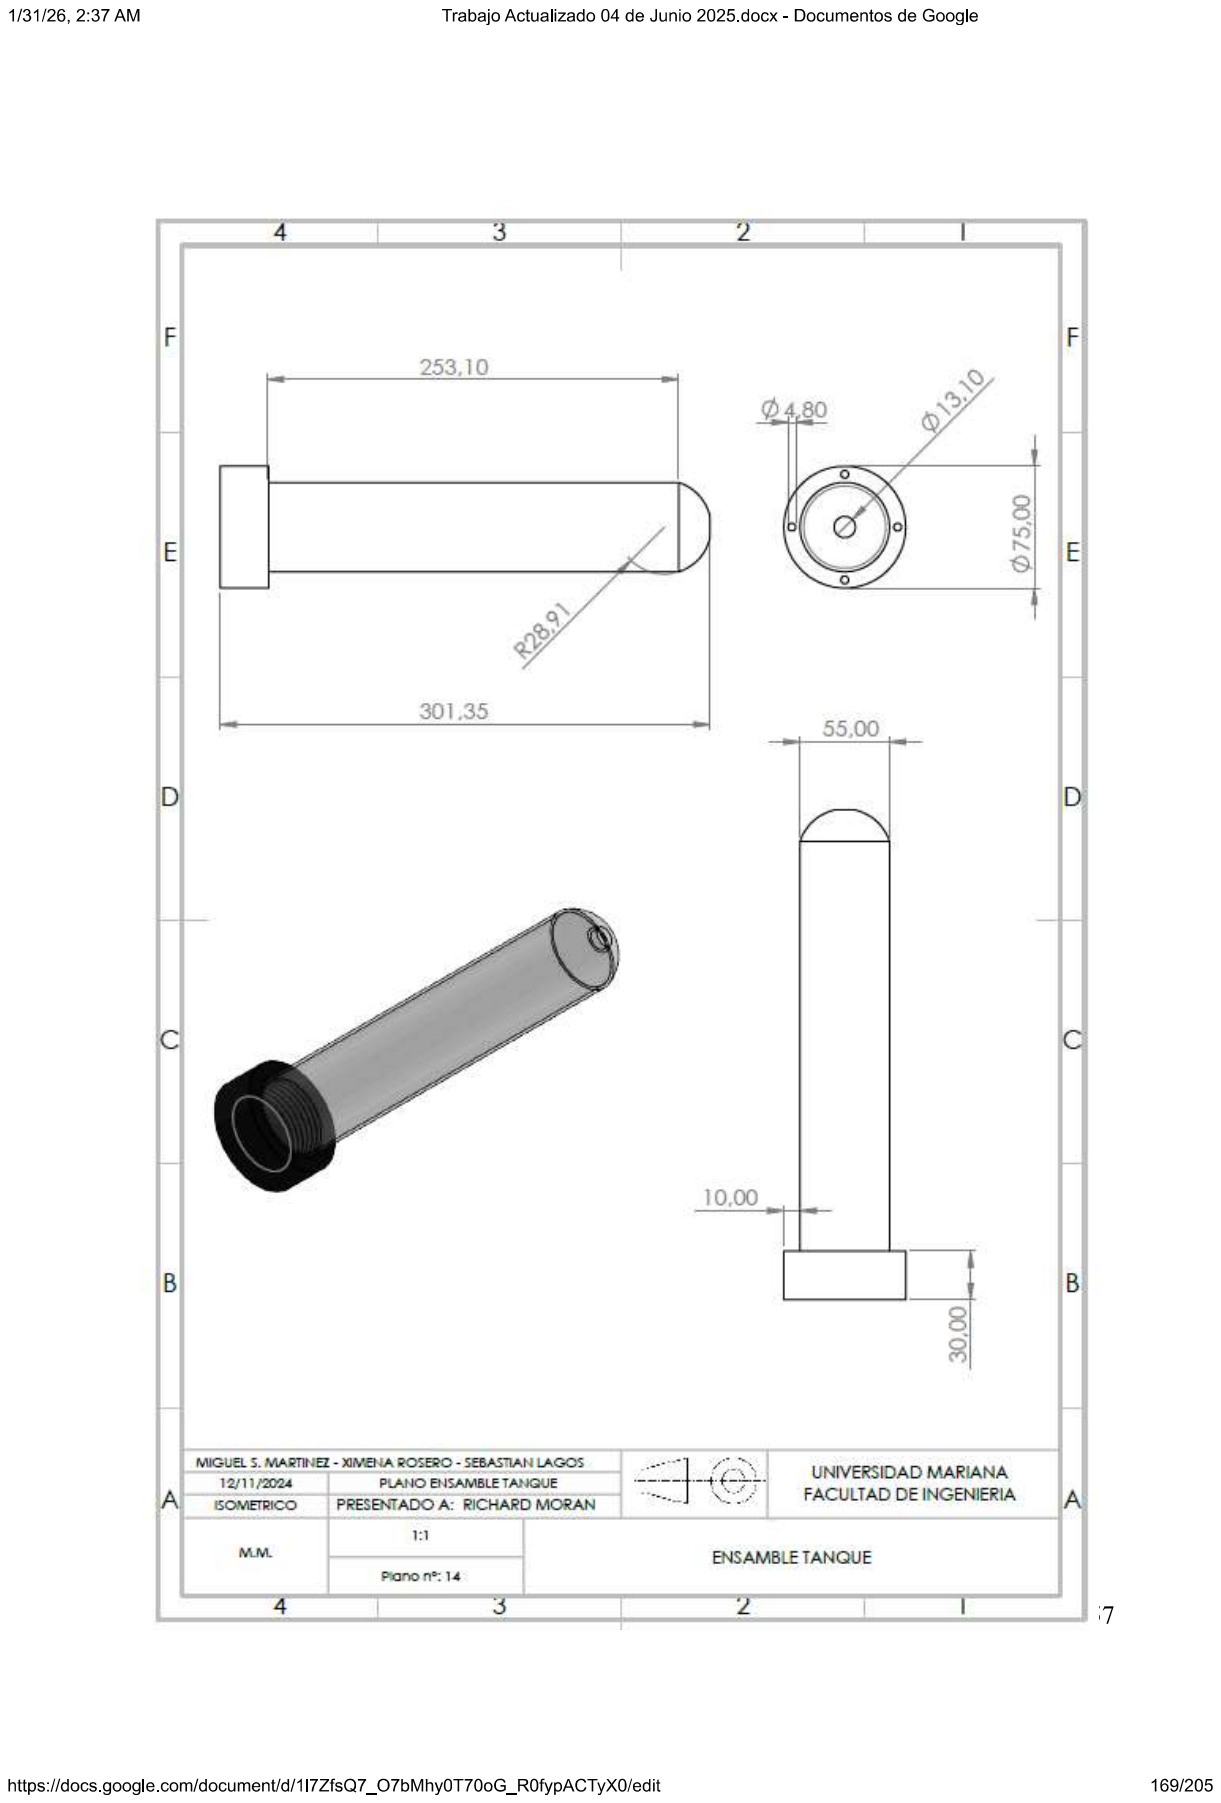
[picture p91: page 14]

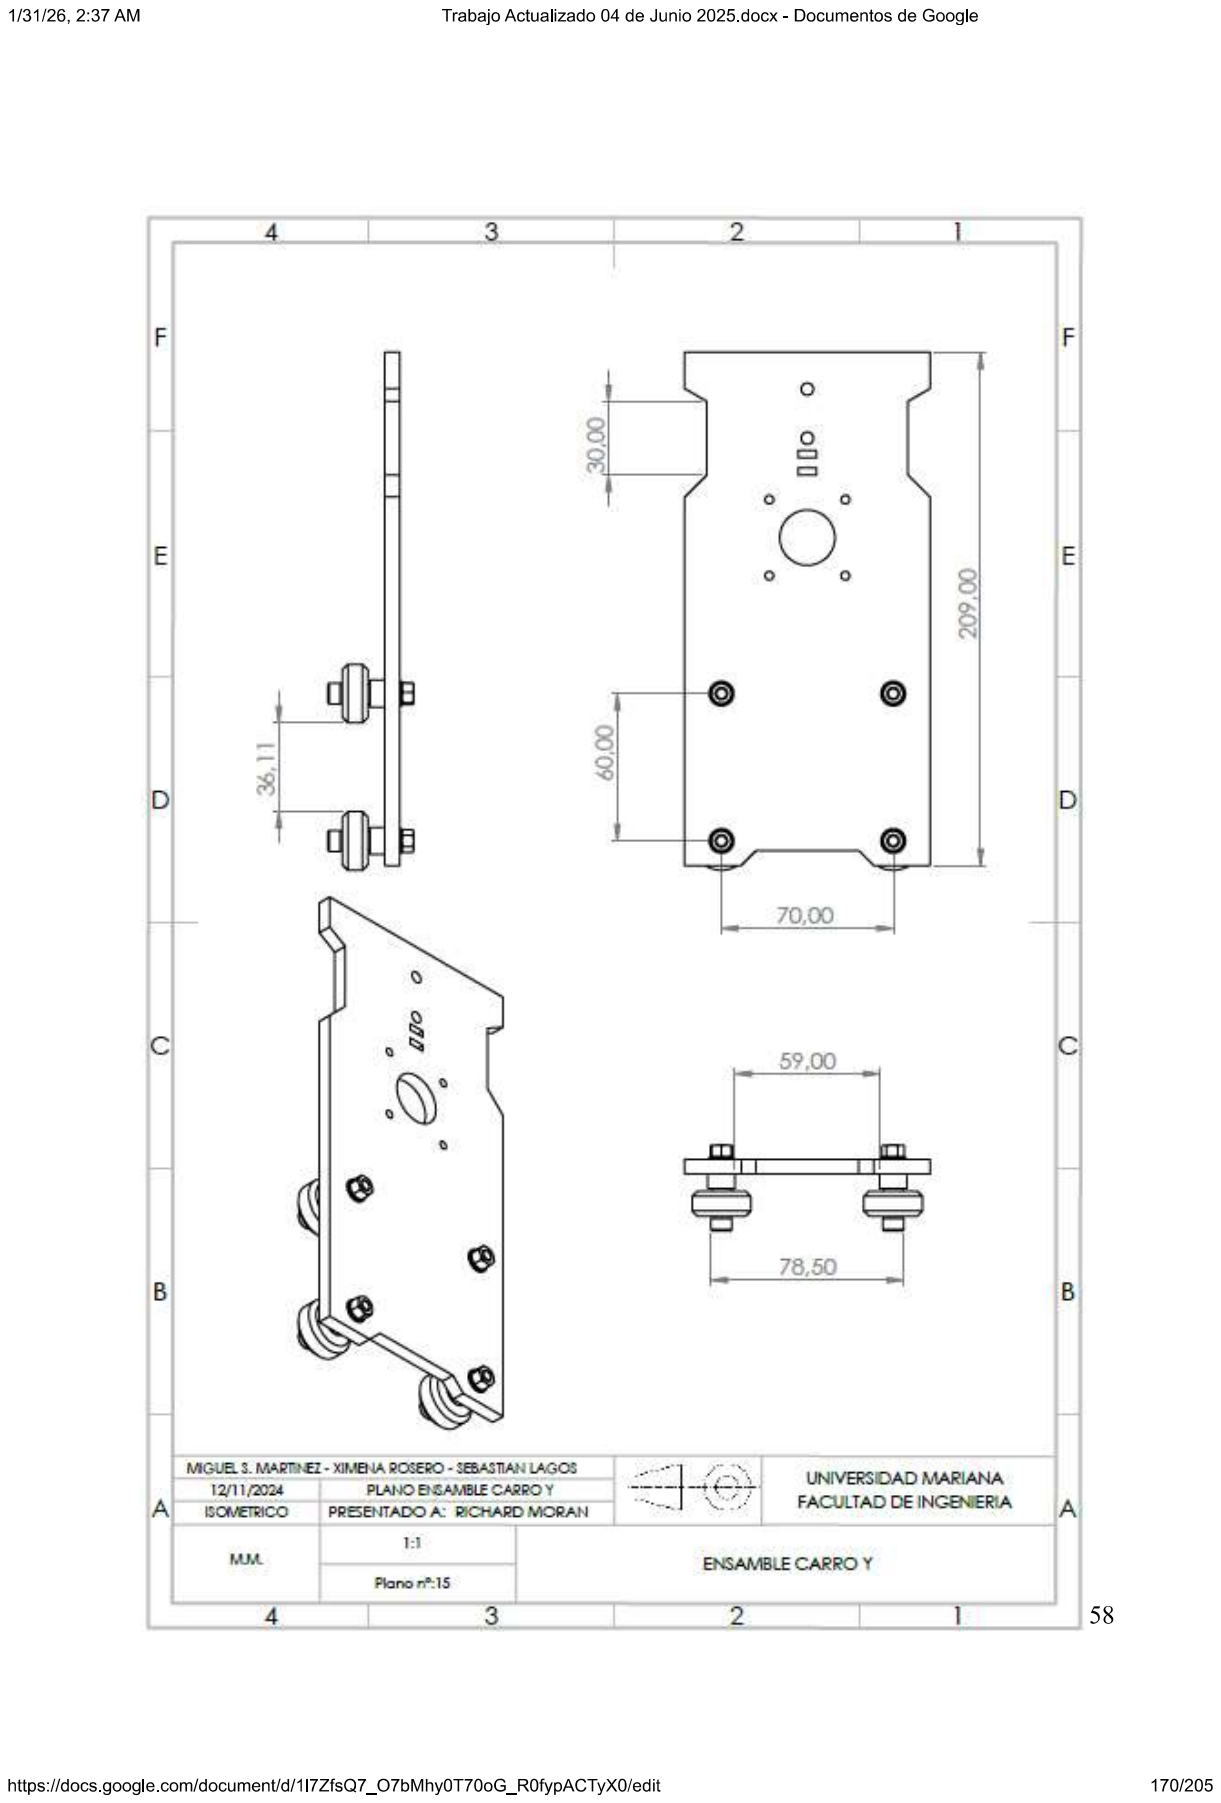
[picture p92: page 15]

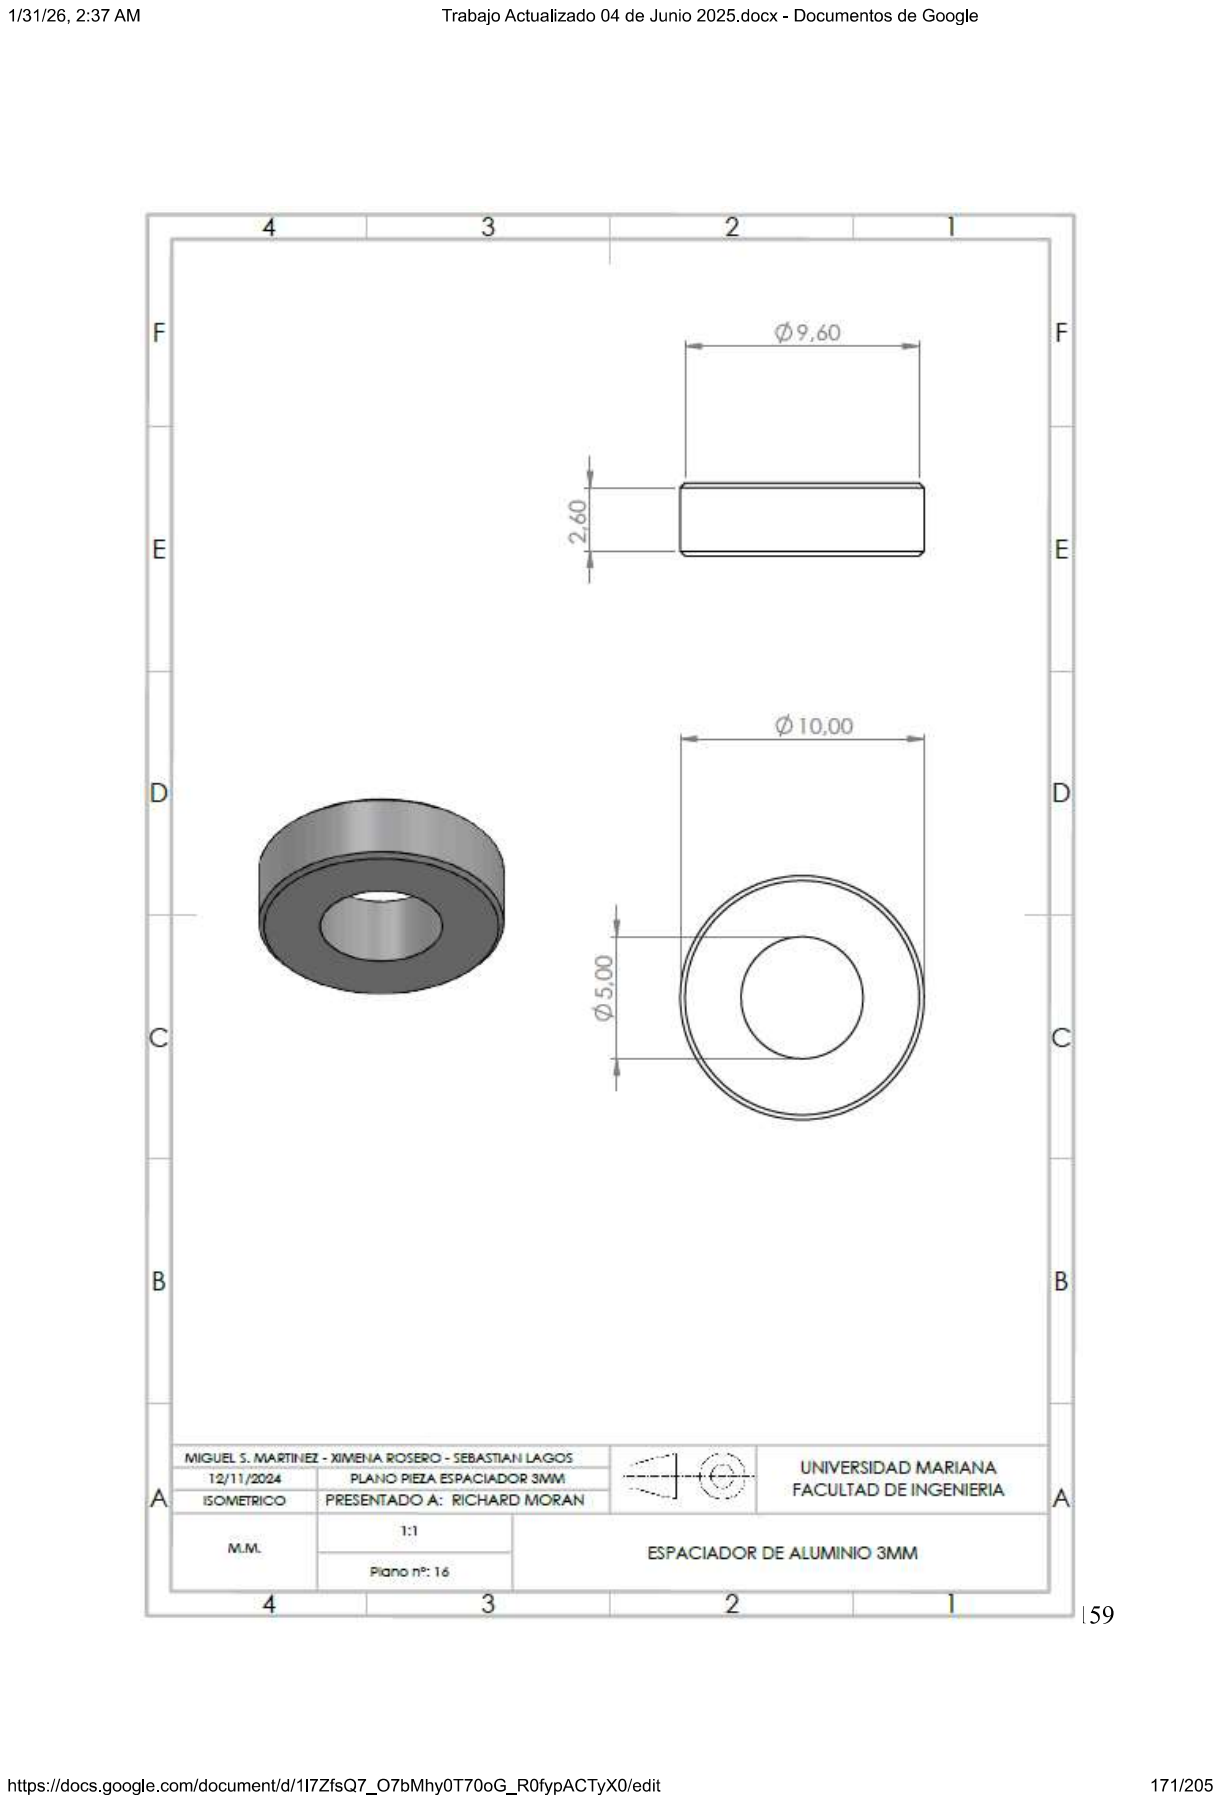
[picture p93: page 16]

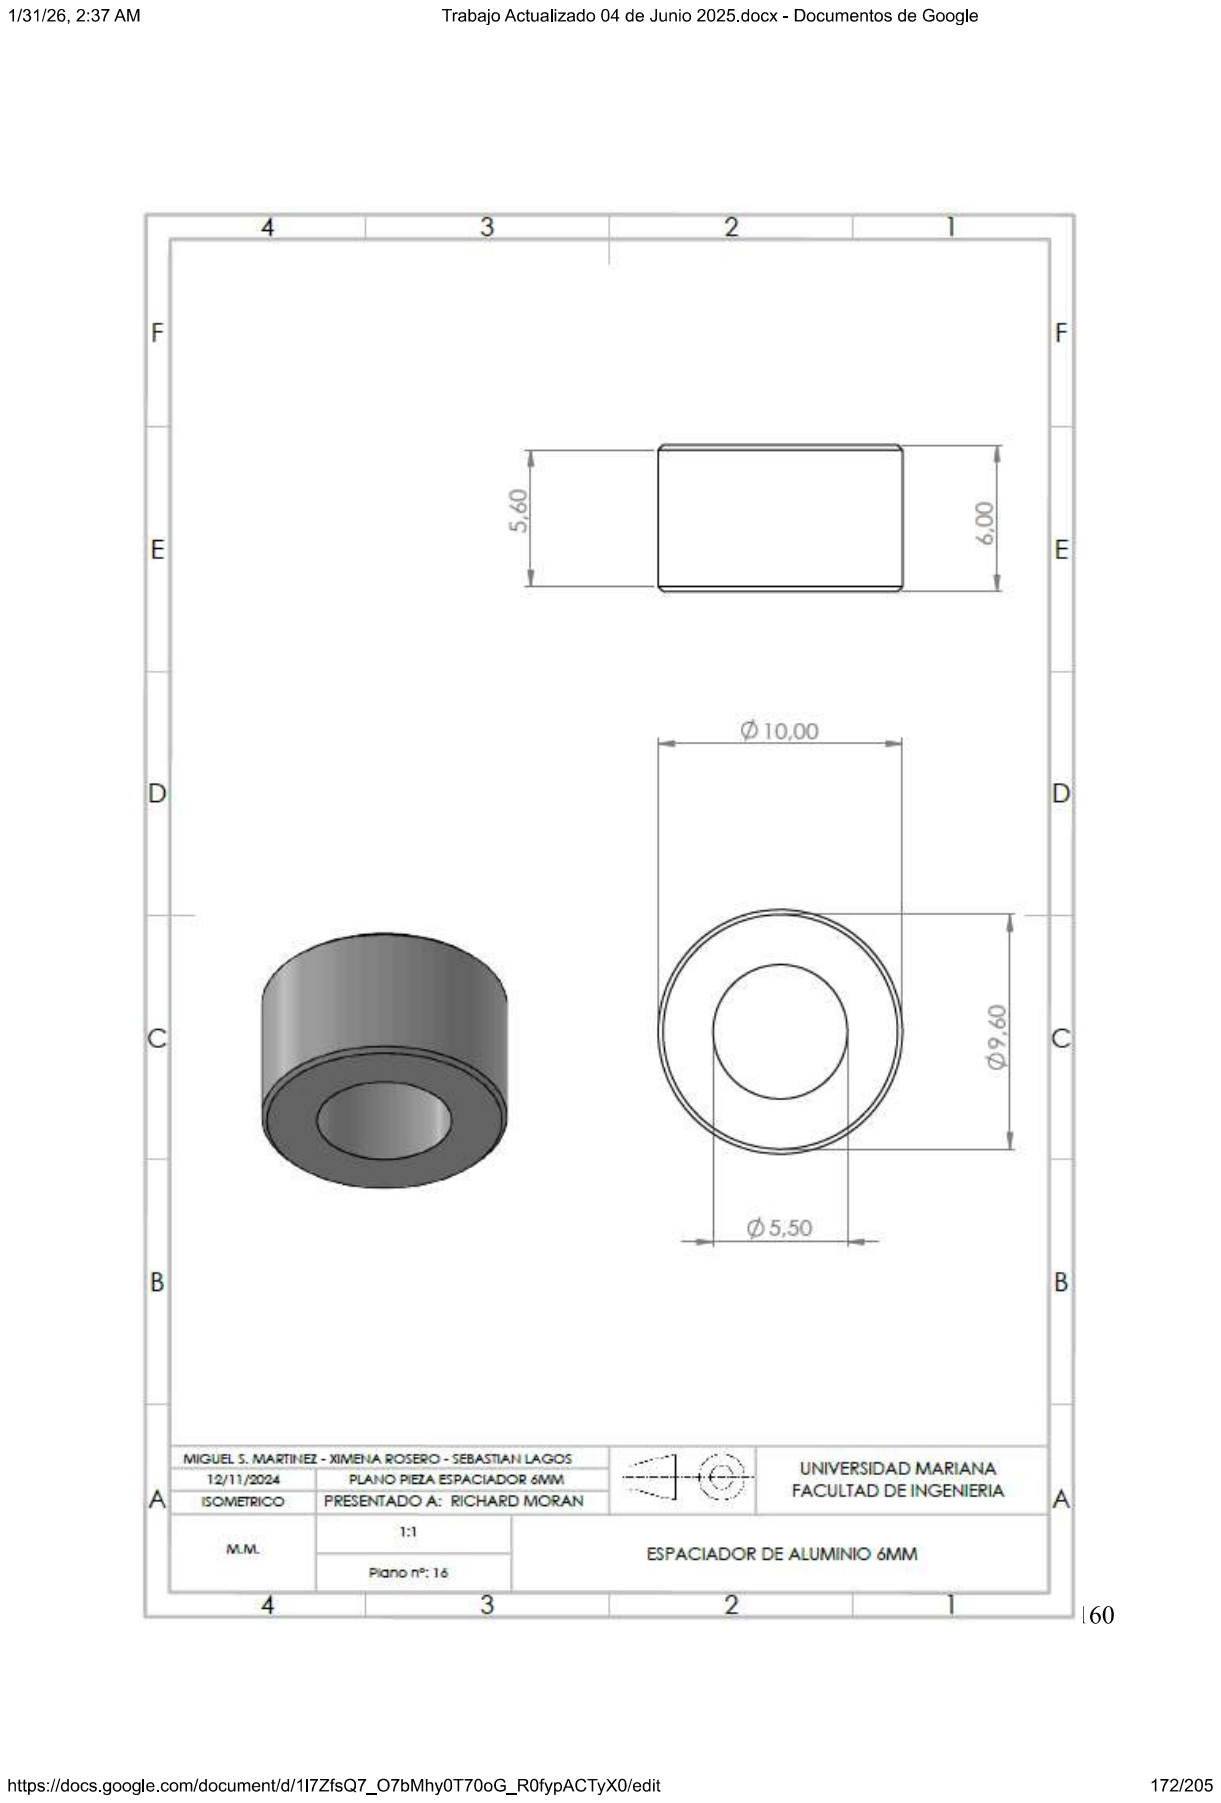
[picture p94: page 17]

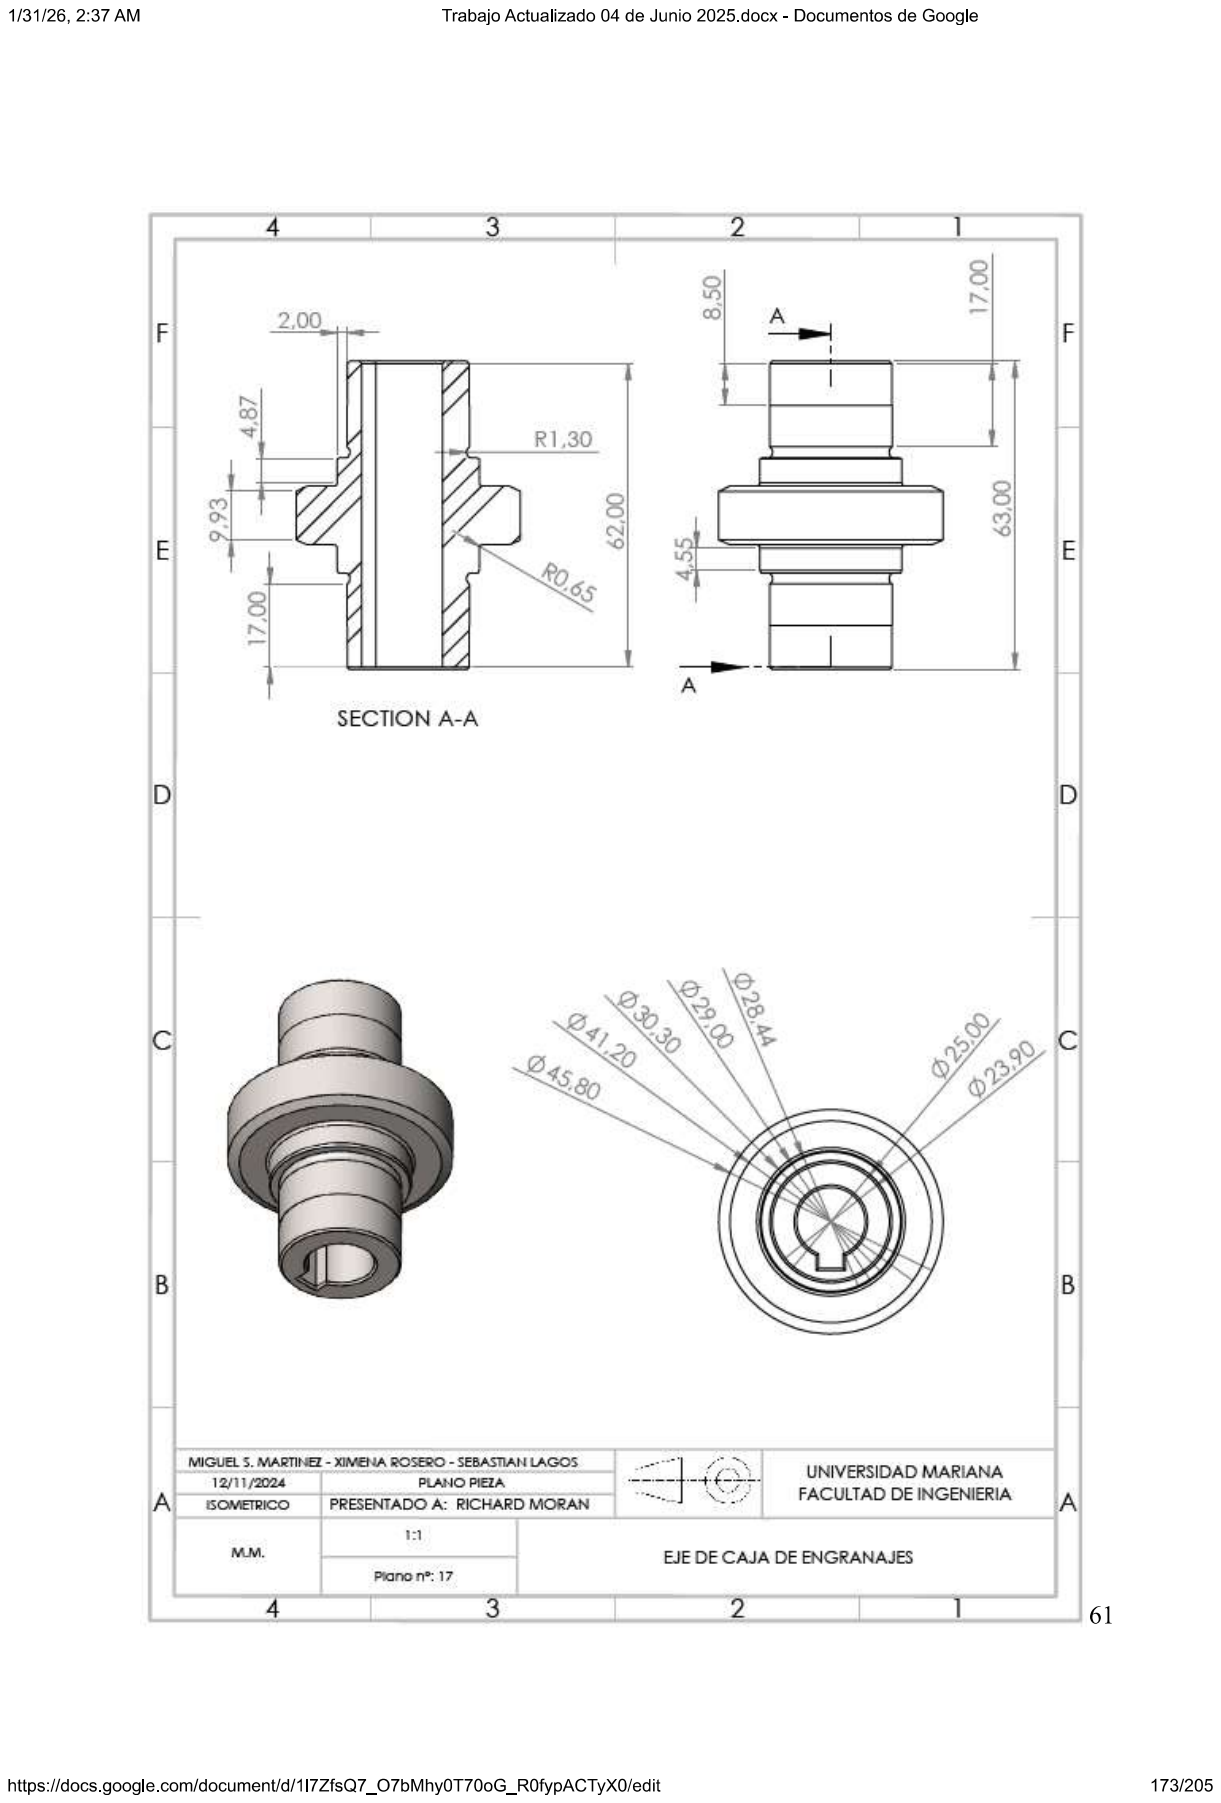
[picture p95: page 18]

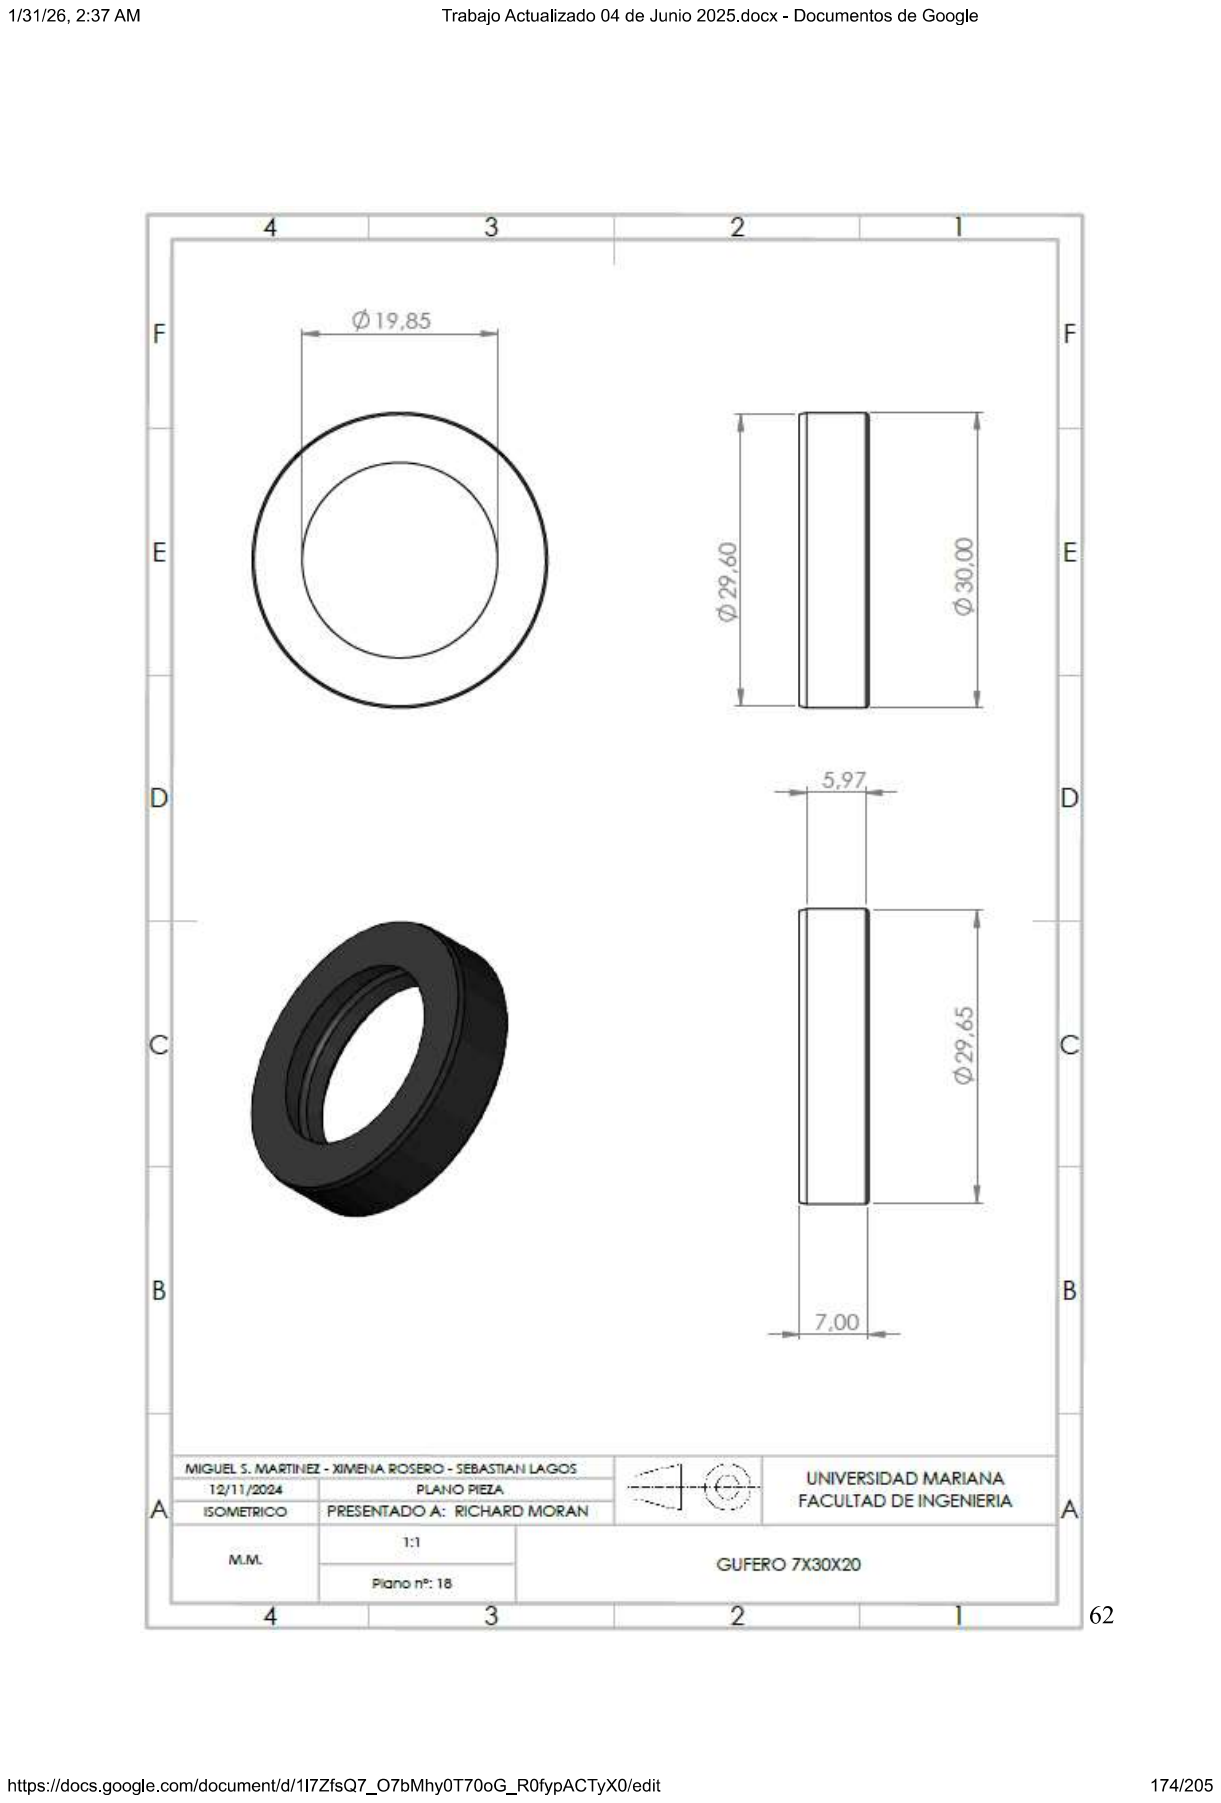
[picture p96: page 19]

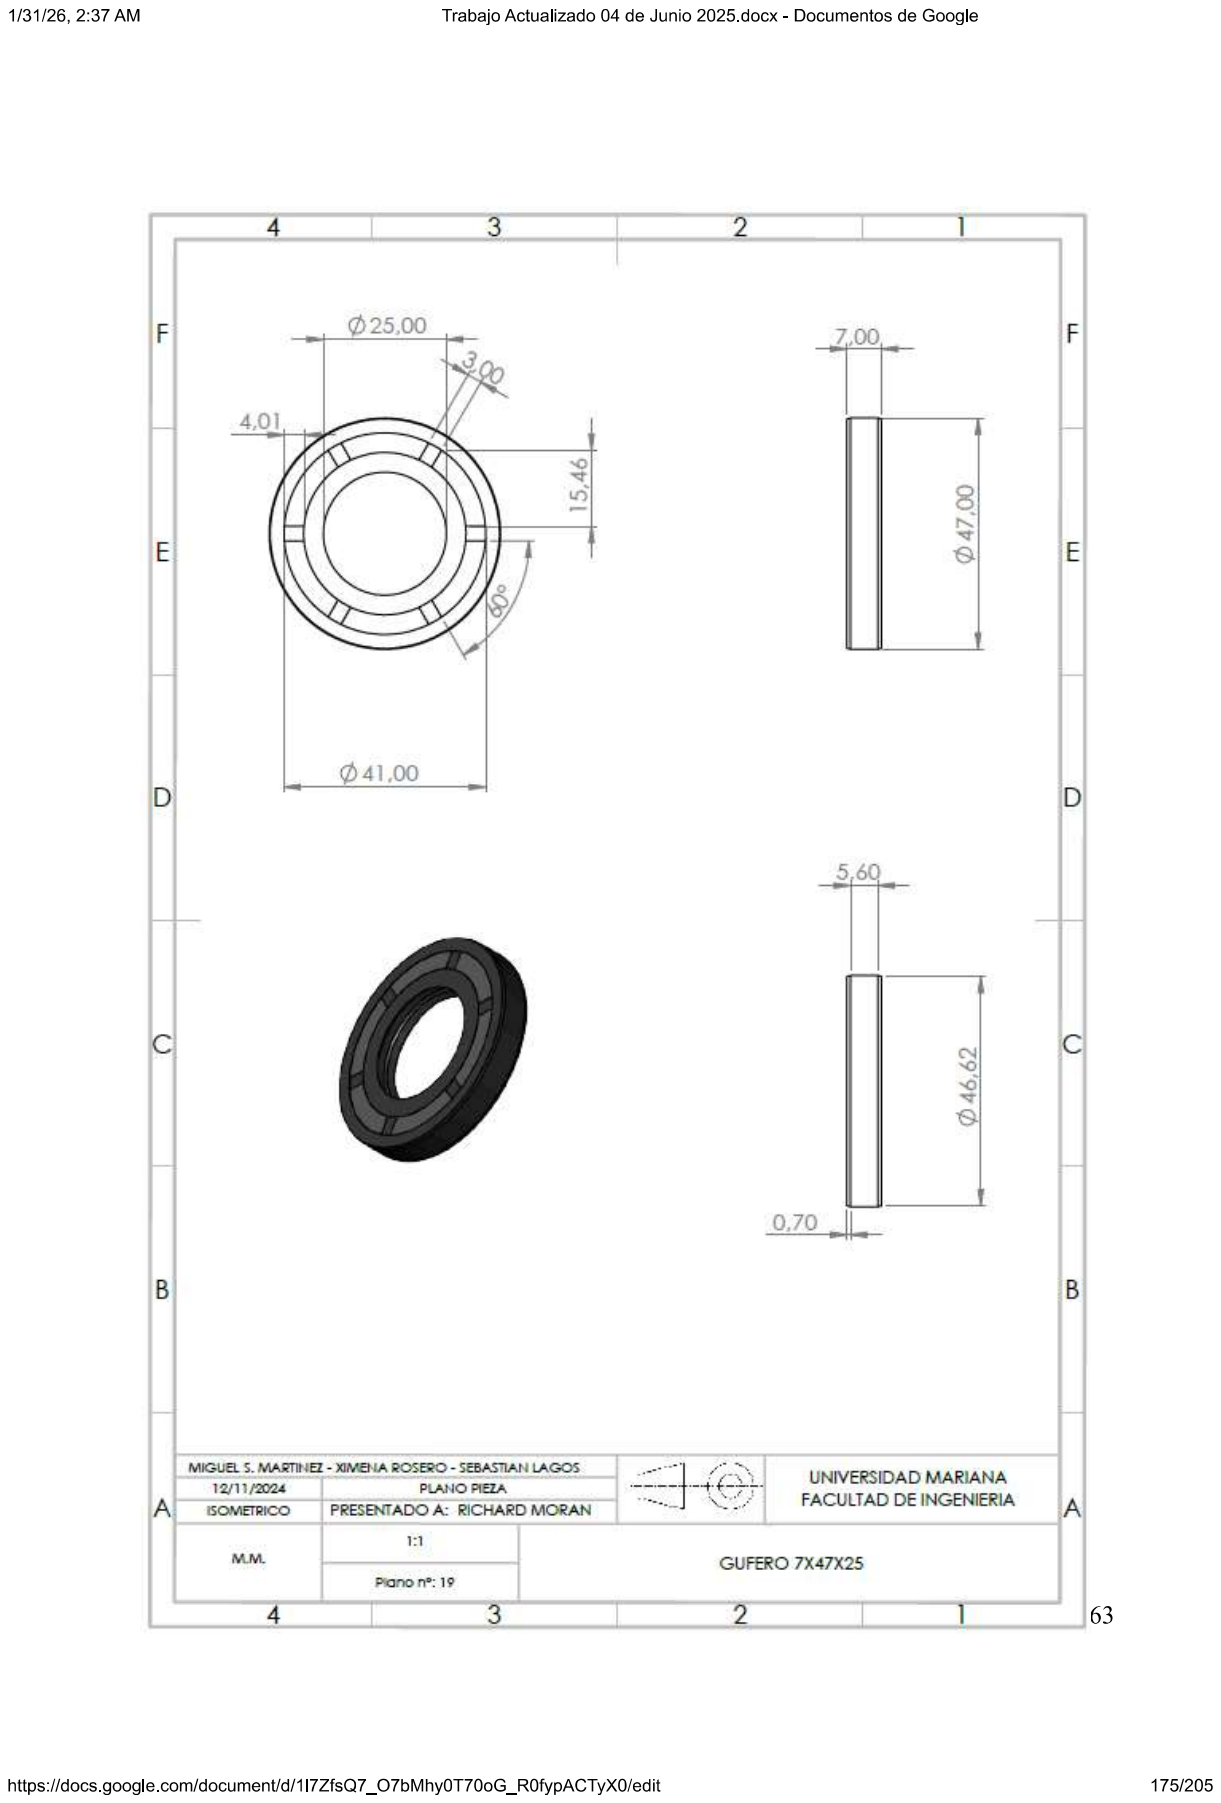
[picture p97: page 20]

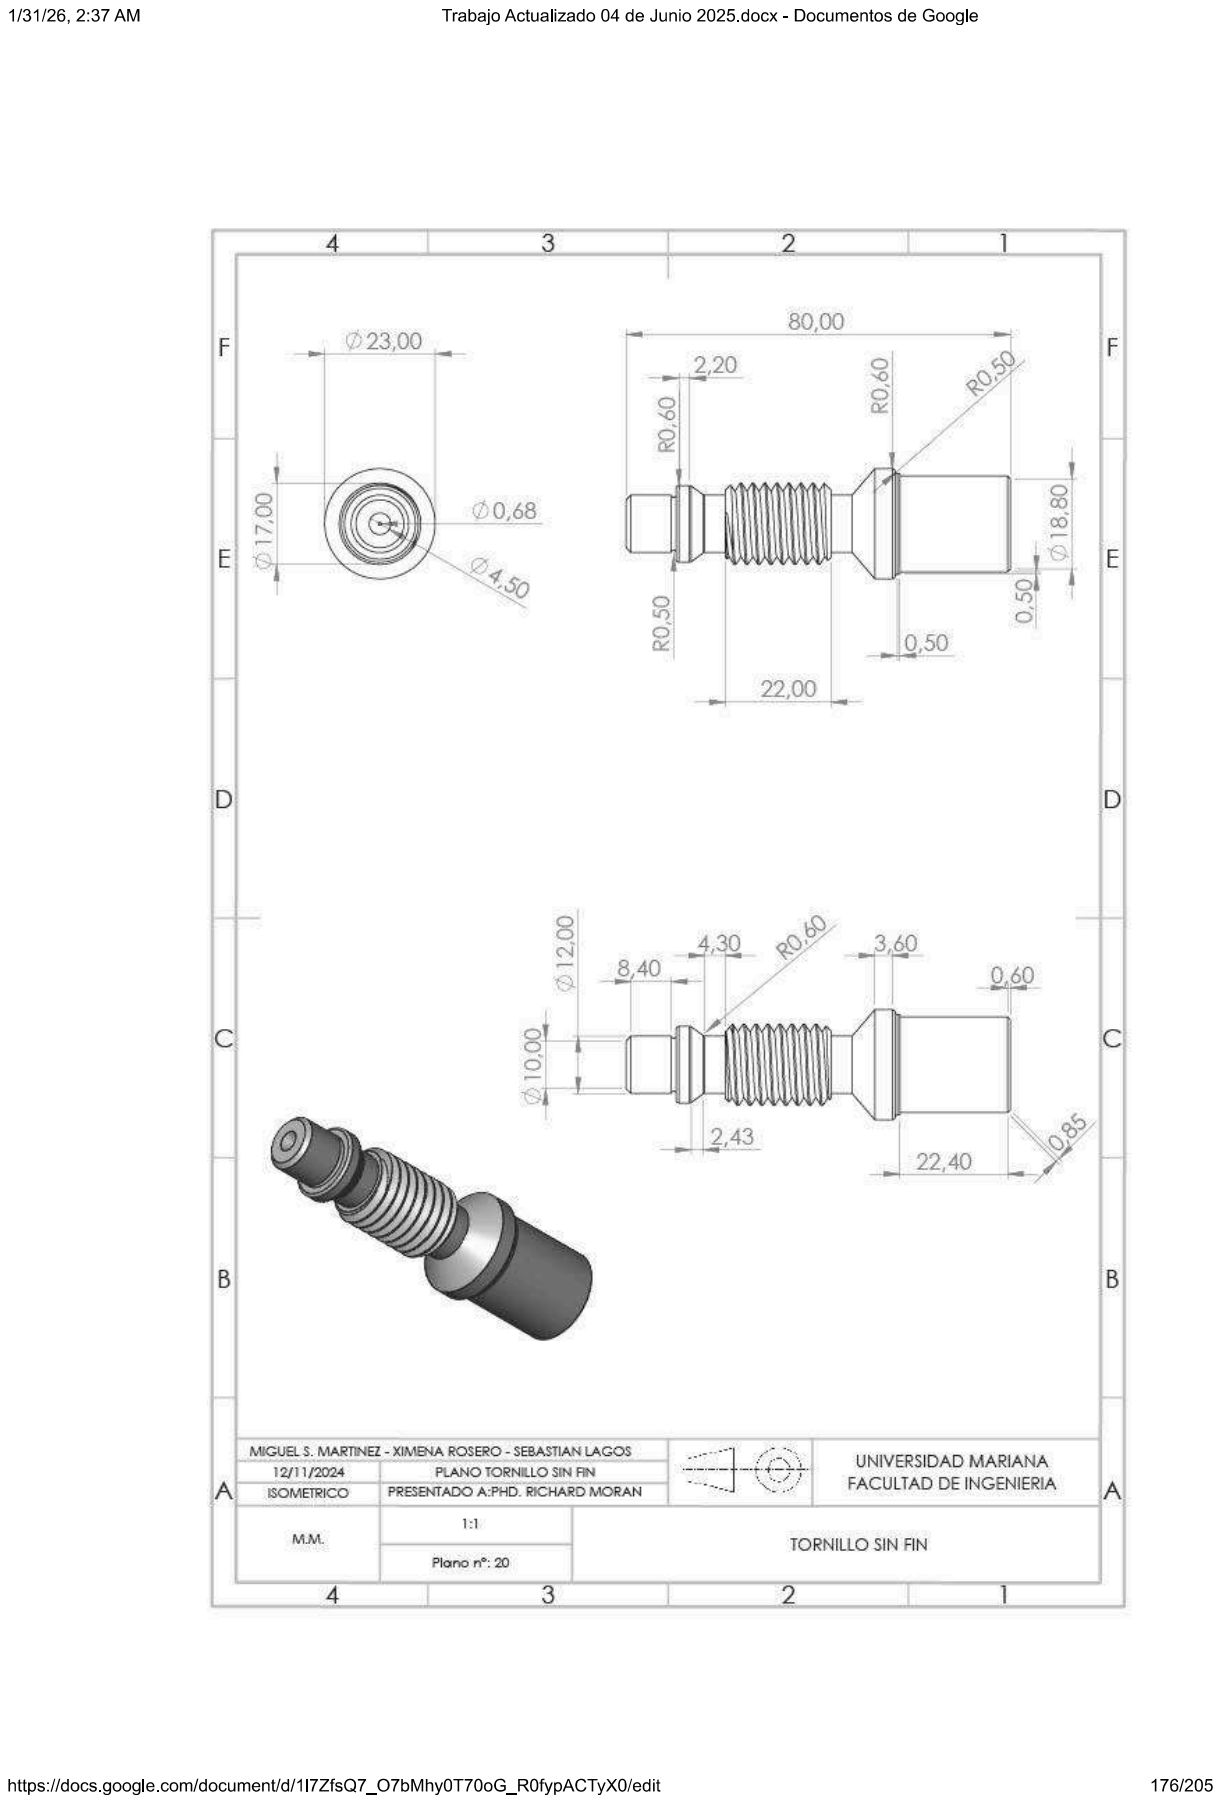
[picture p98: page 21]

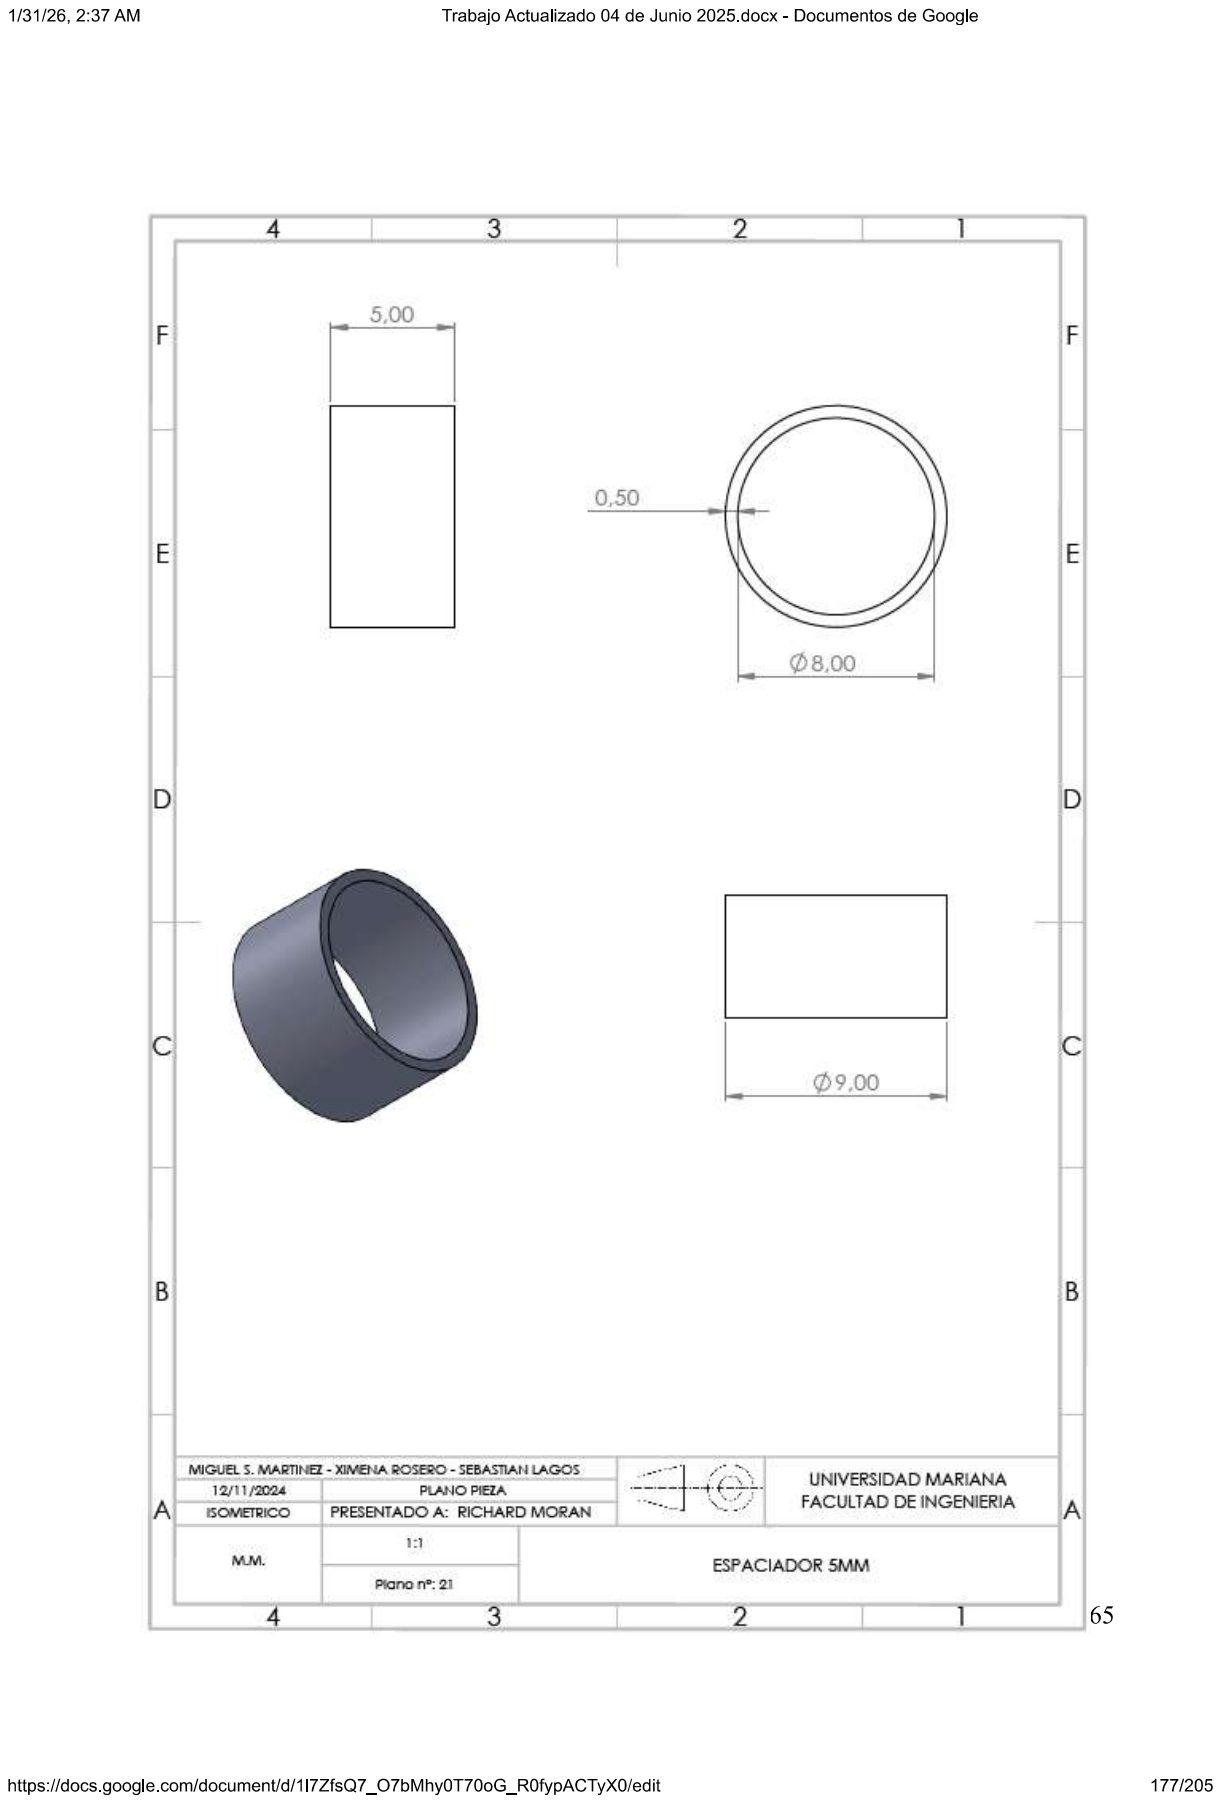
[picture p99: page 22]

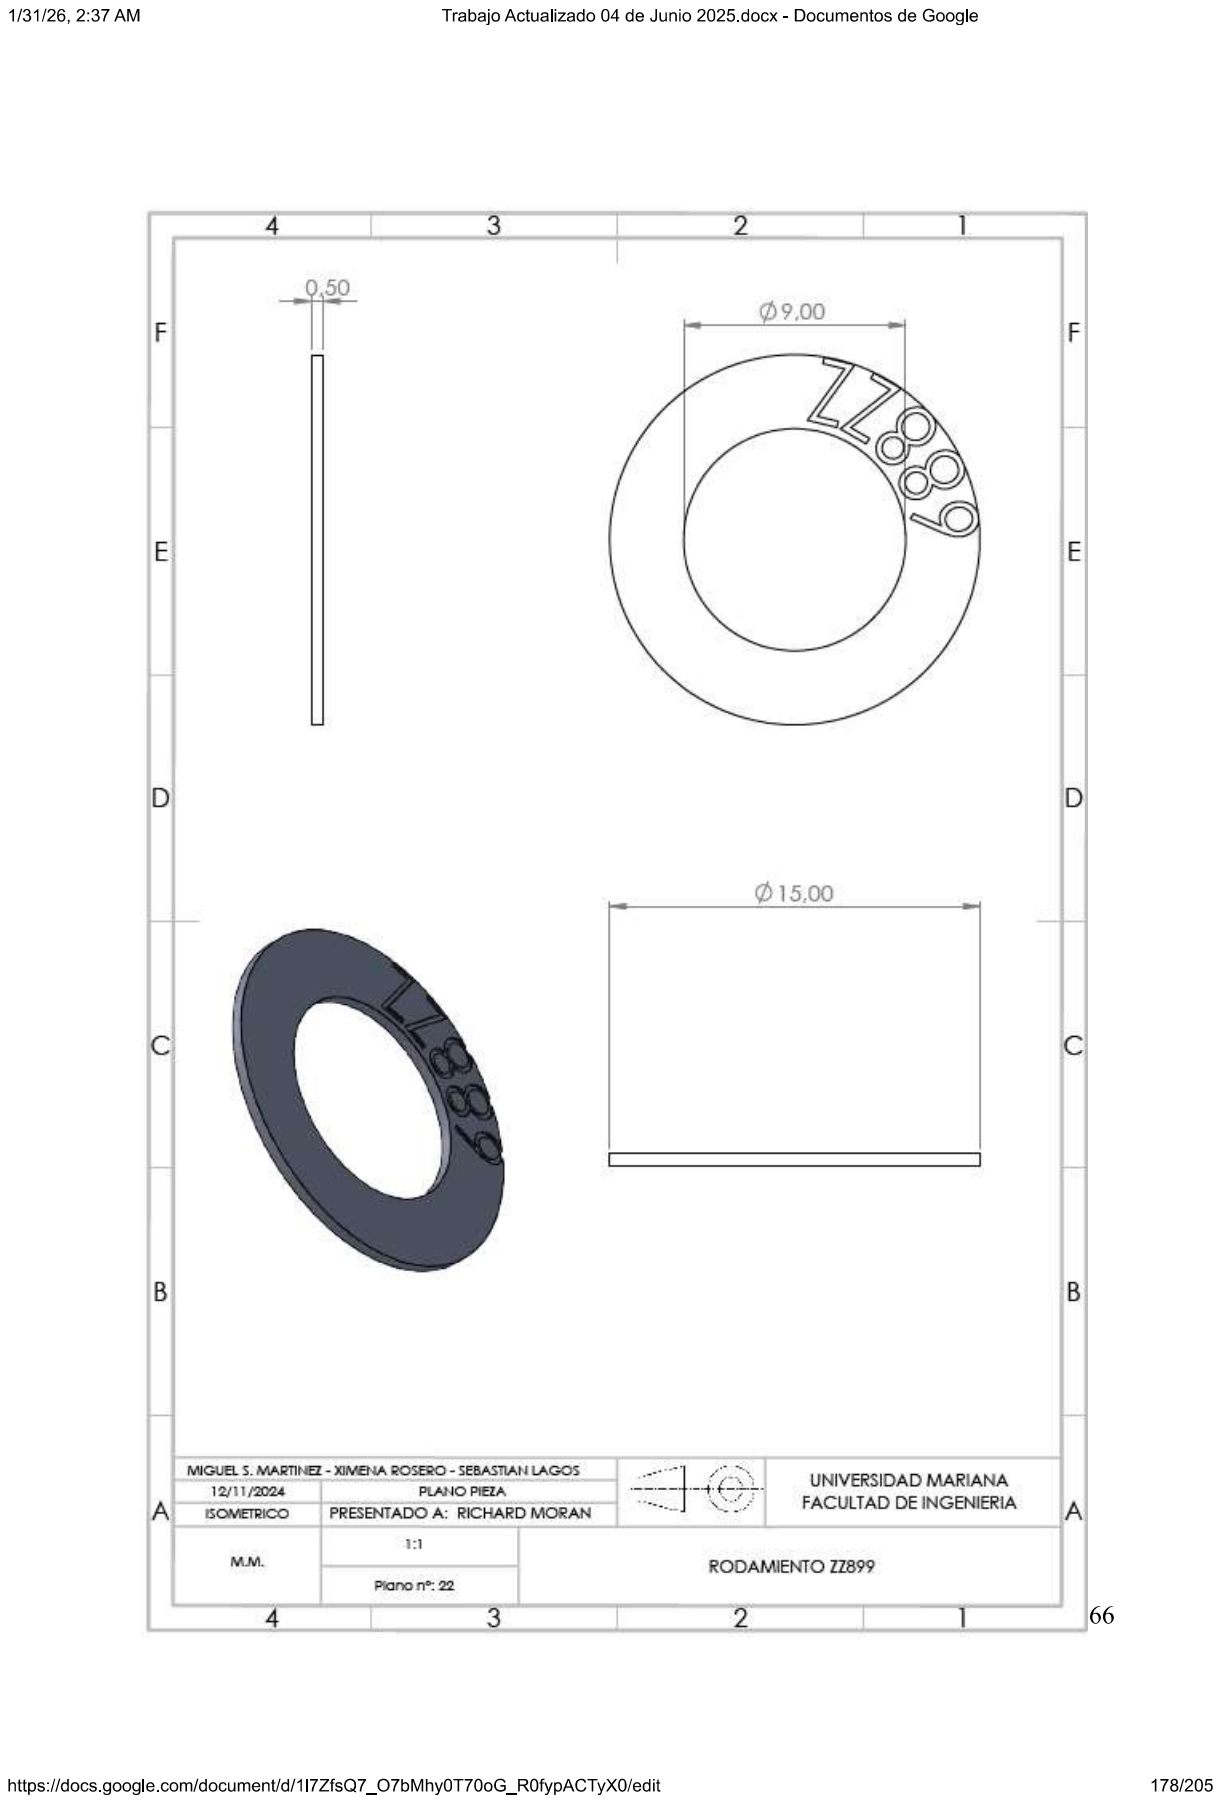
[picture p100: page 23]

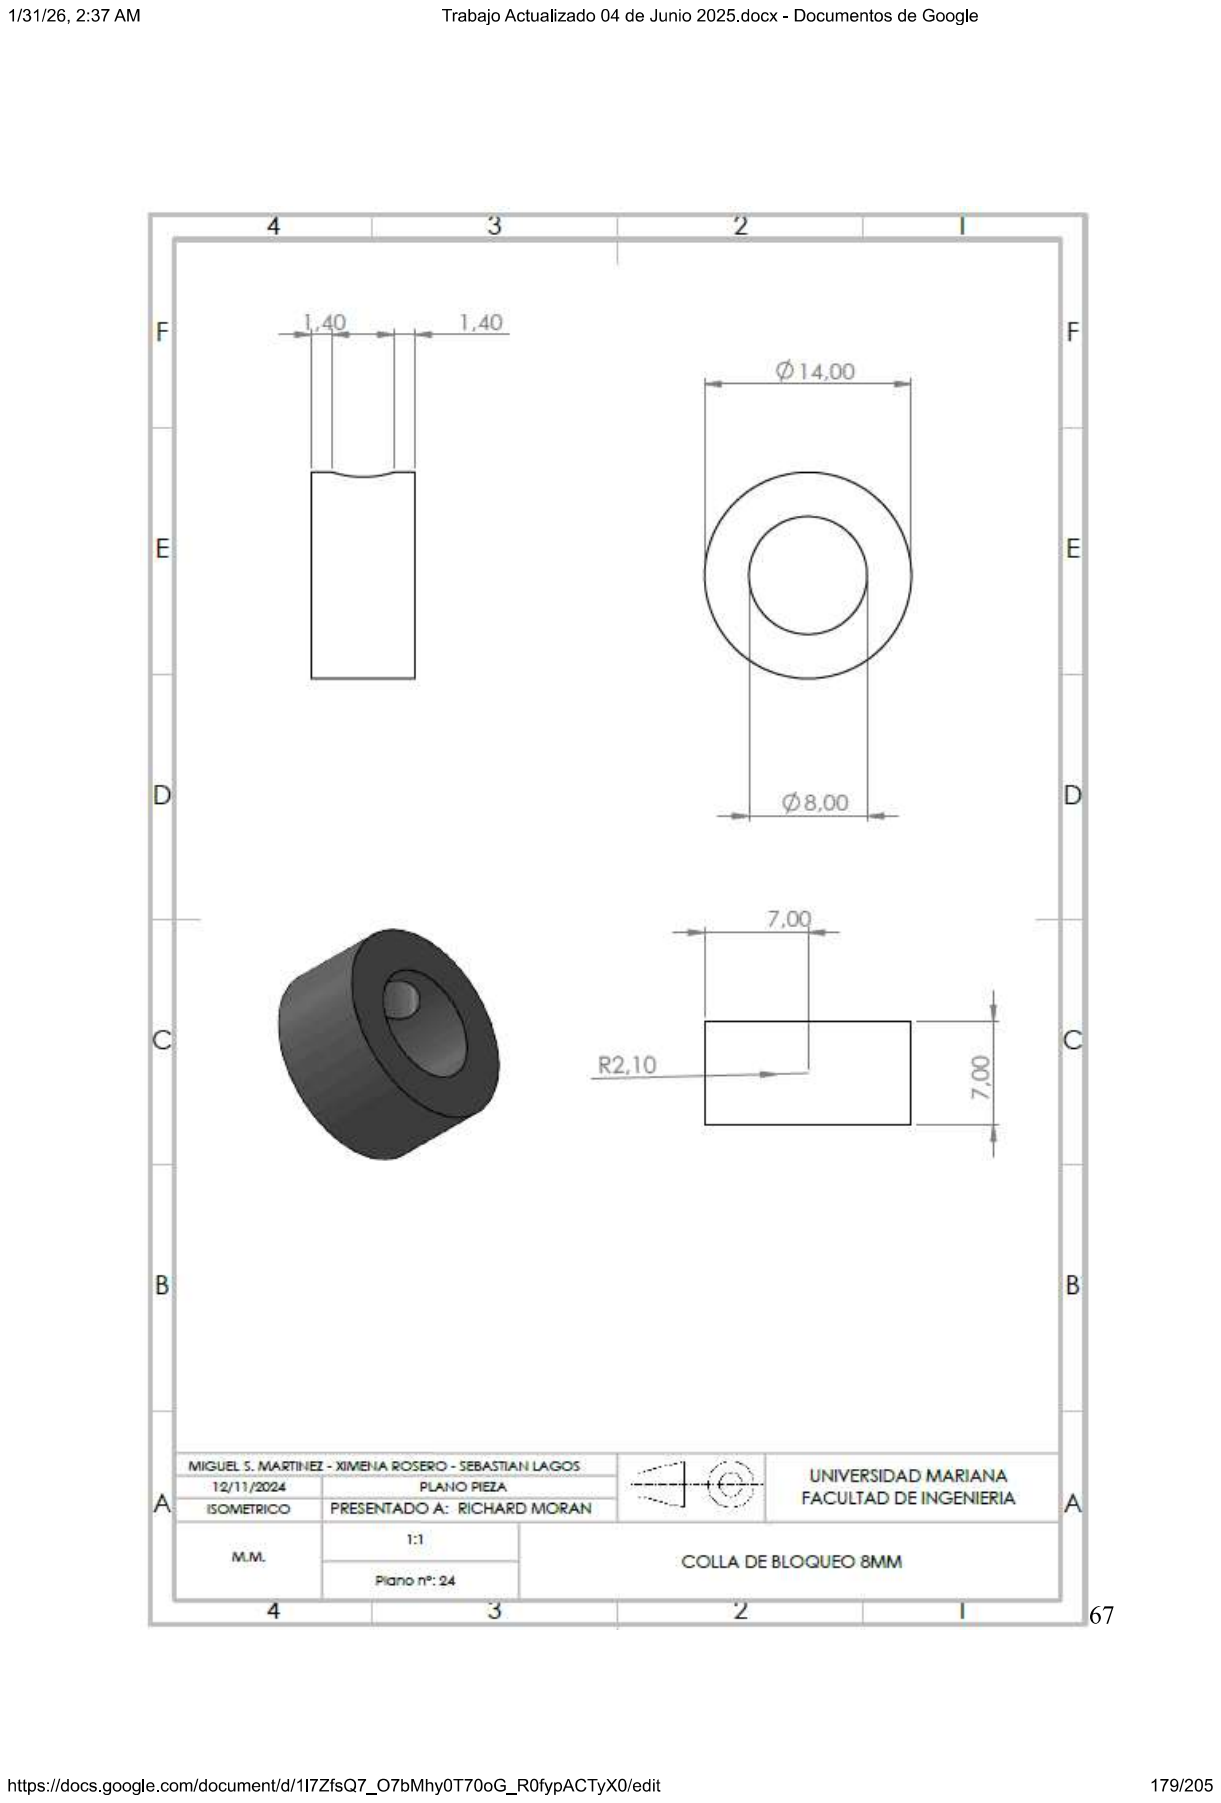
[picture p101: page 24]

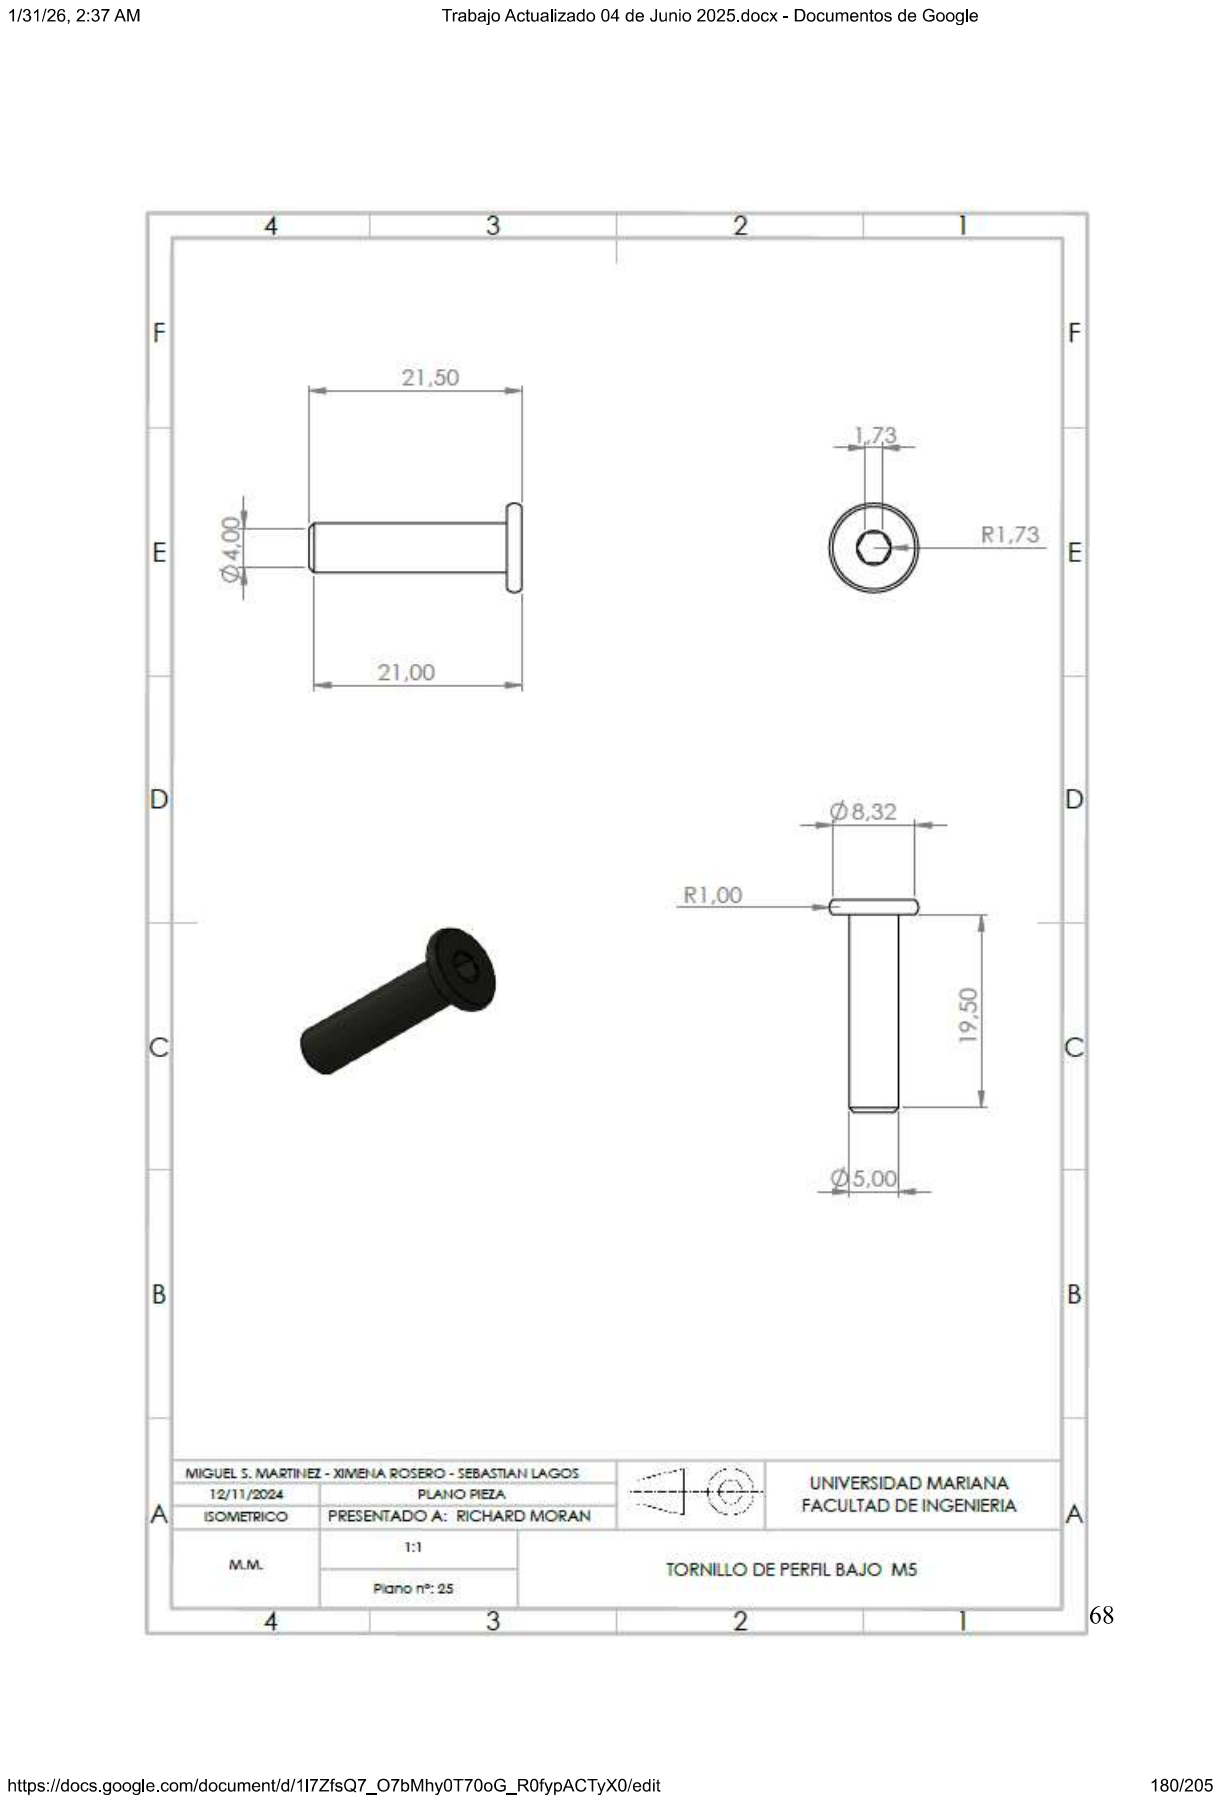
[picture p102: page 25]

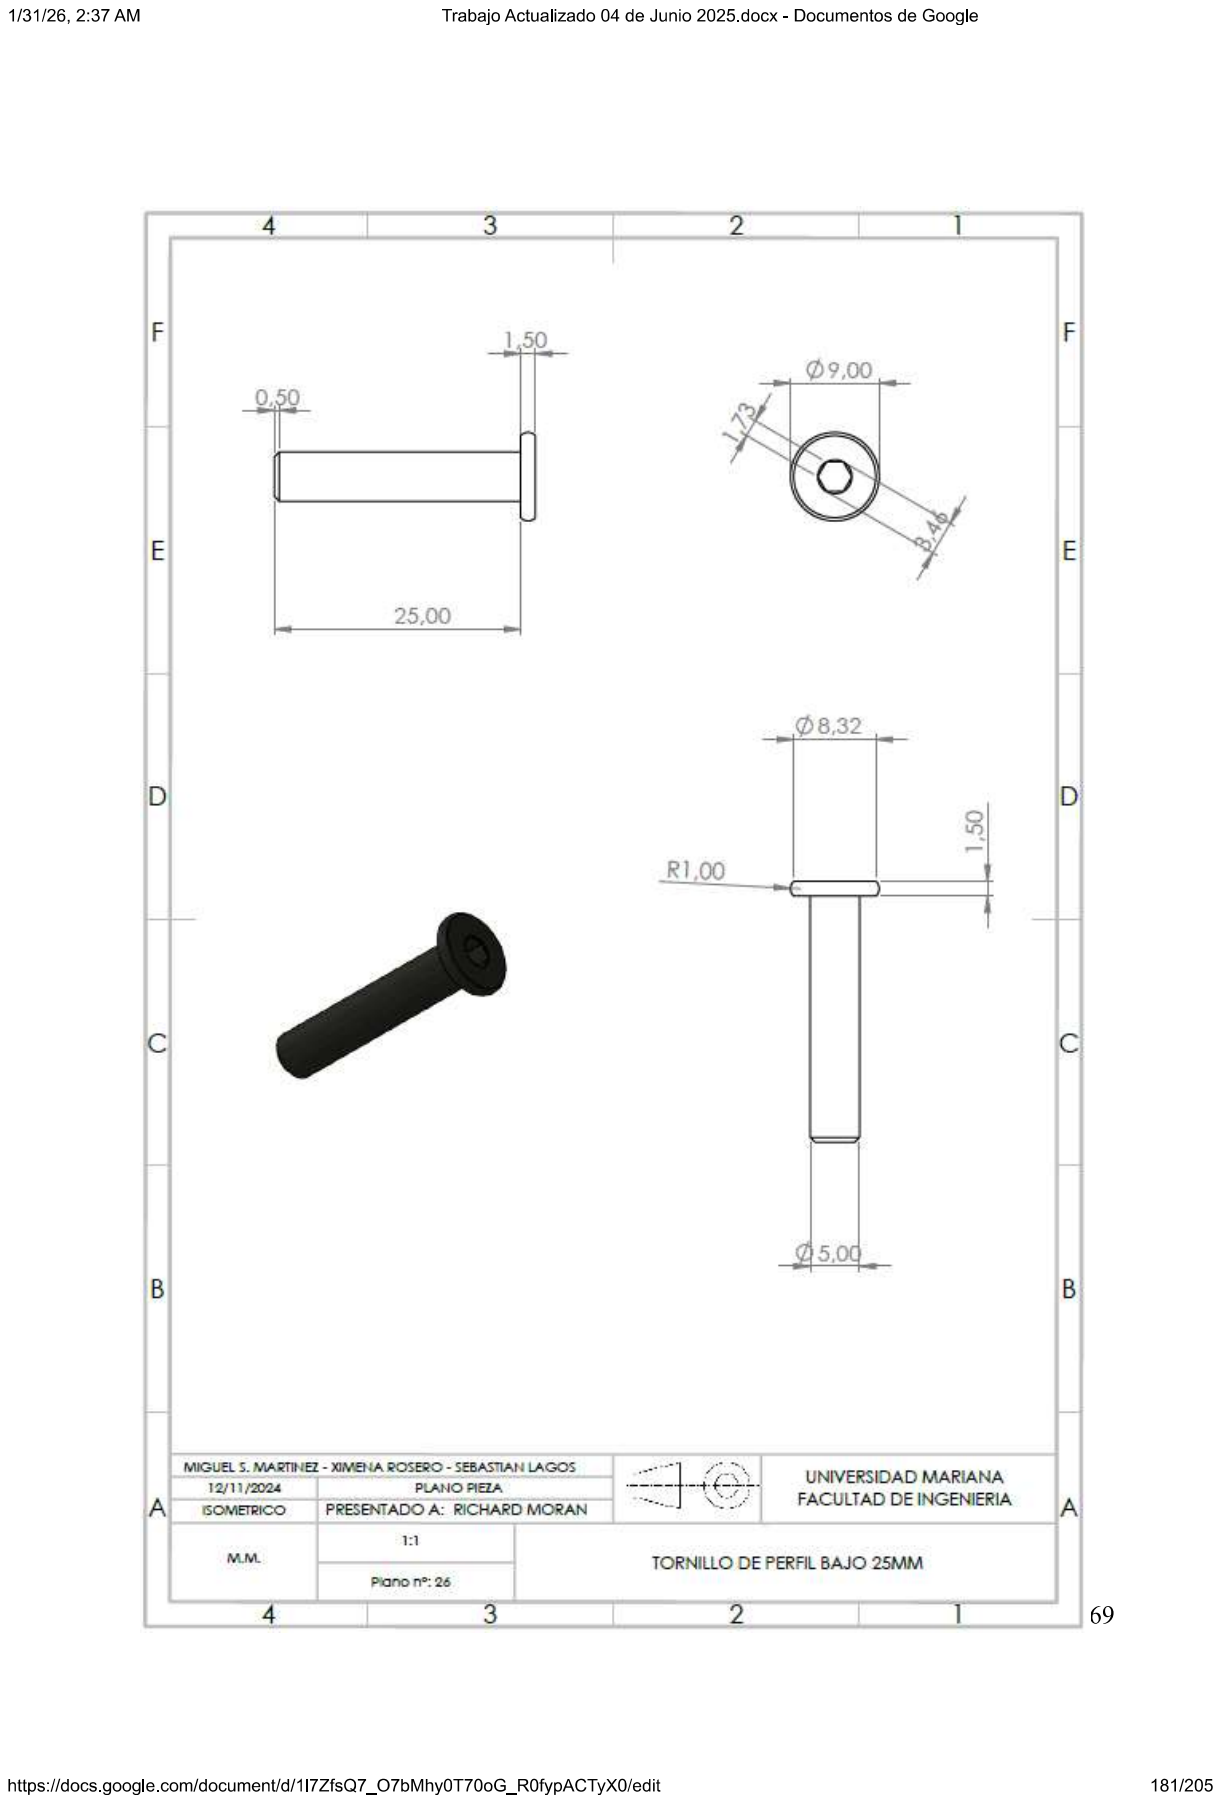
[picture p103: page 26]

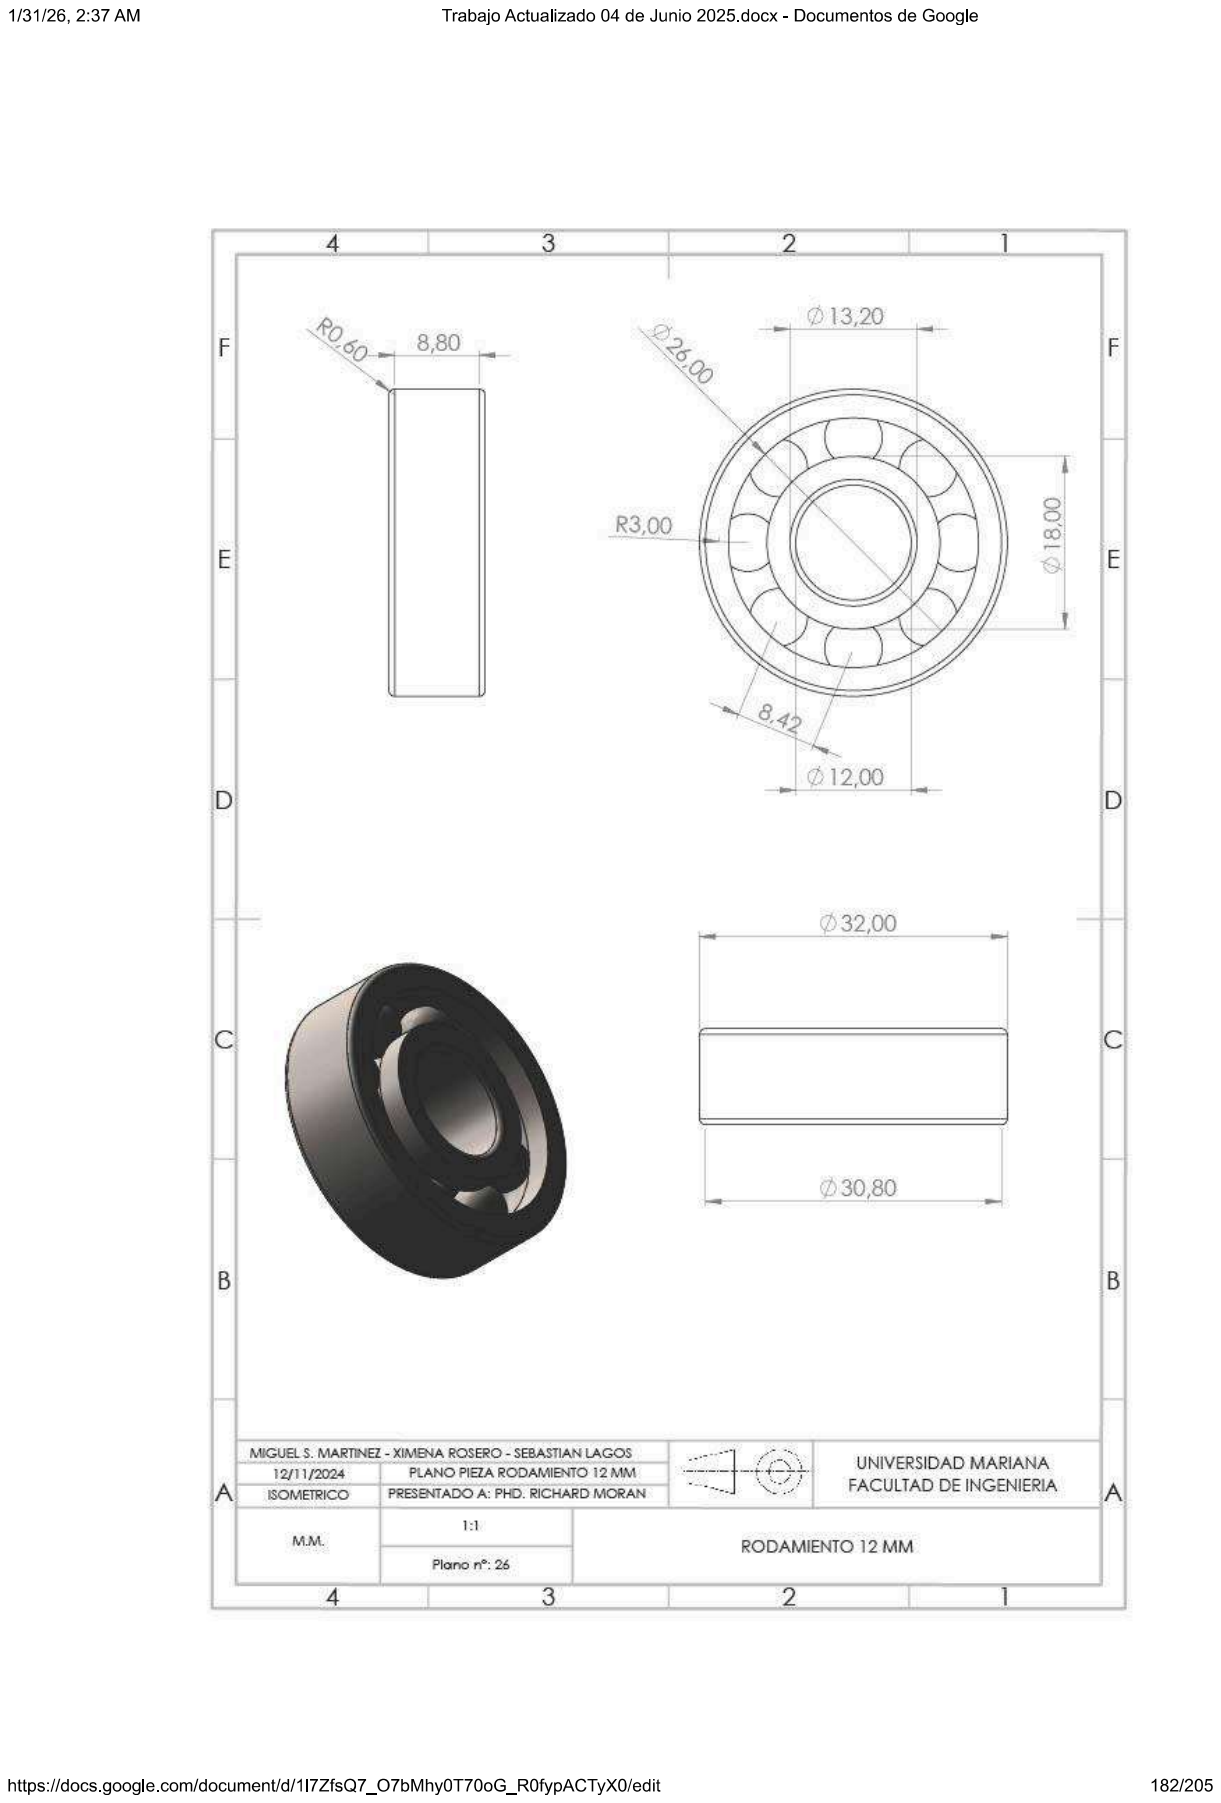
[picture p104: page 27]

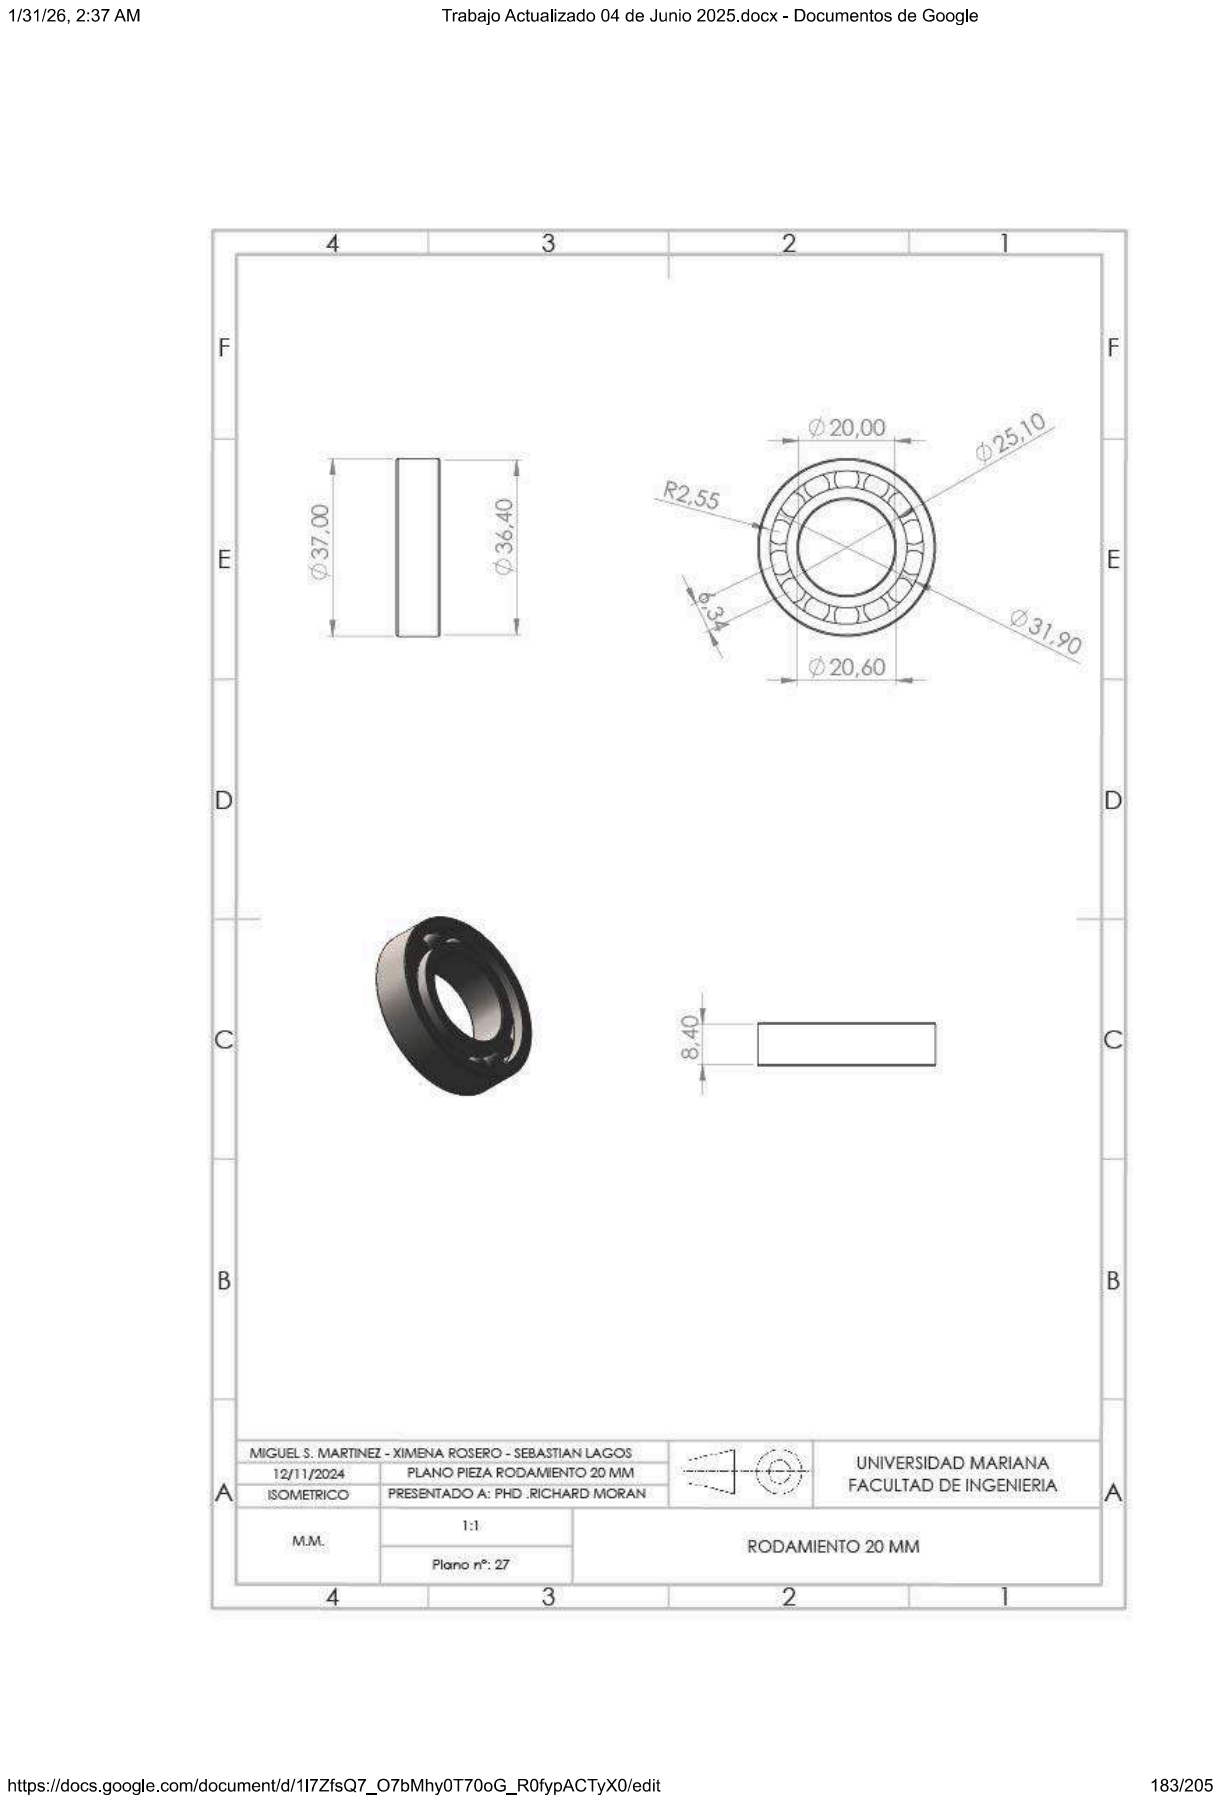
[picture p105: page 28]

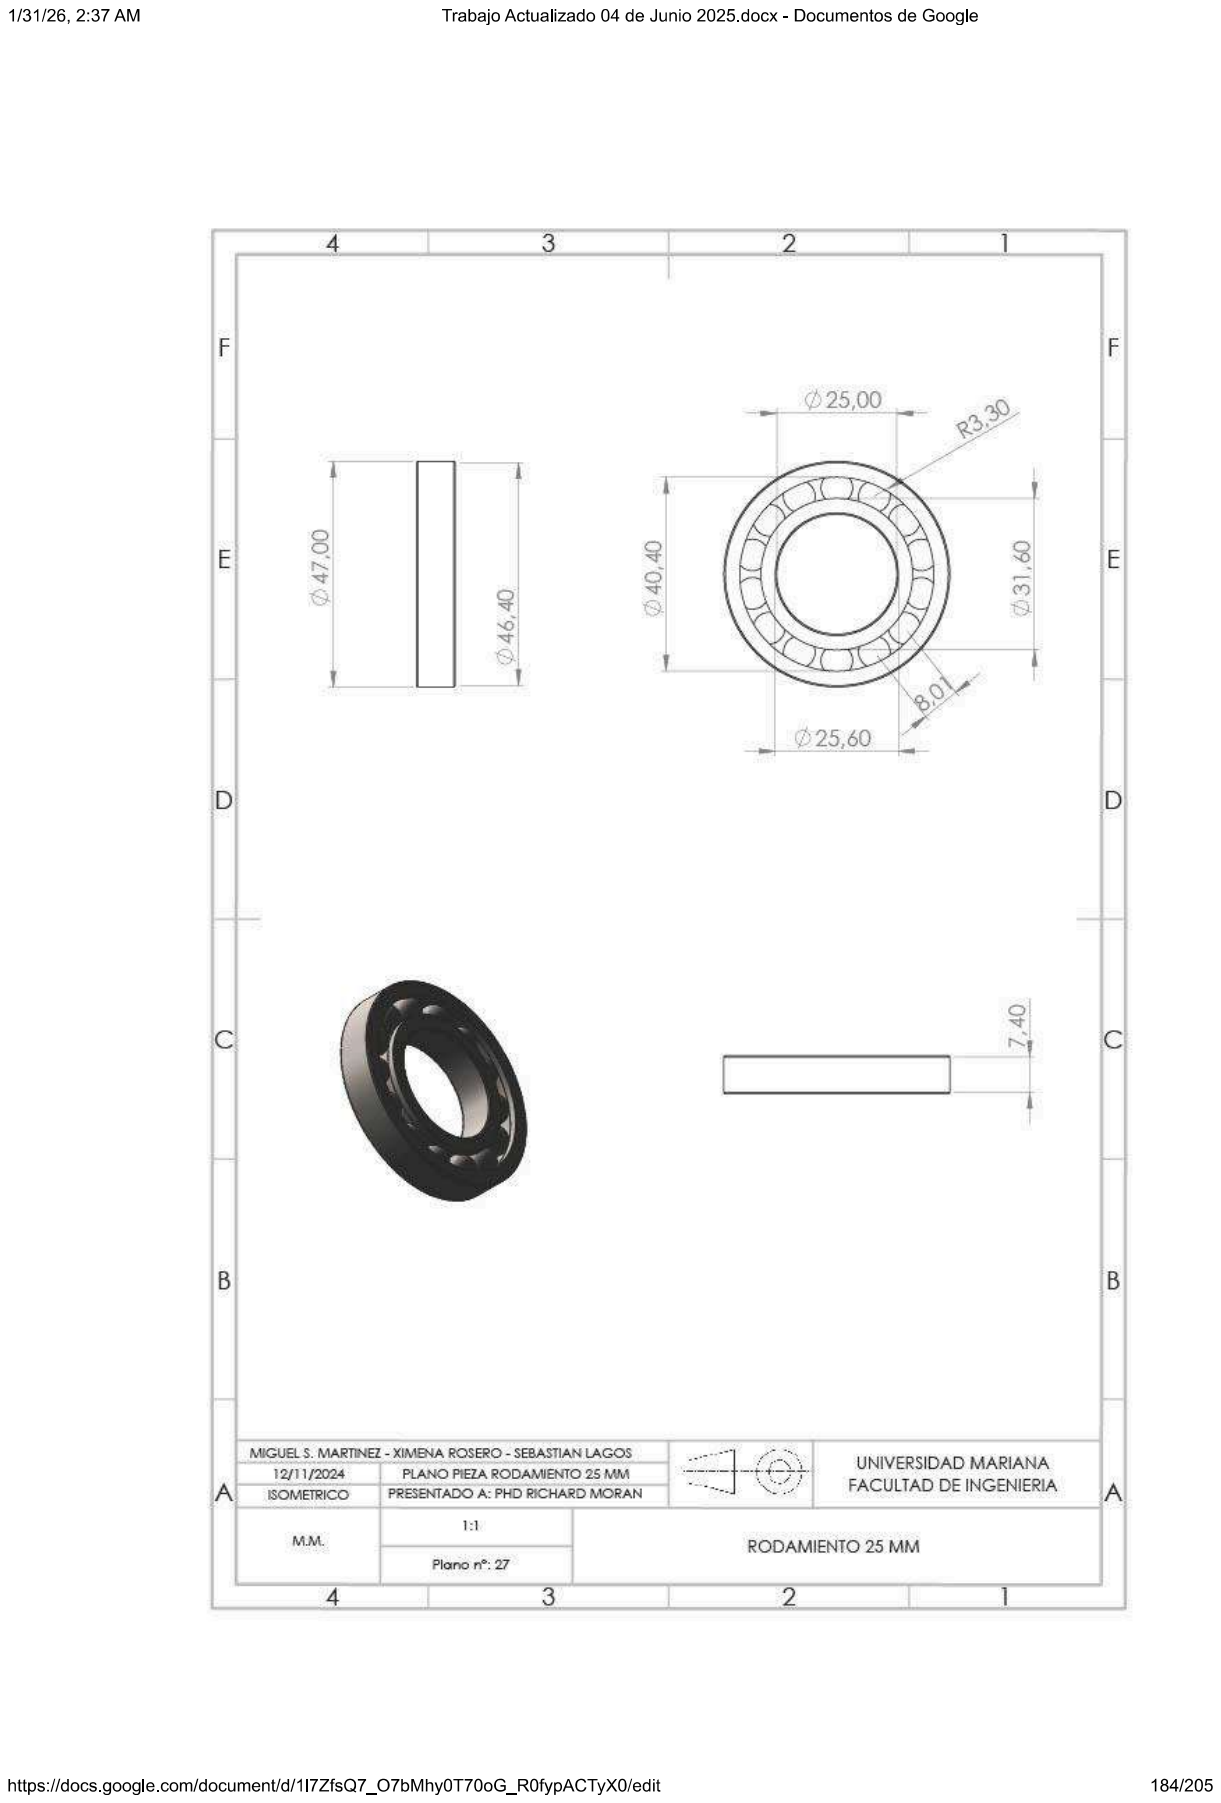
[picture p106: page 29]

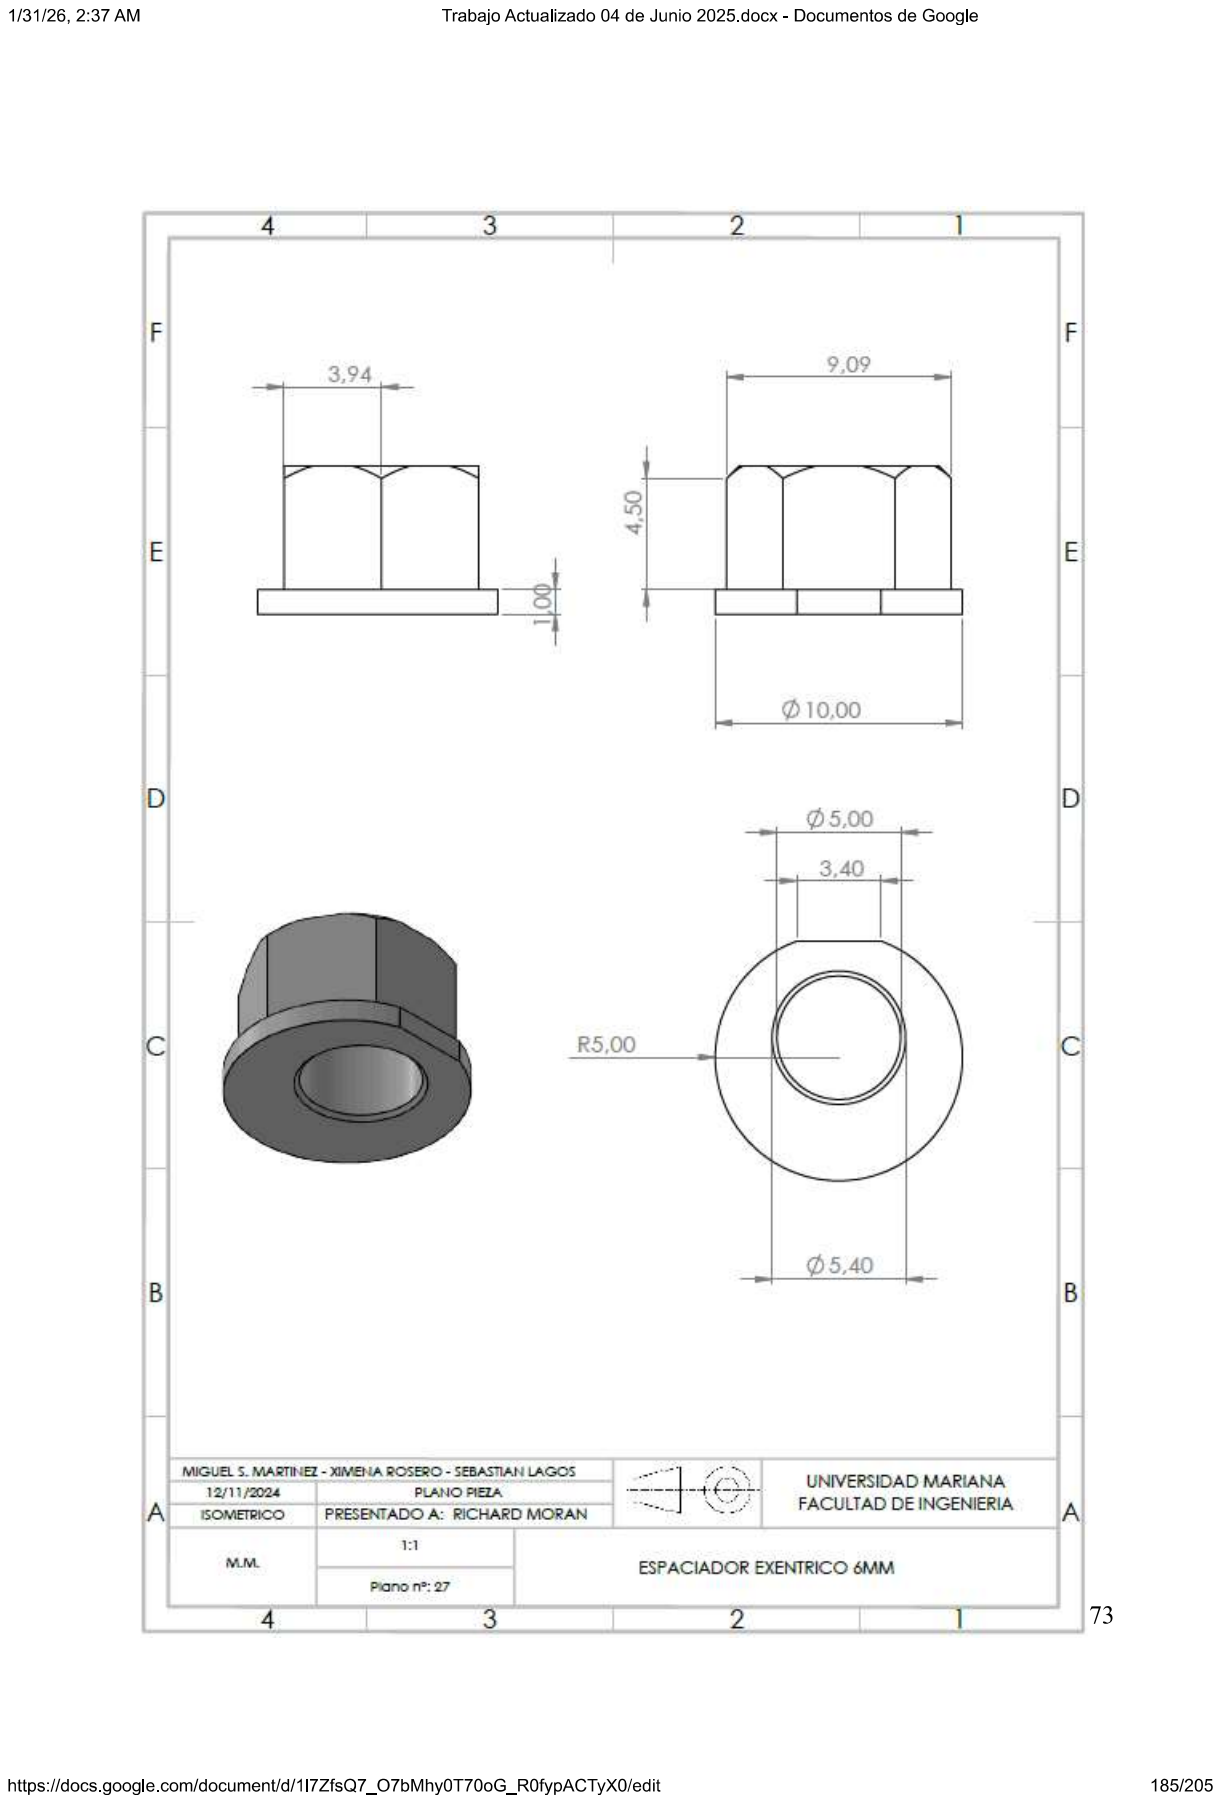
[picture p107: page 30]

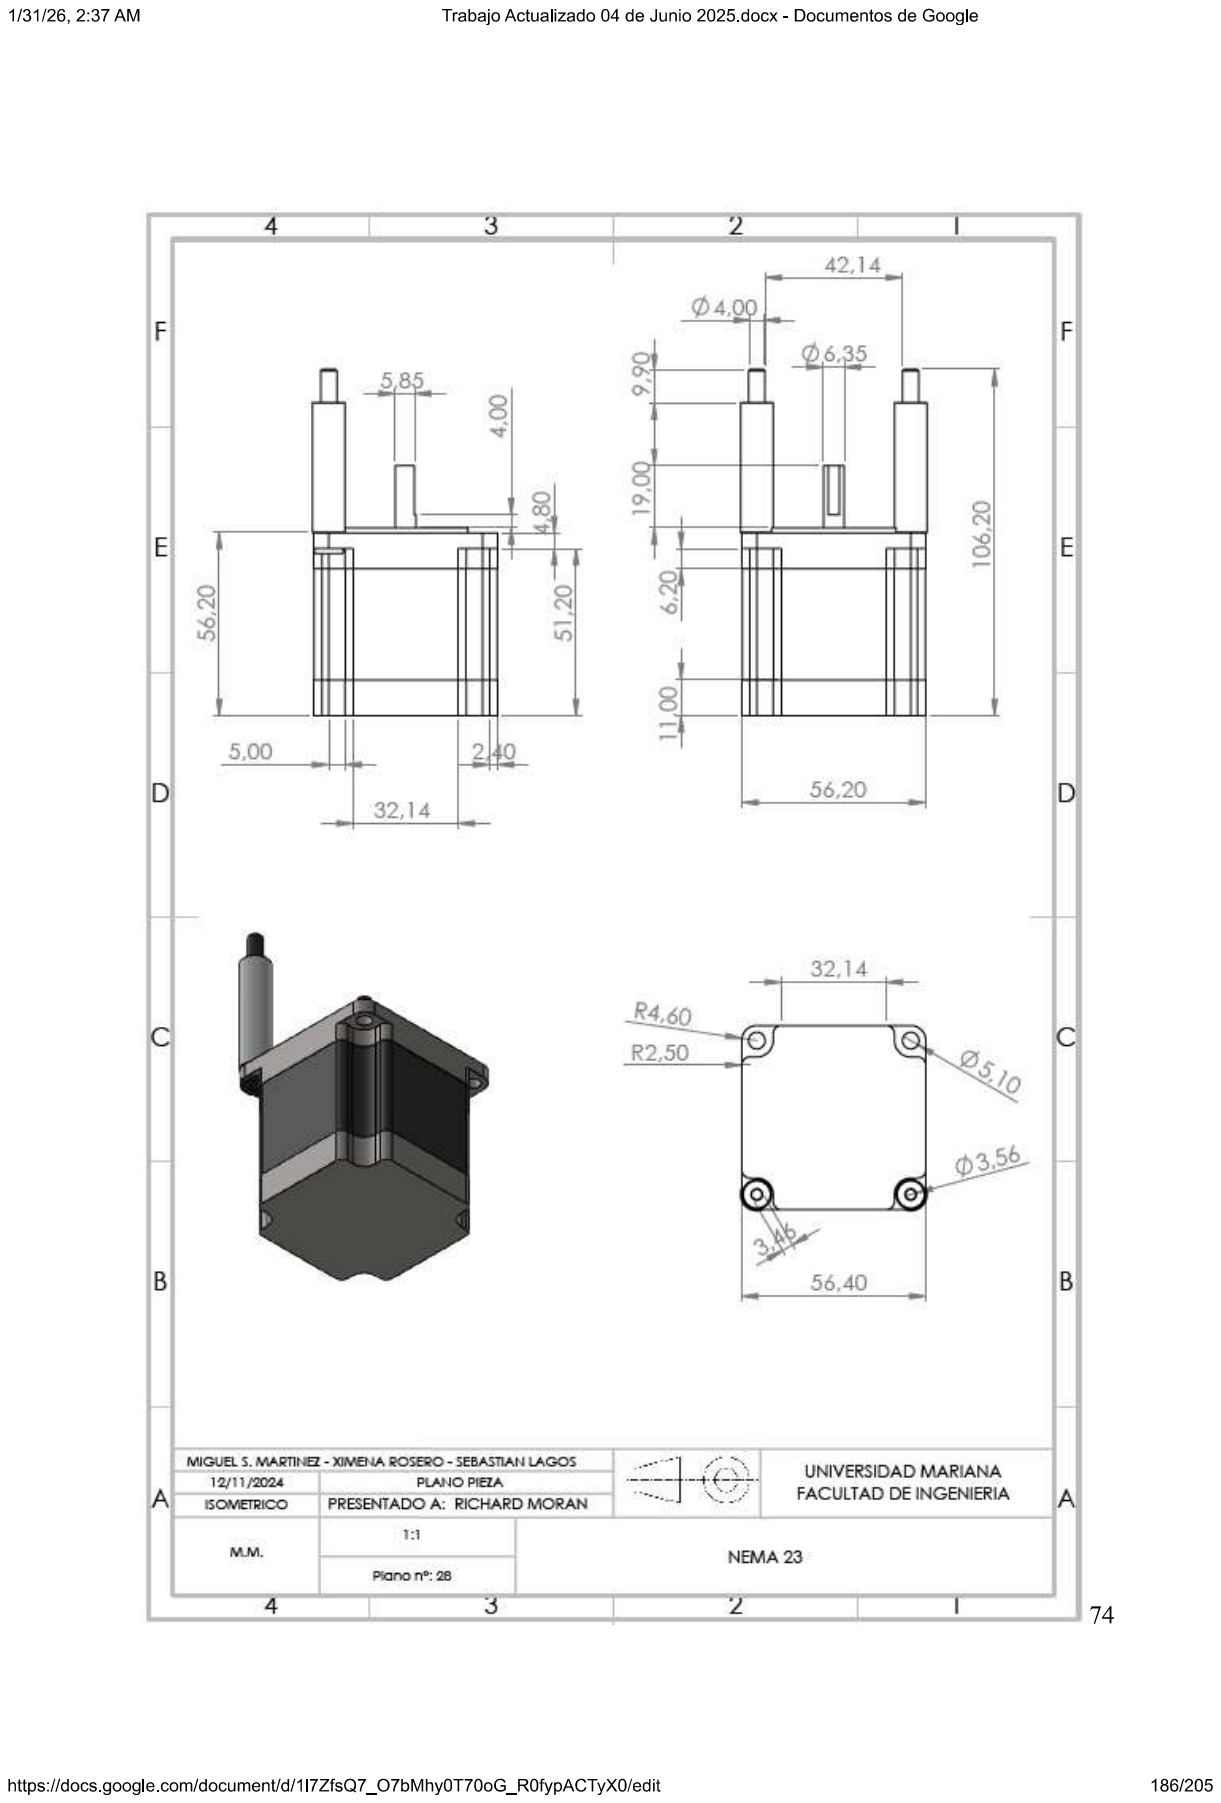
[picture p108: page 31]

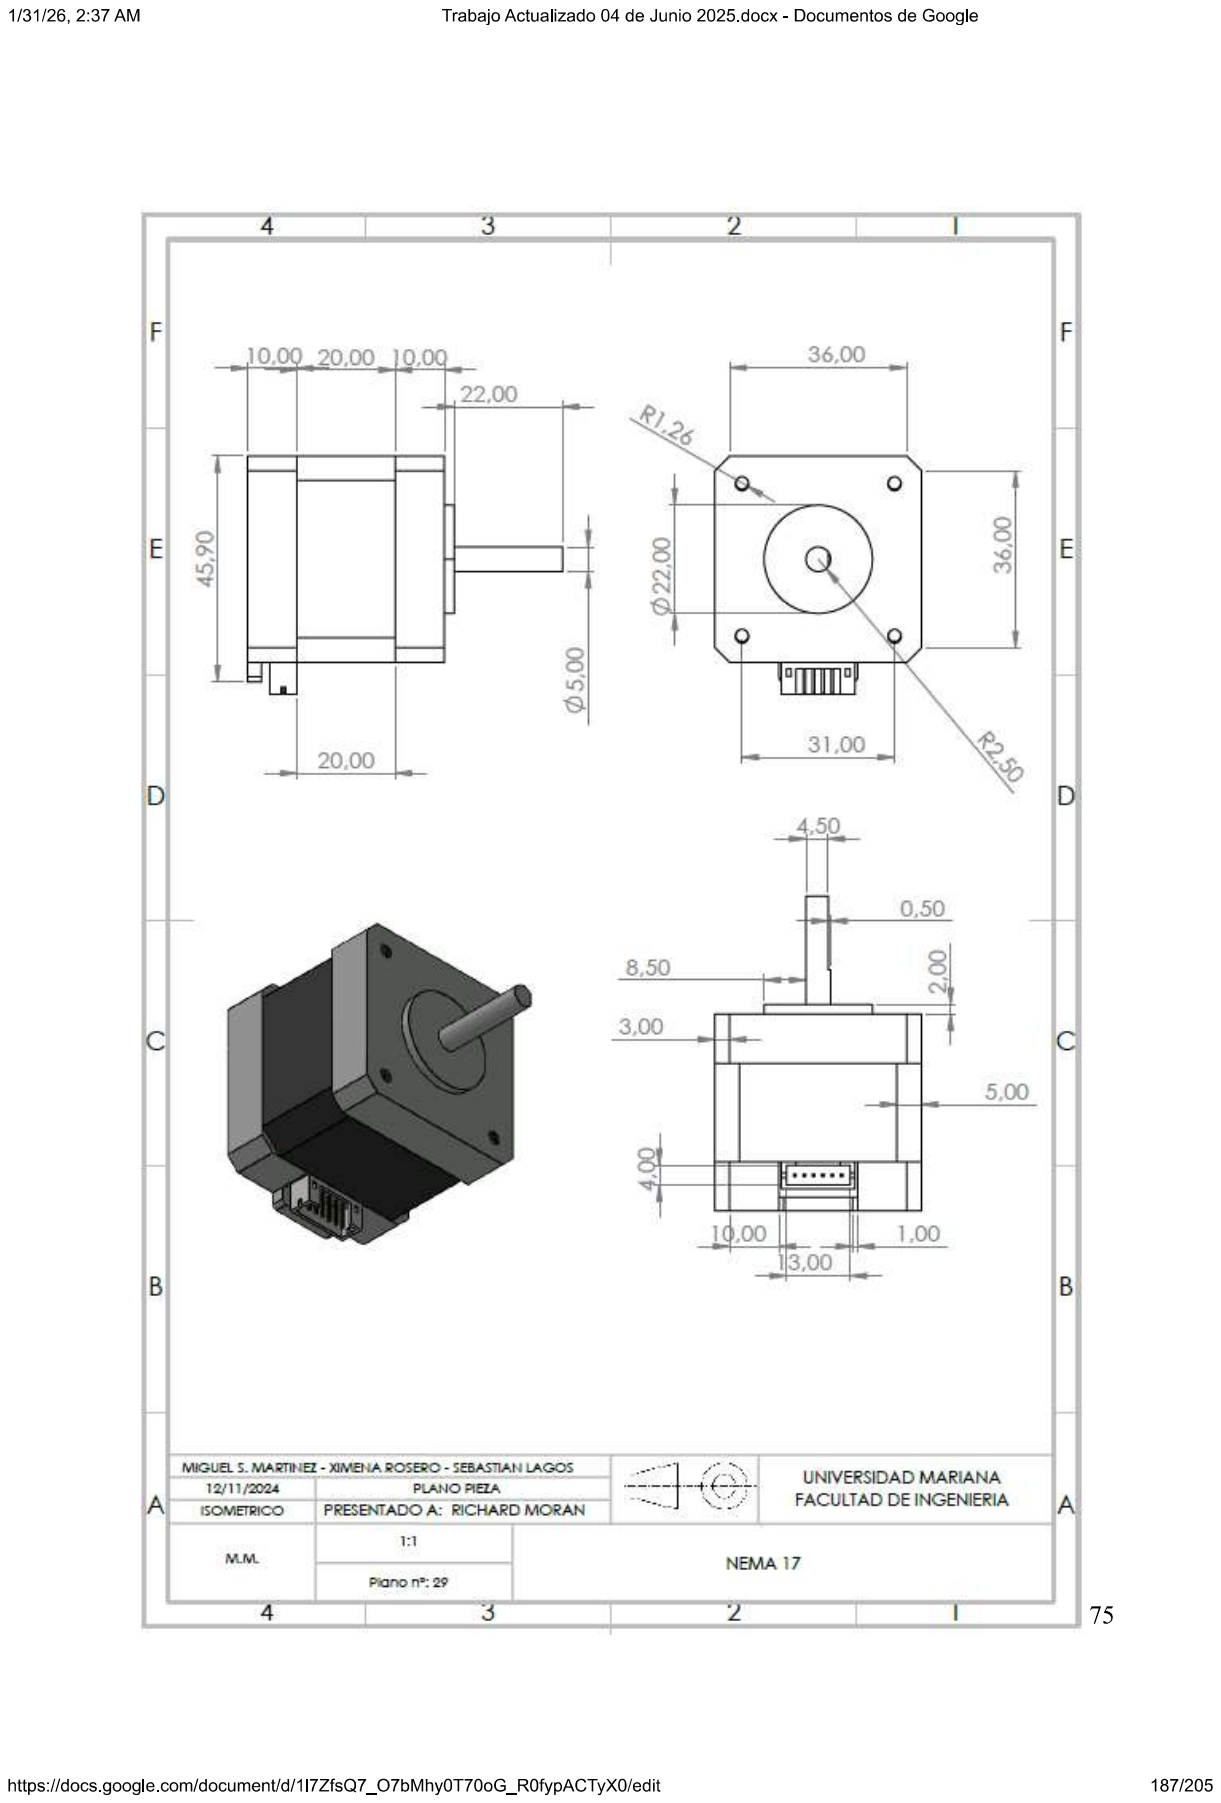
[picture p109: page 32]

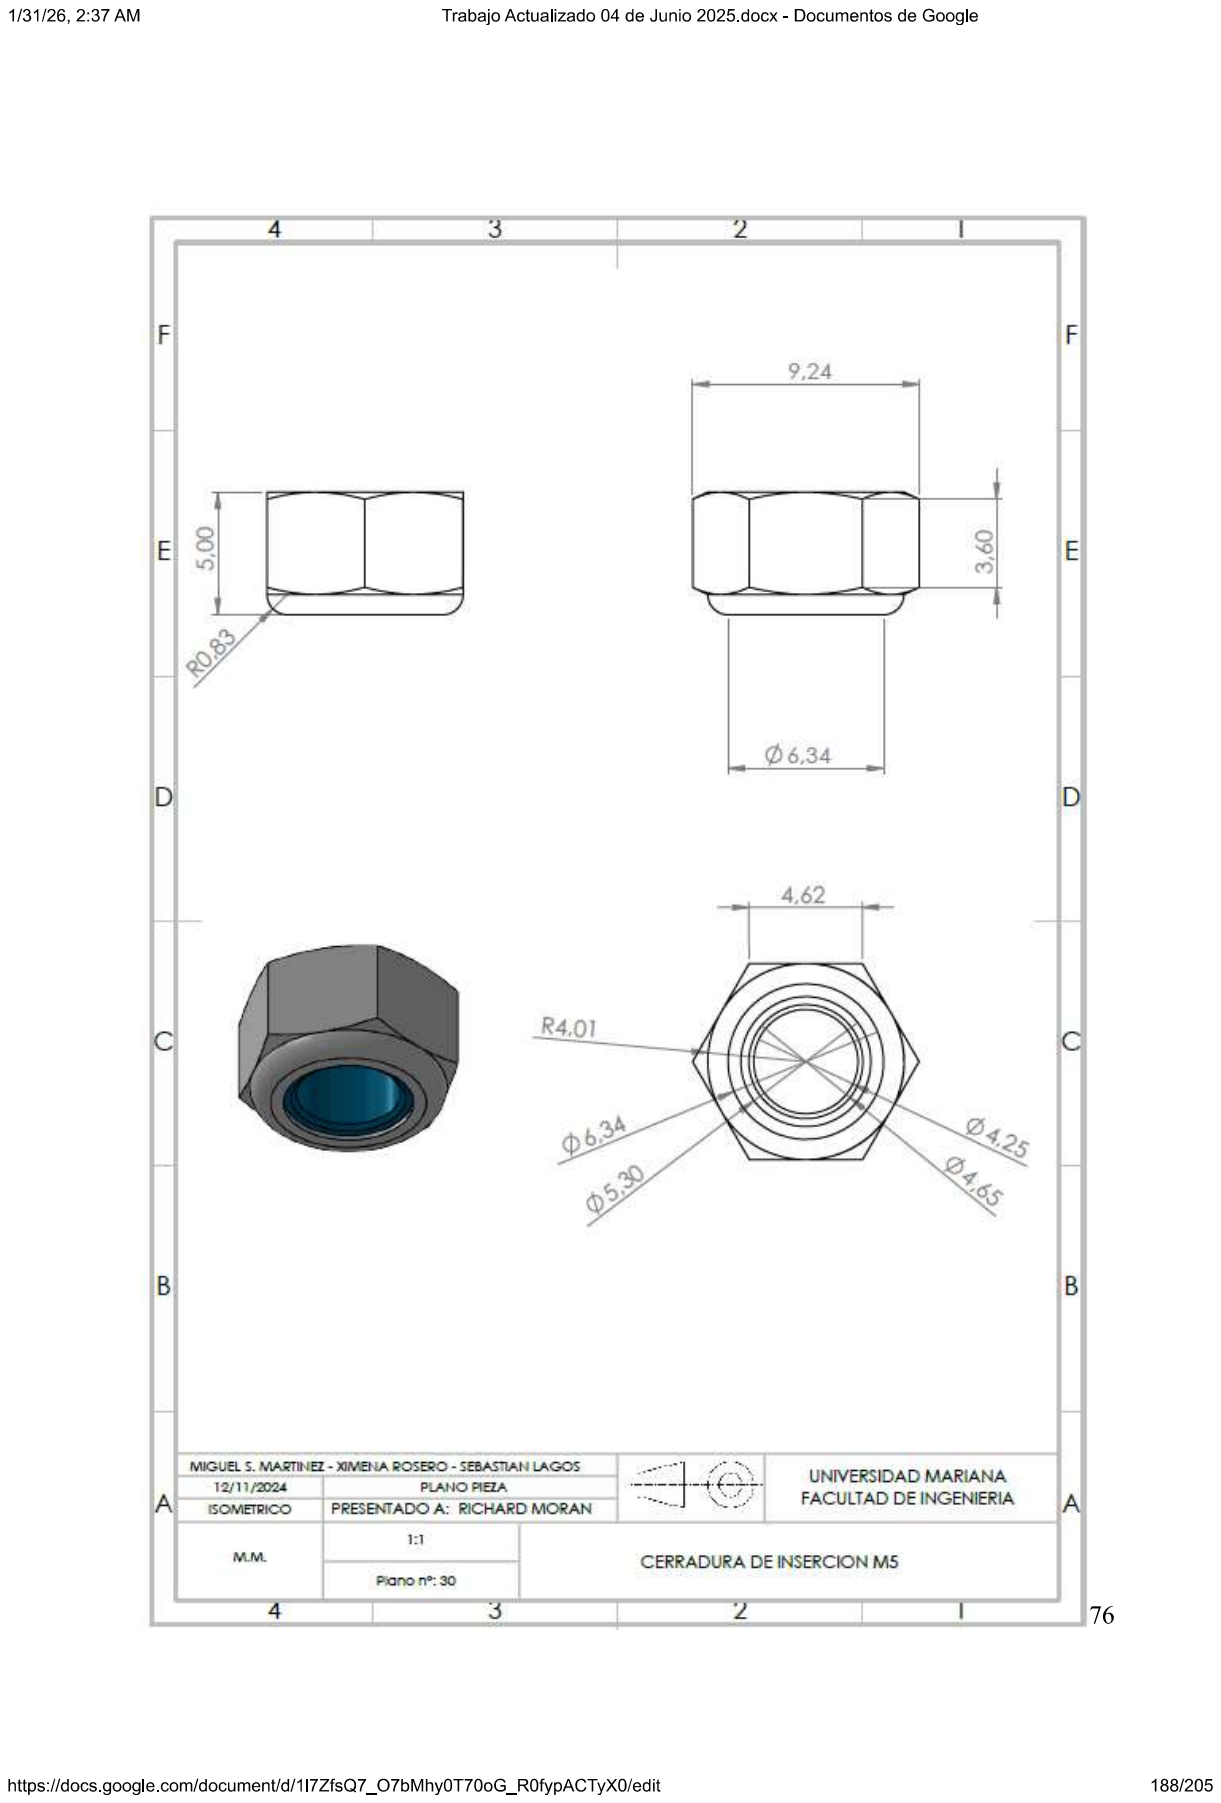
[picture p110: page 33]

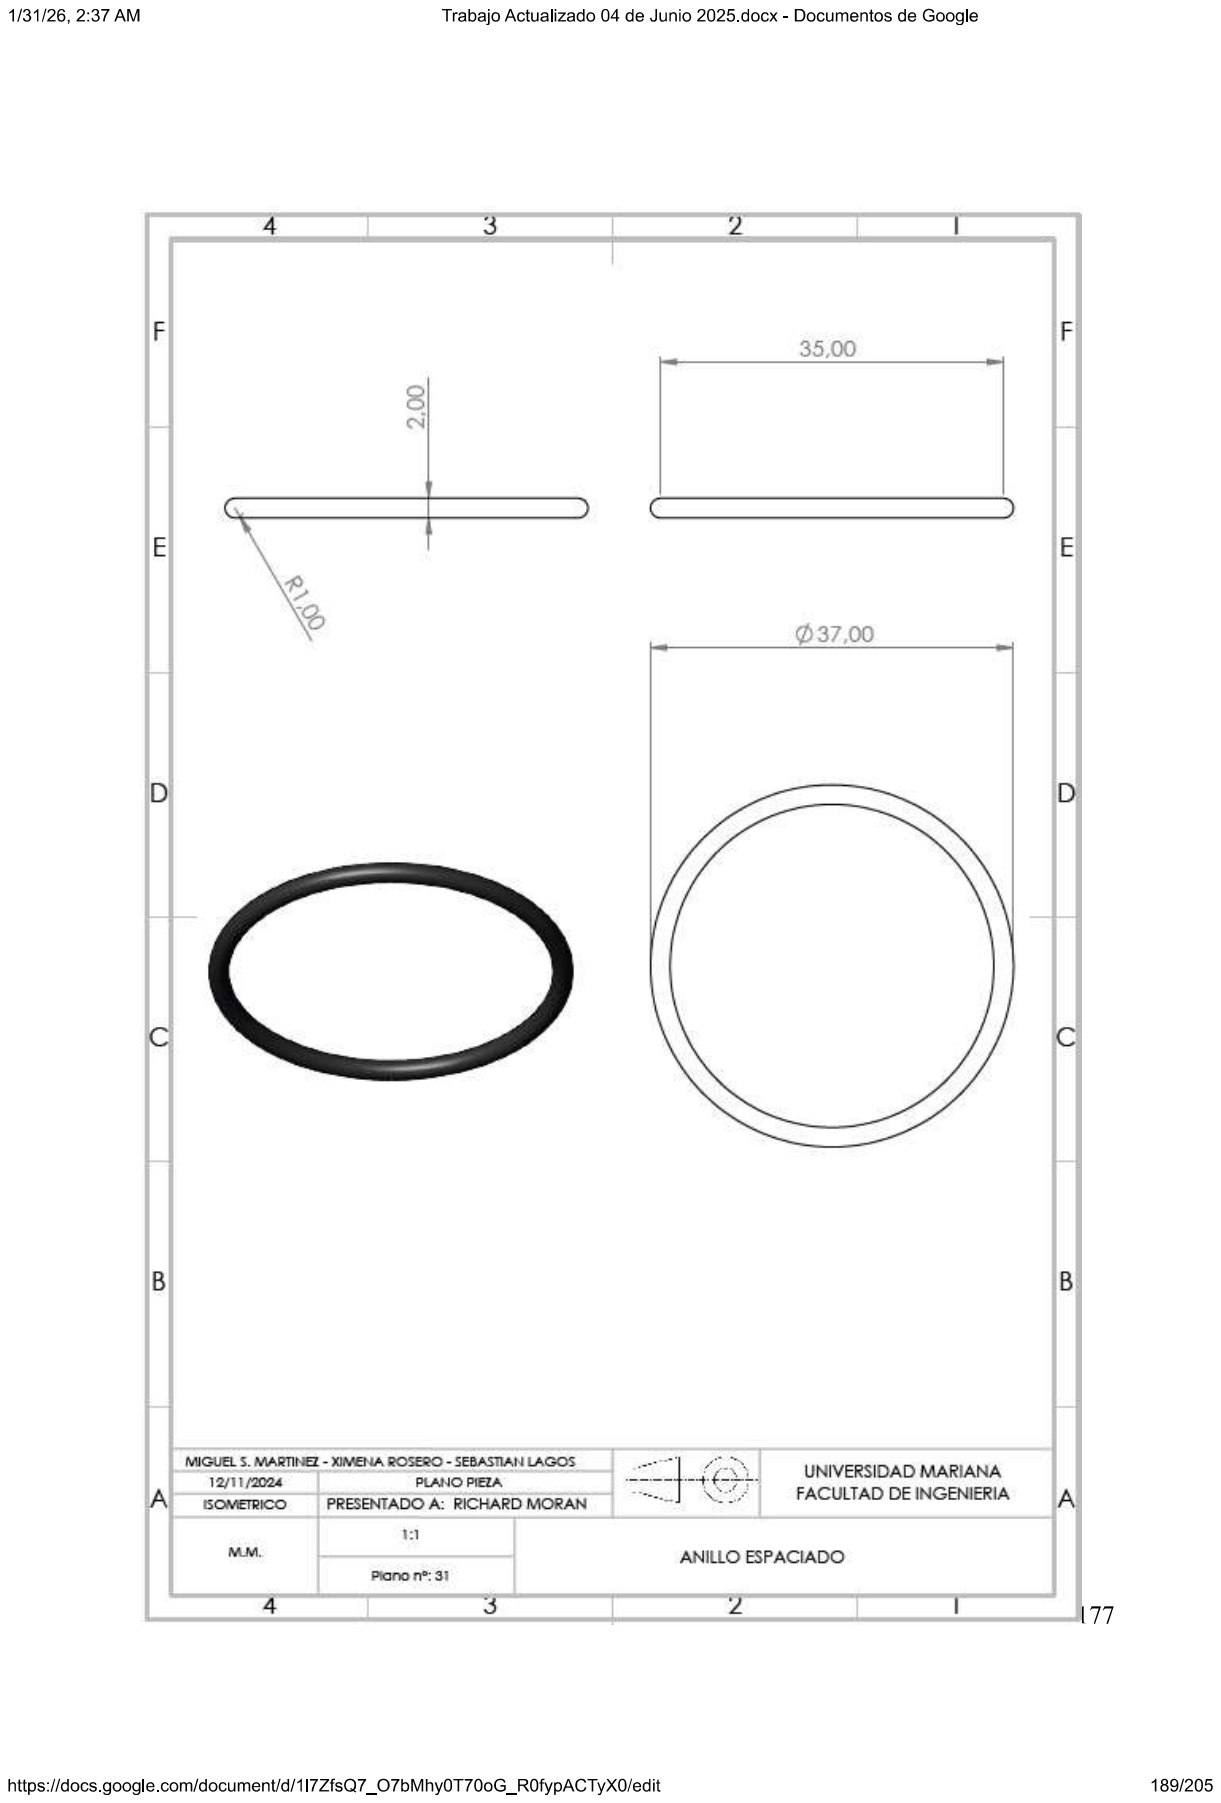
[picture p111: page 34]

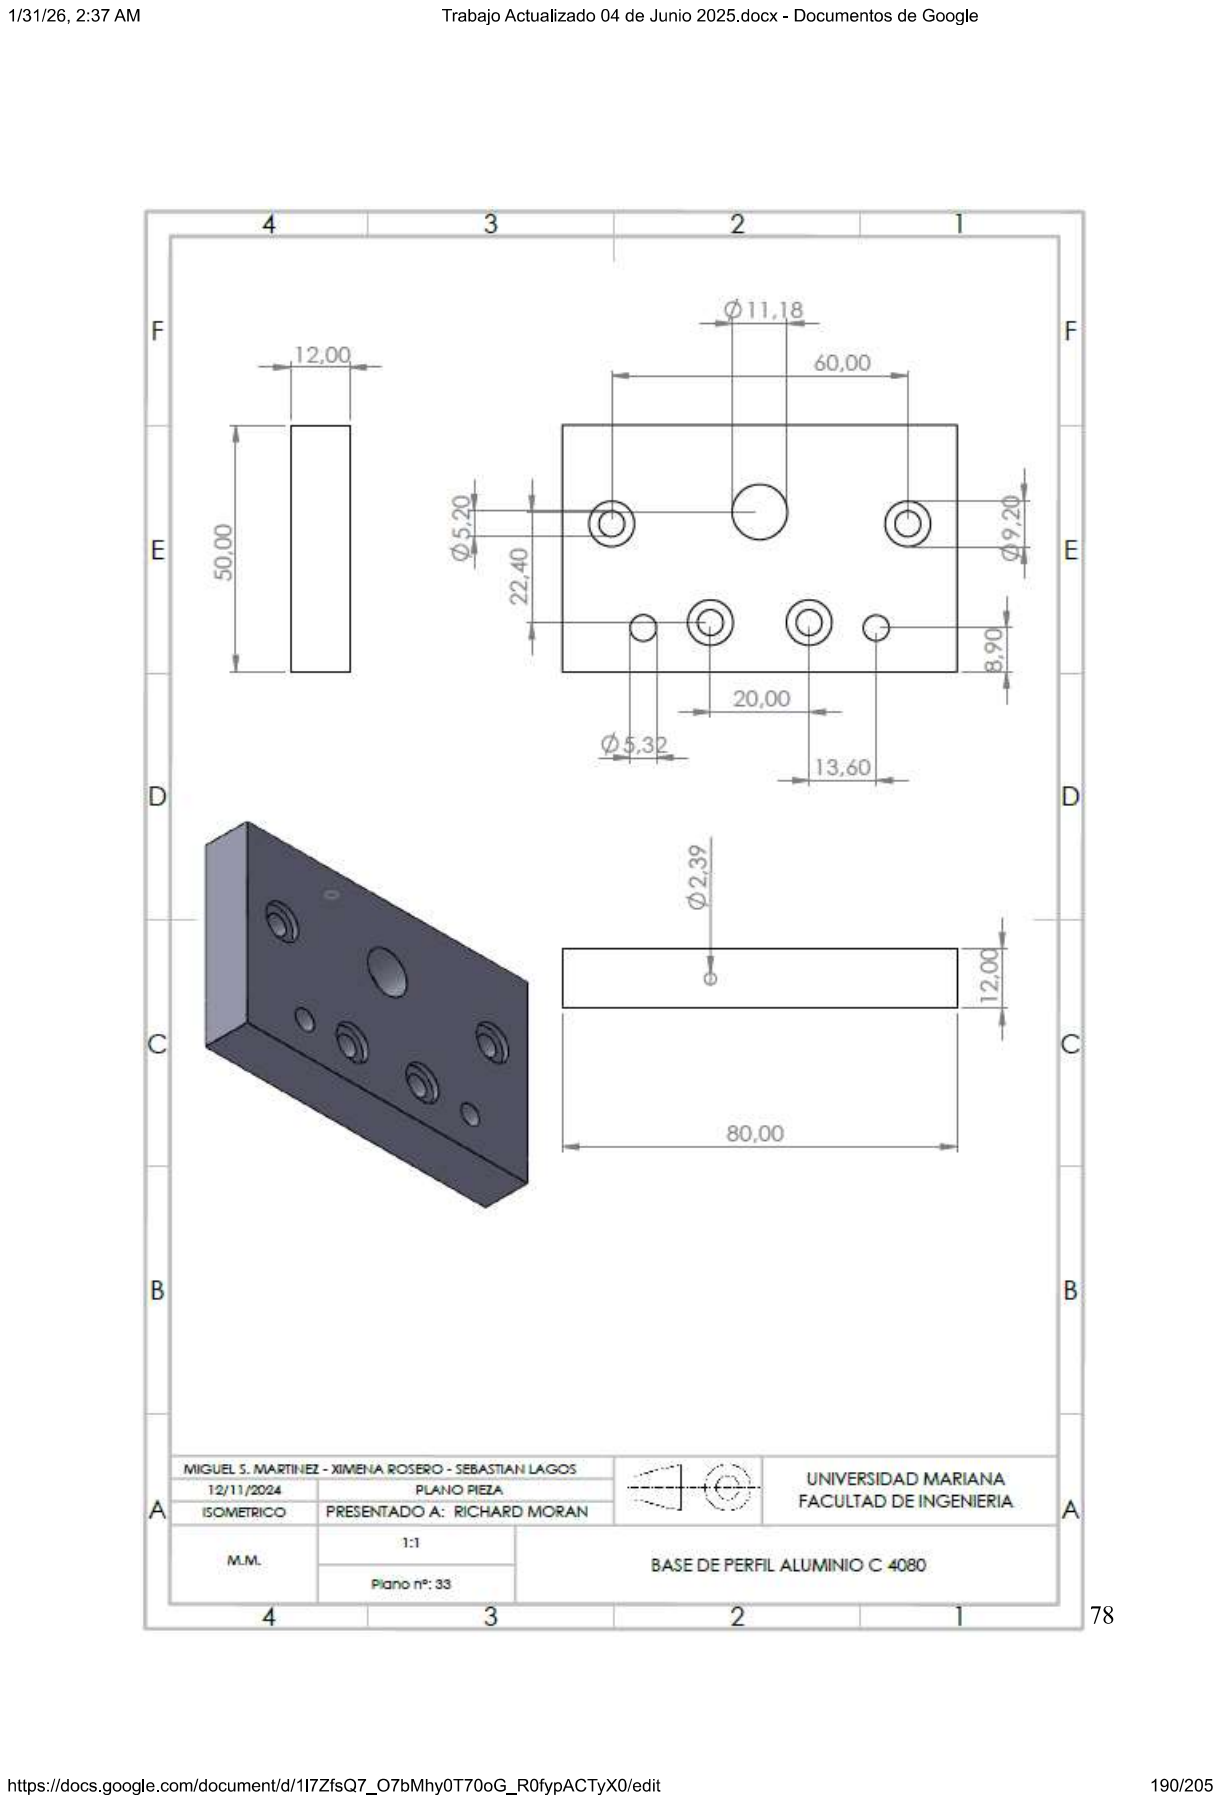
[picture p112: page 35]

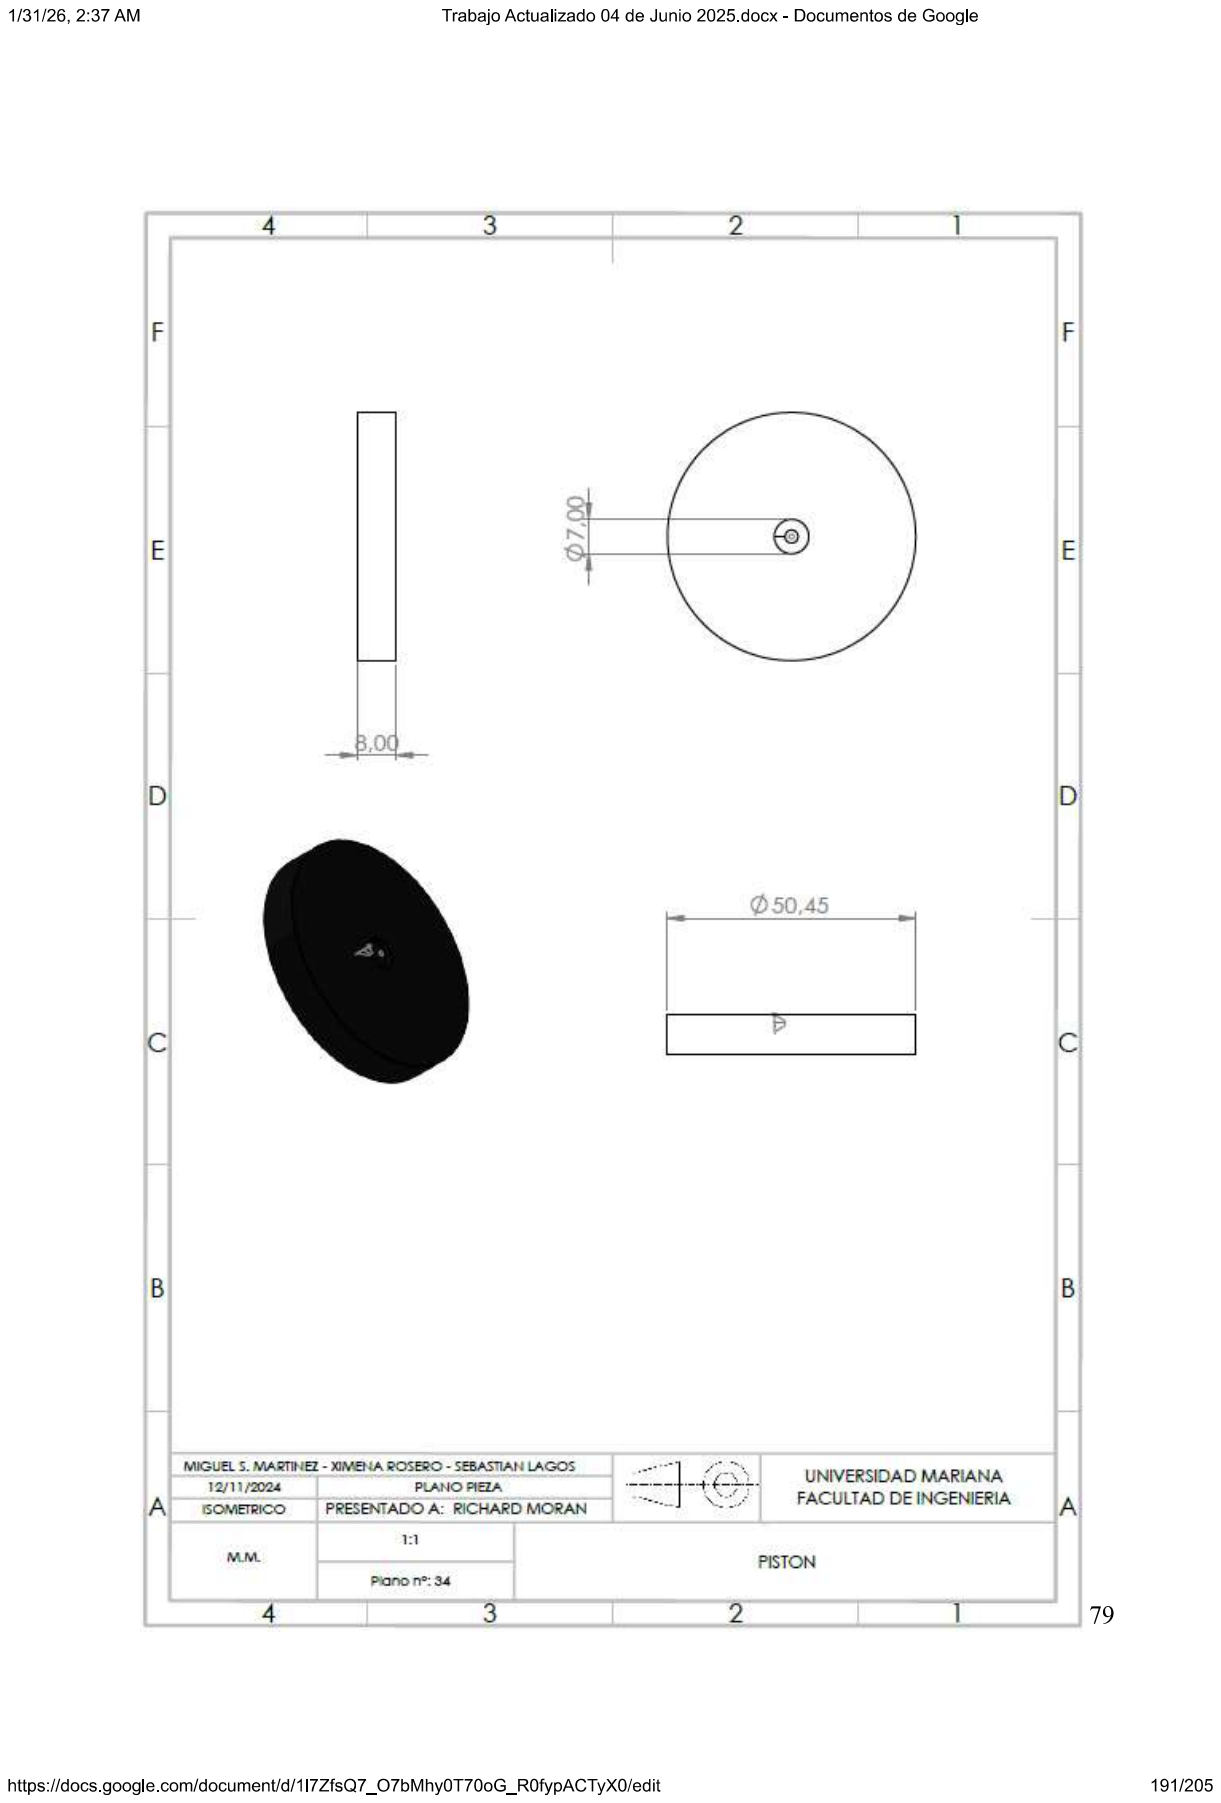
[picture p113: page 36]

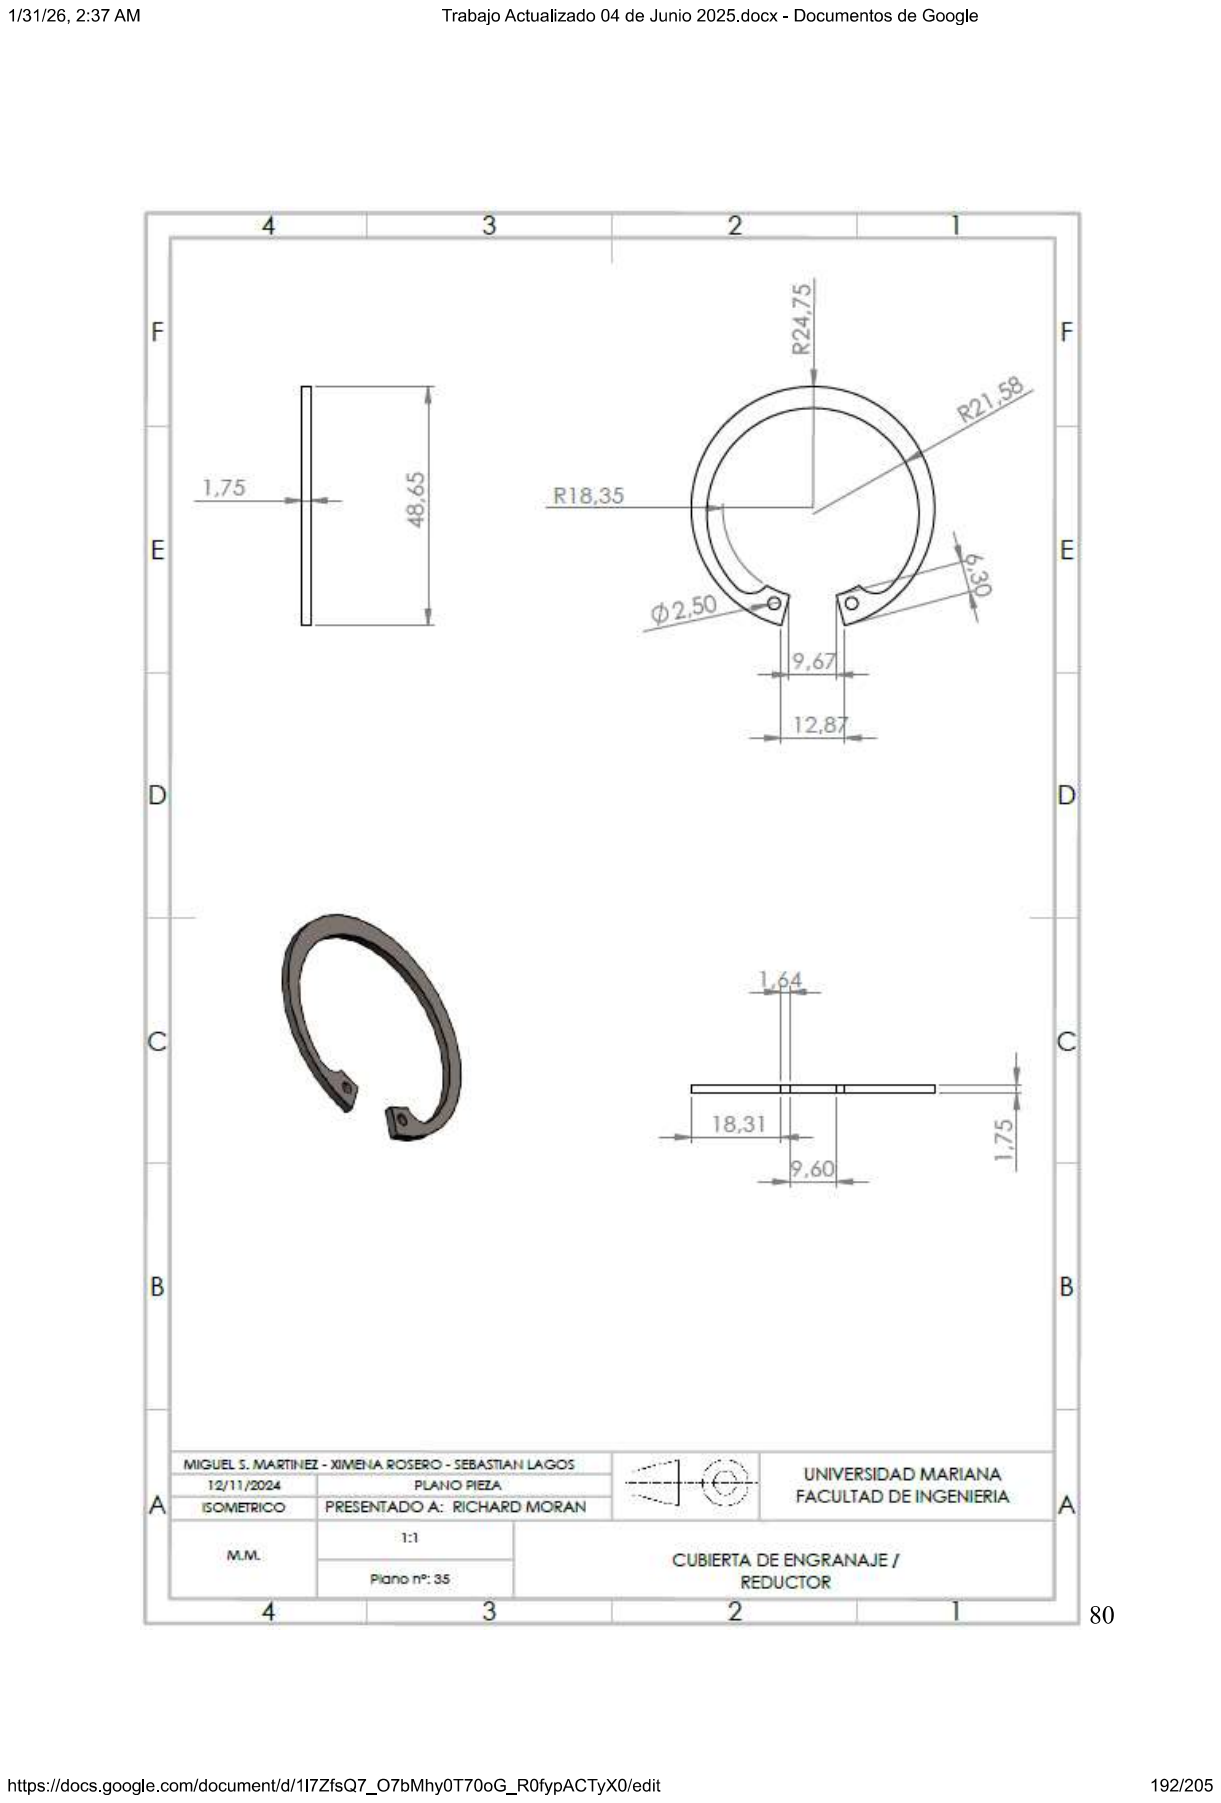
[picture p114: page 37]

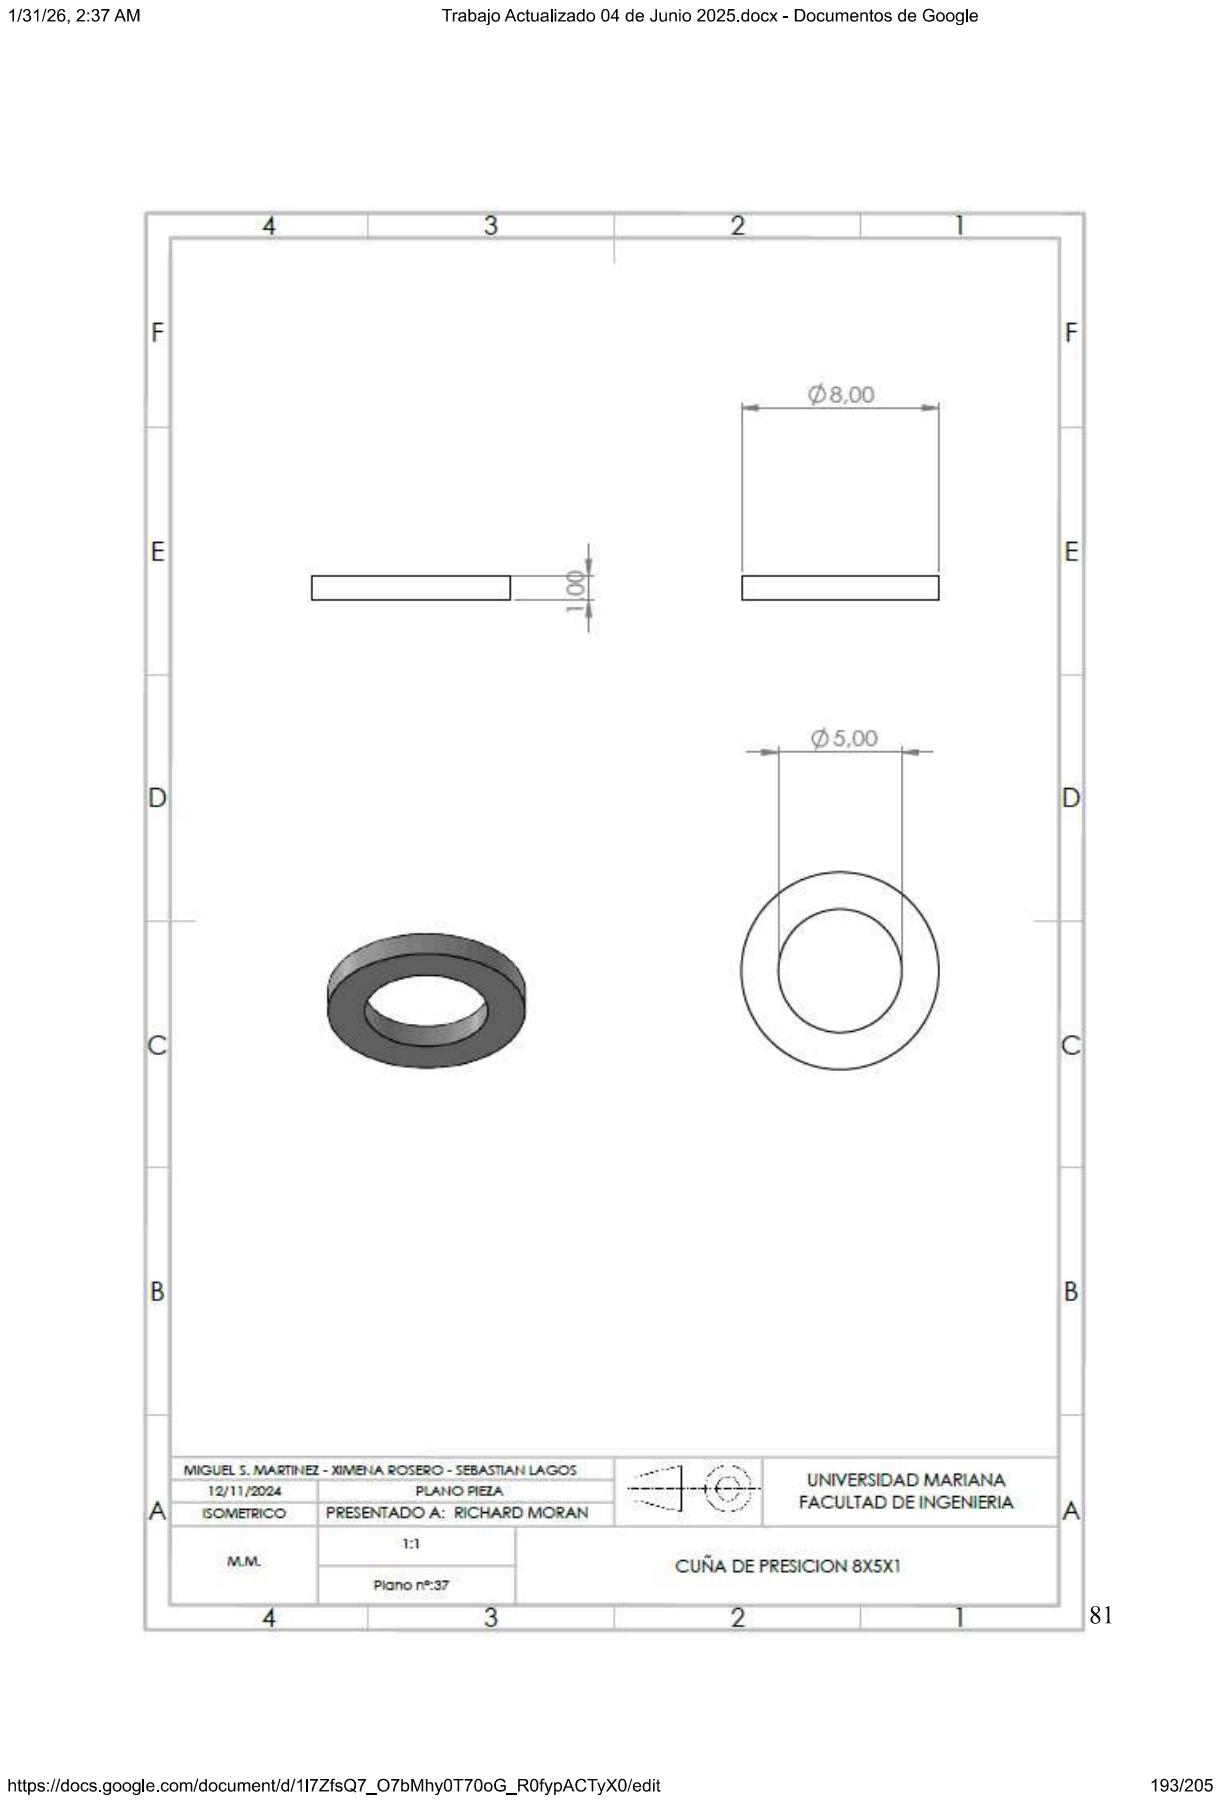
[picture p115: page 38]

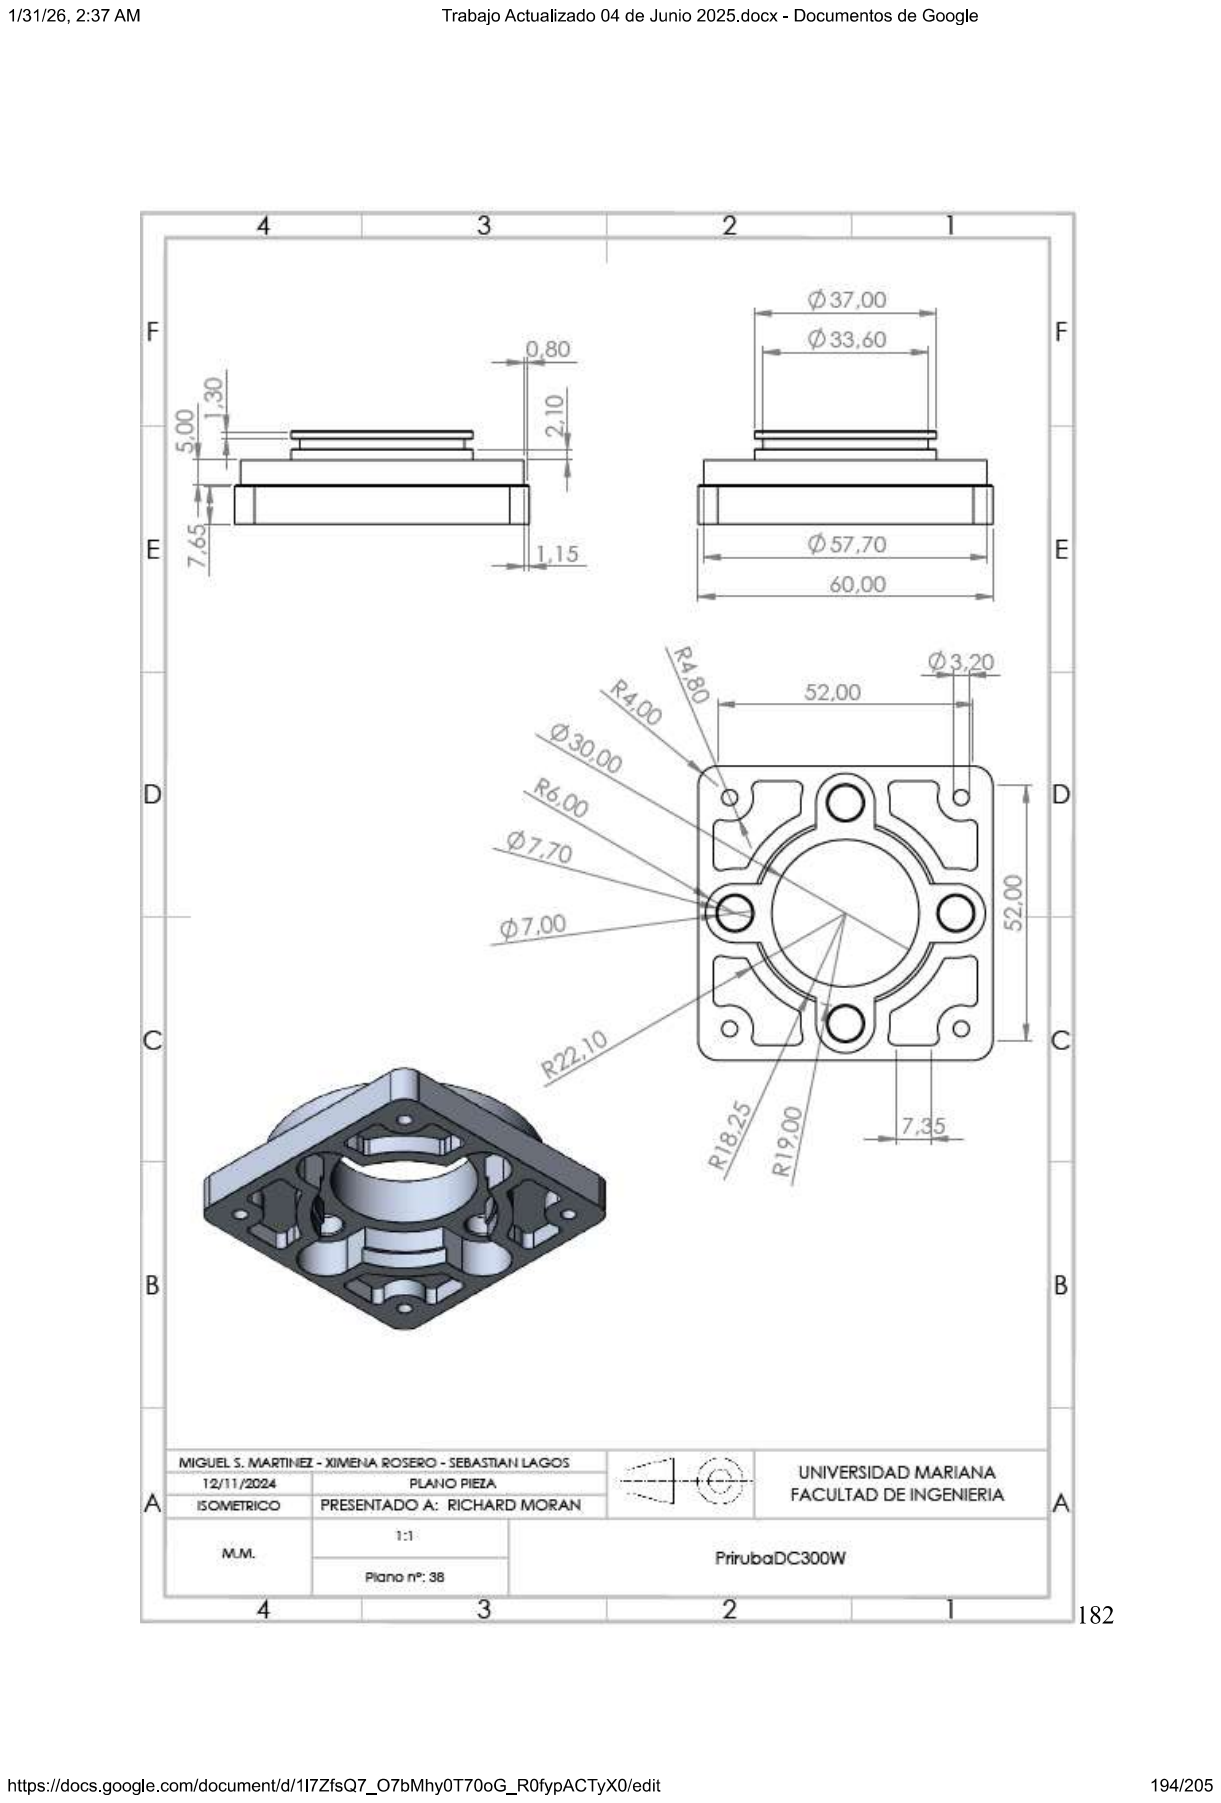
[picture p116: page 39]

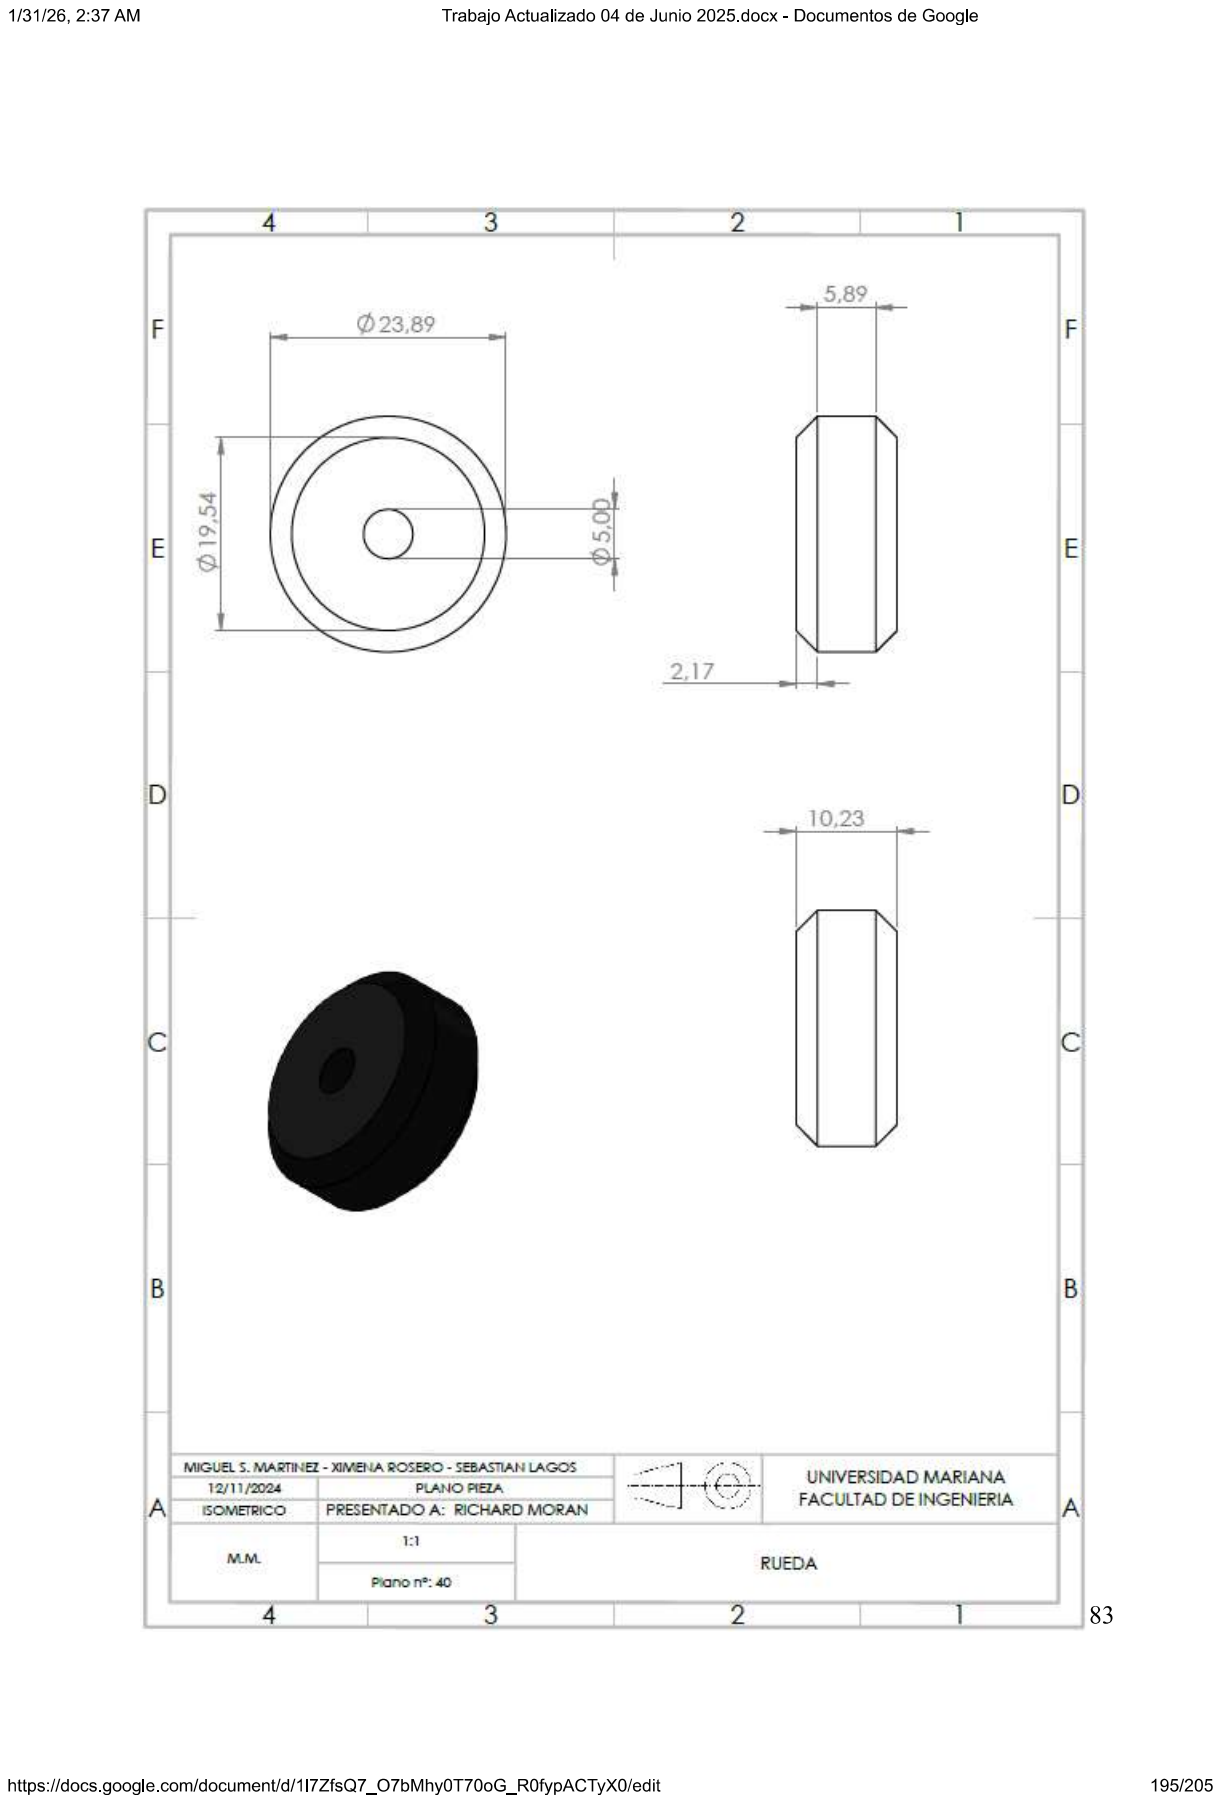
[picture p117: page 40]

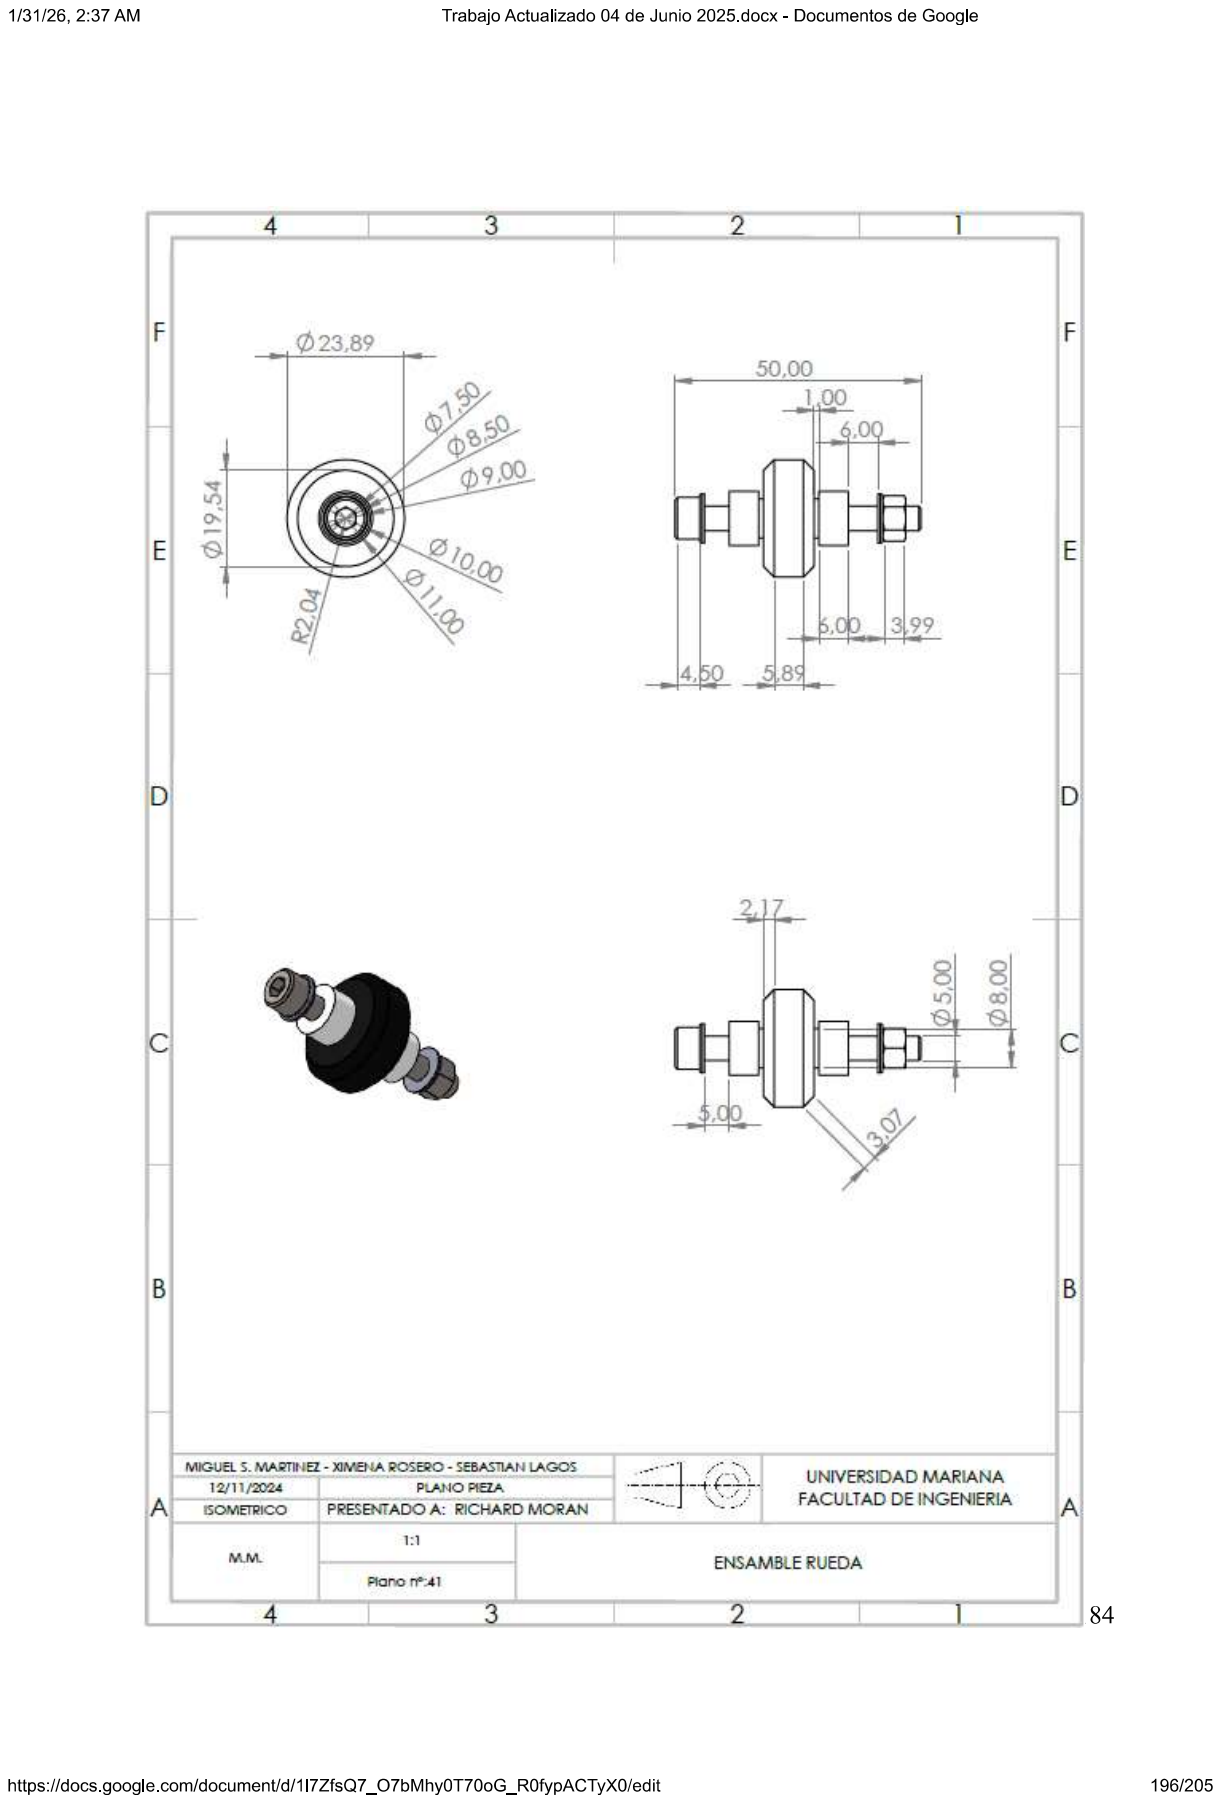
[picture p118: page 41]

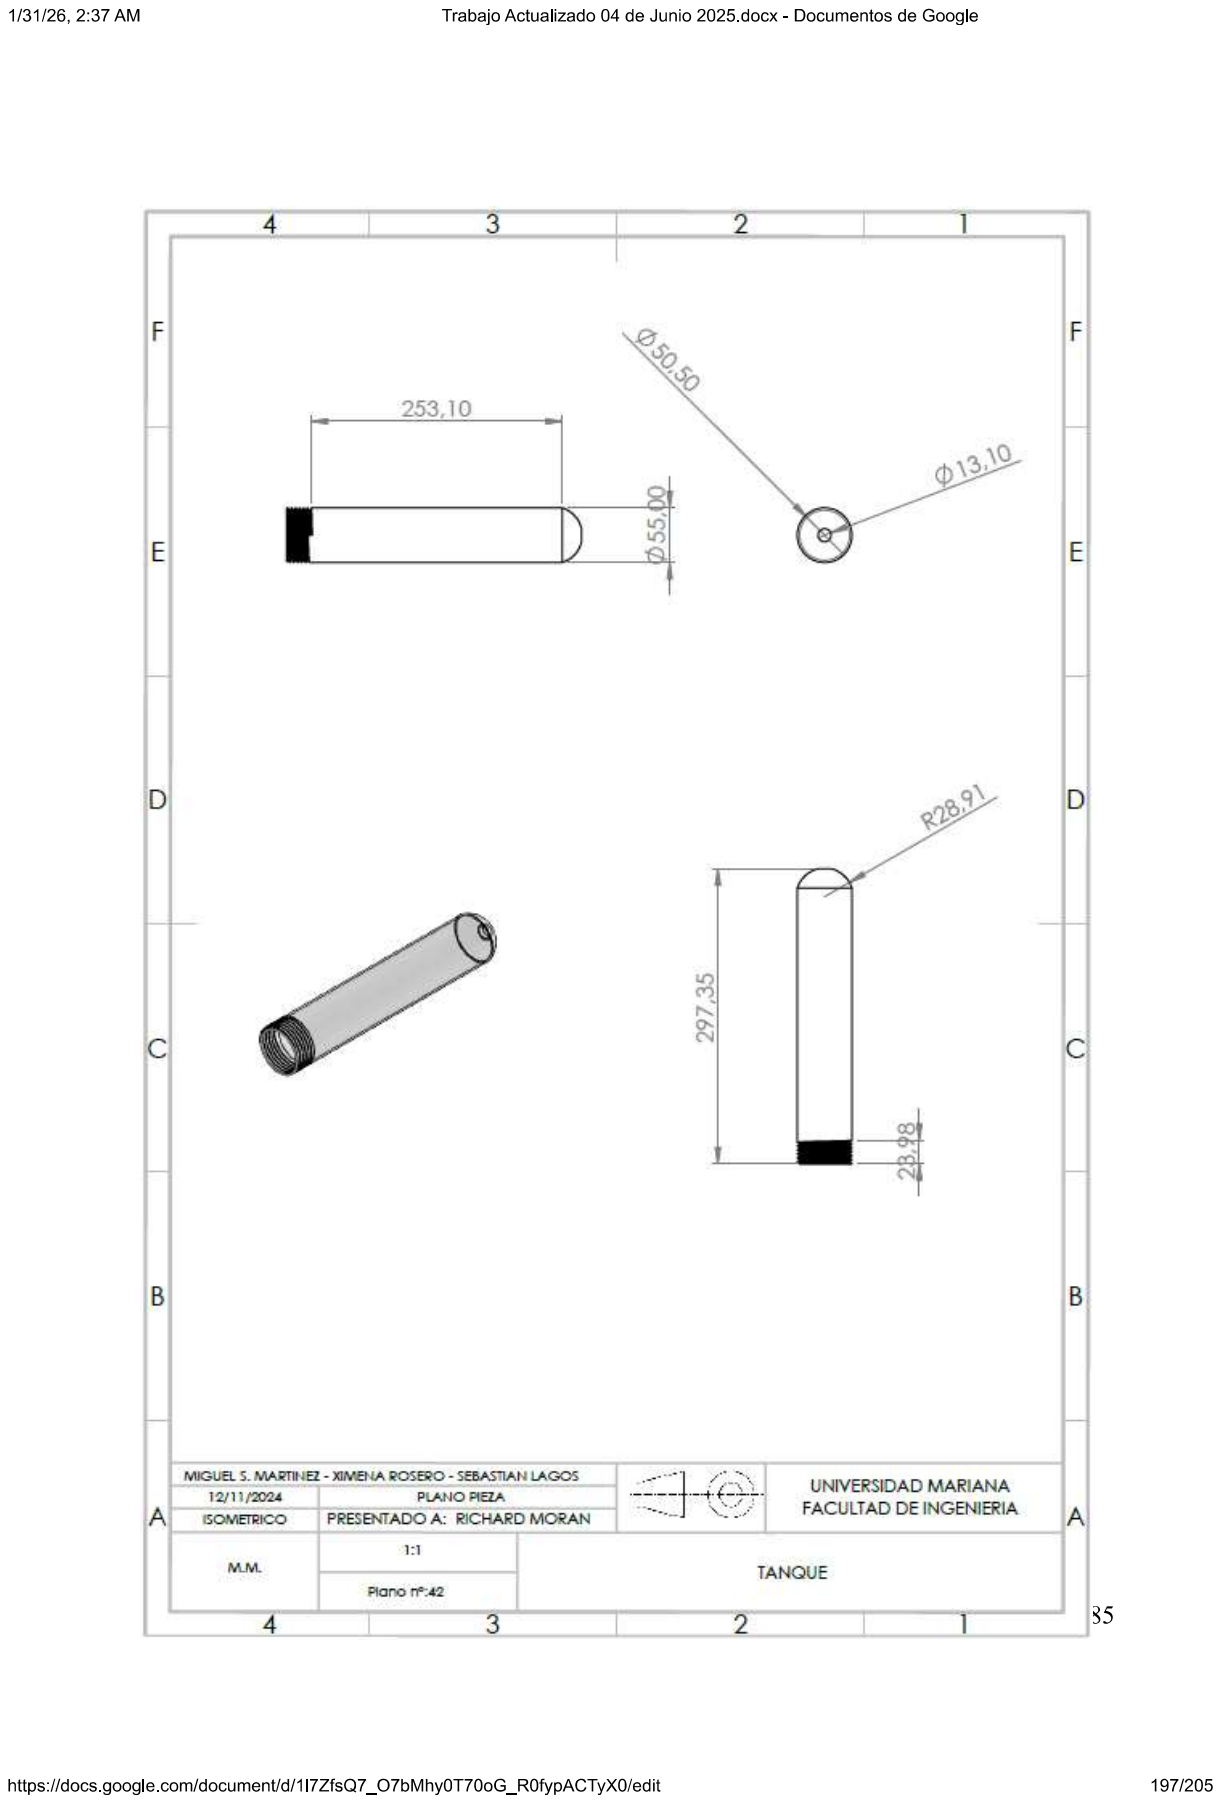
[picture p119: page 42]

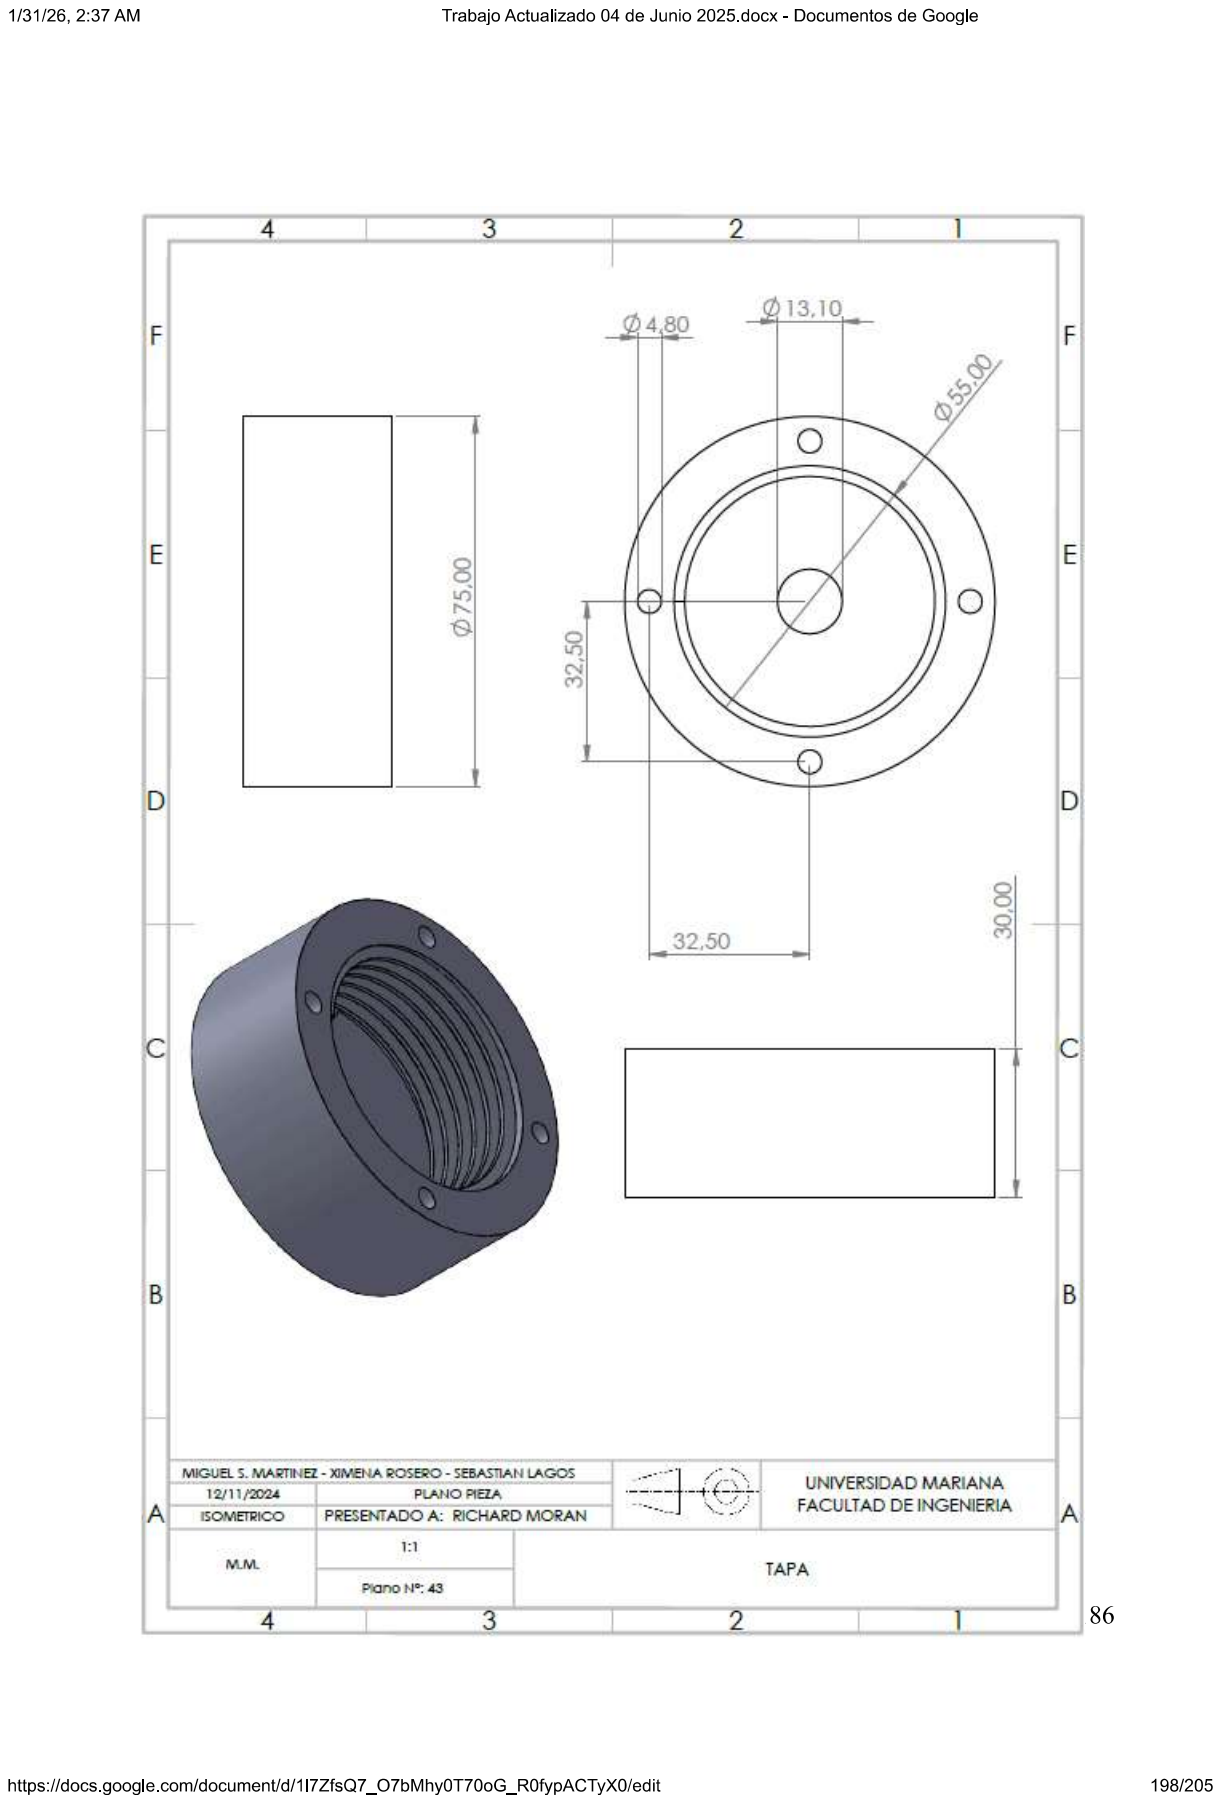
[picture p120: page 43]

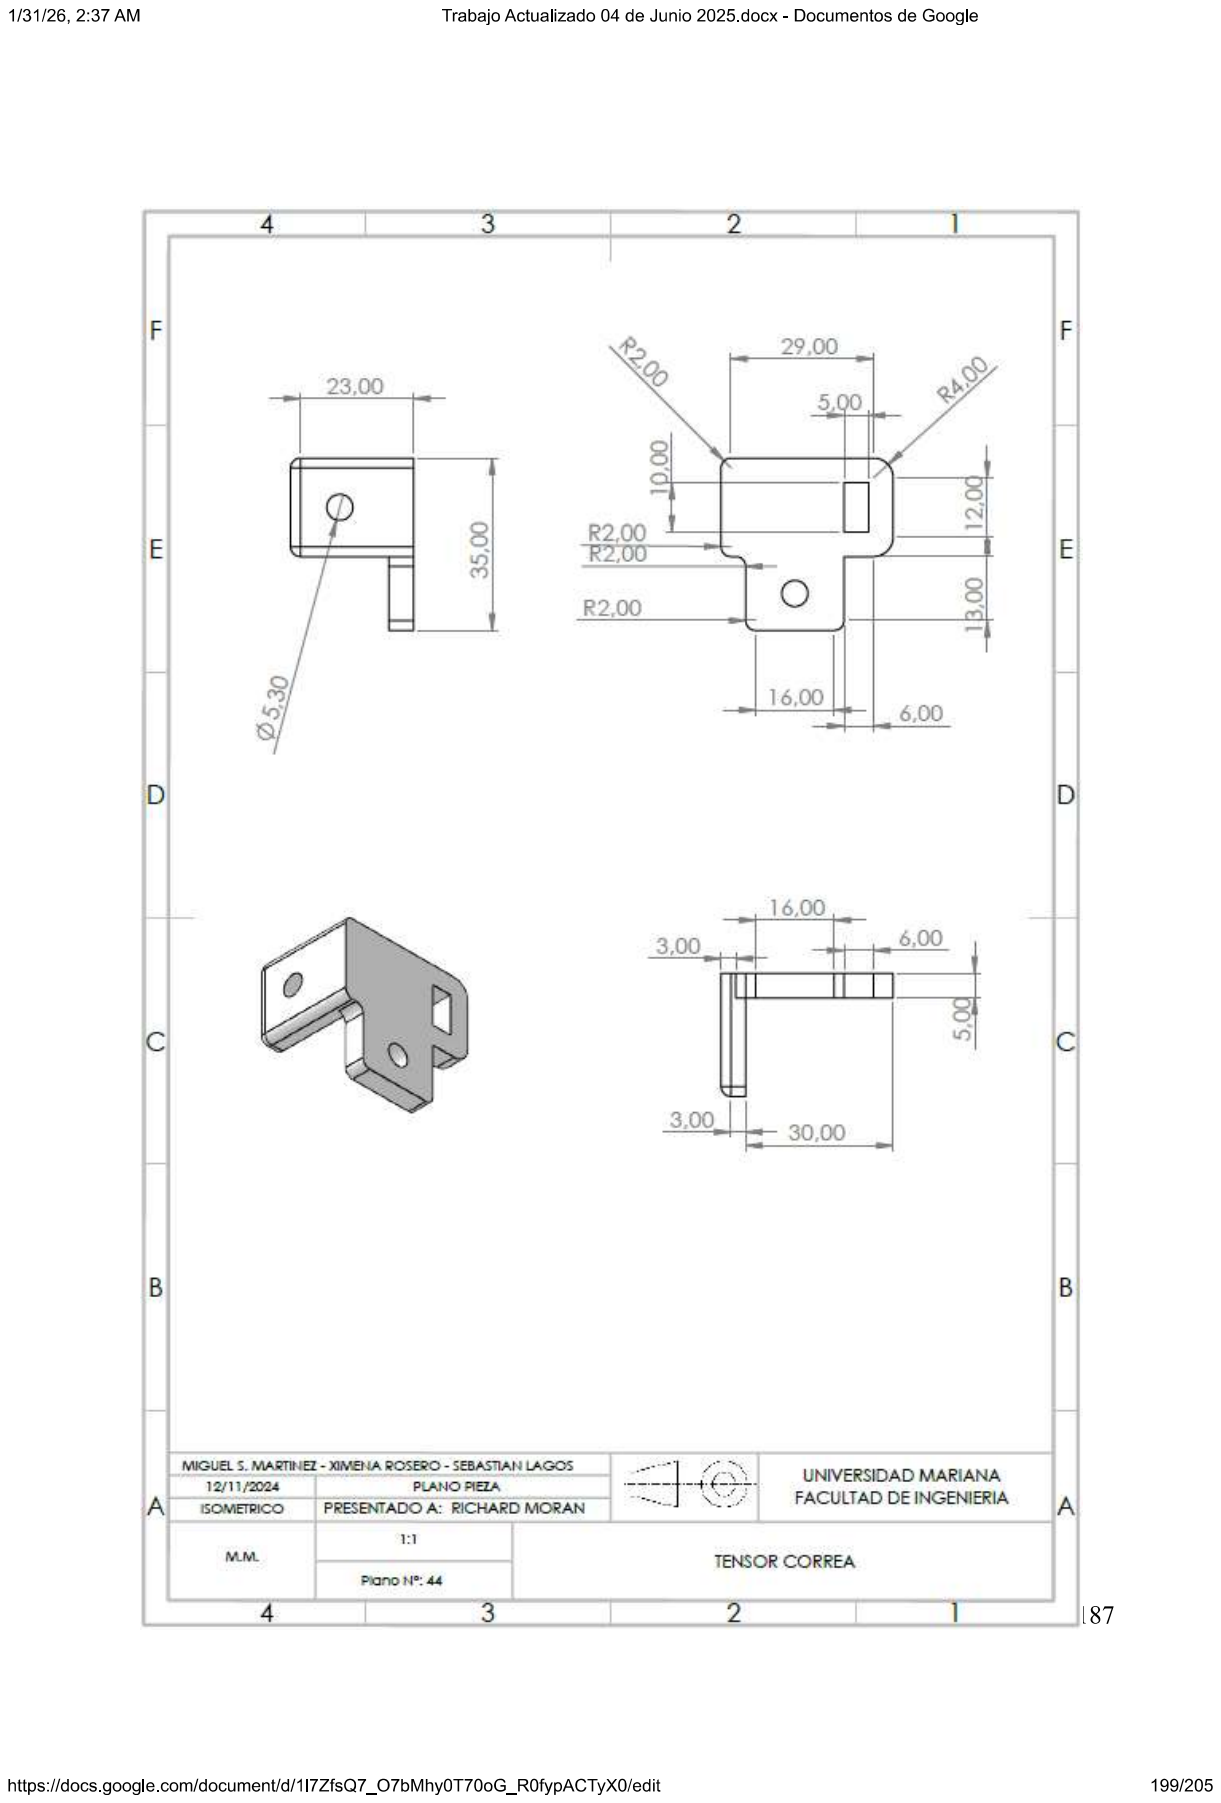
[picture p121: page 44]

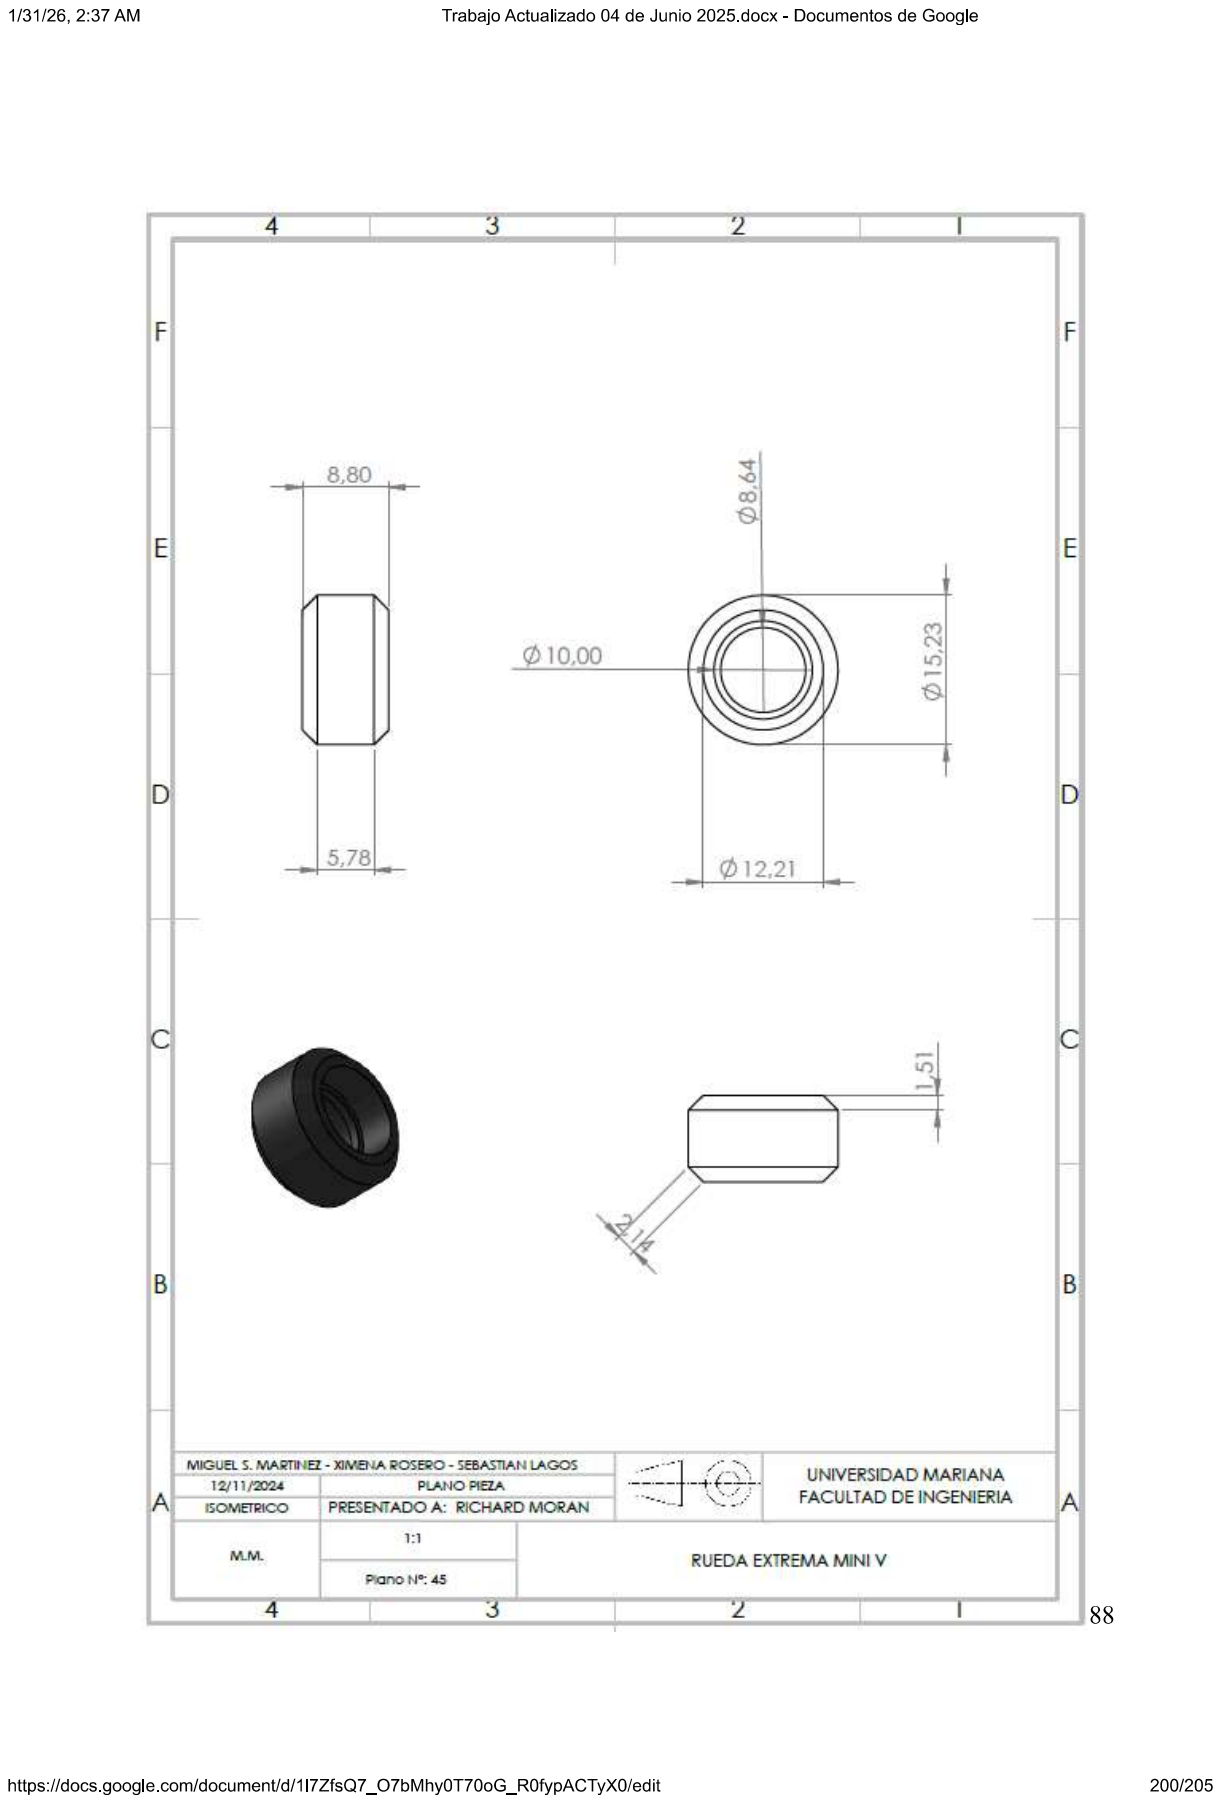
[picture p122: page 45]

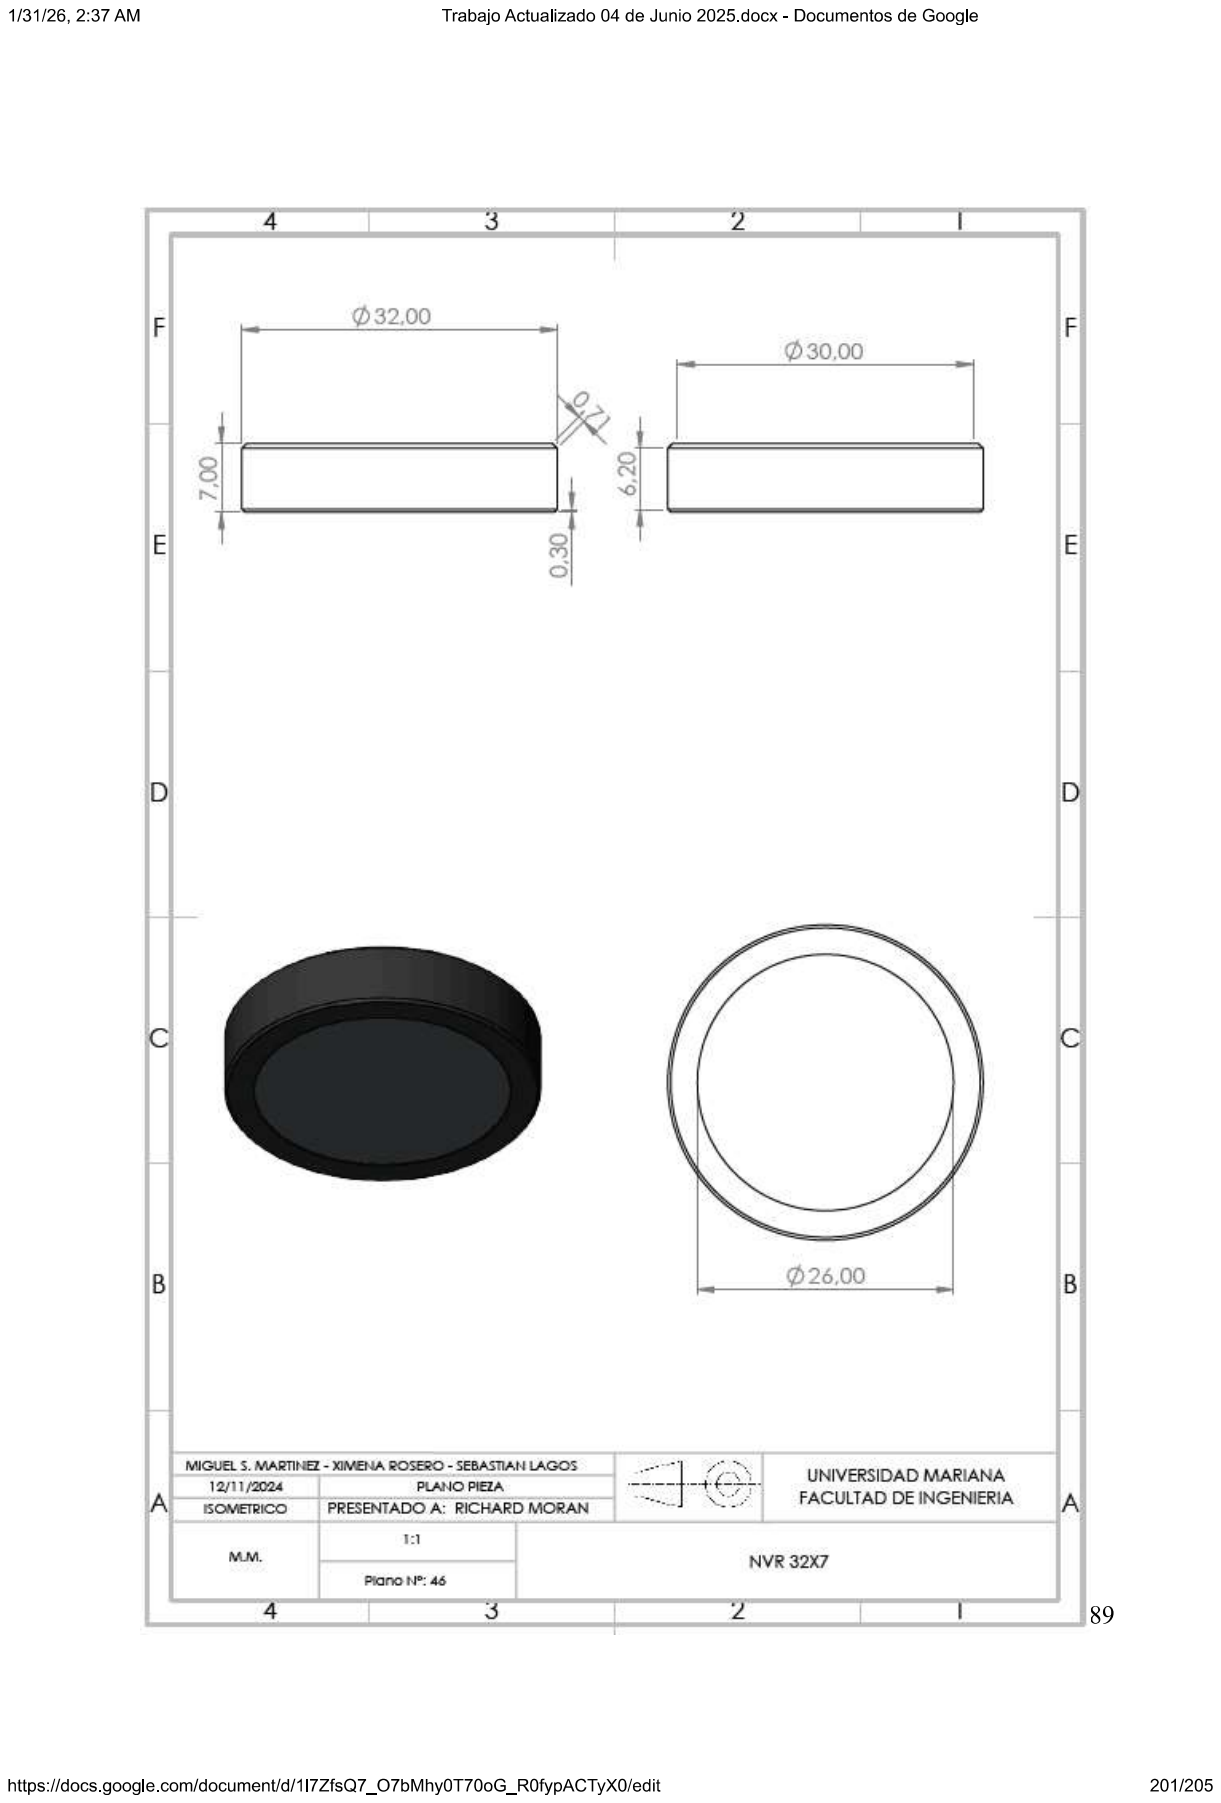
[picture p123: page 46]

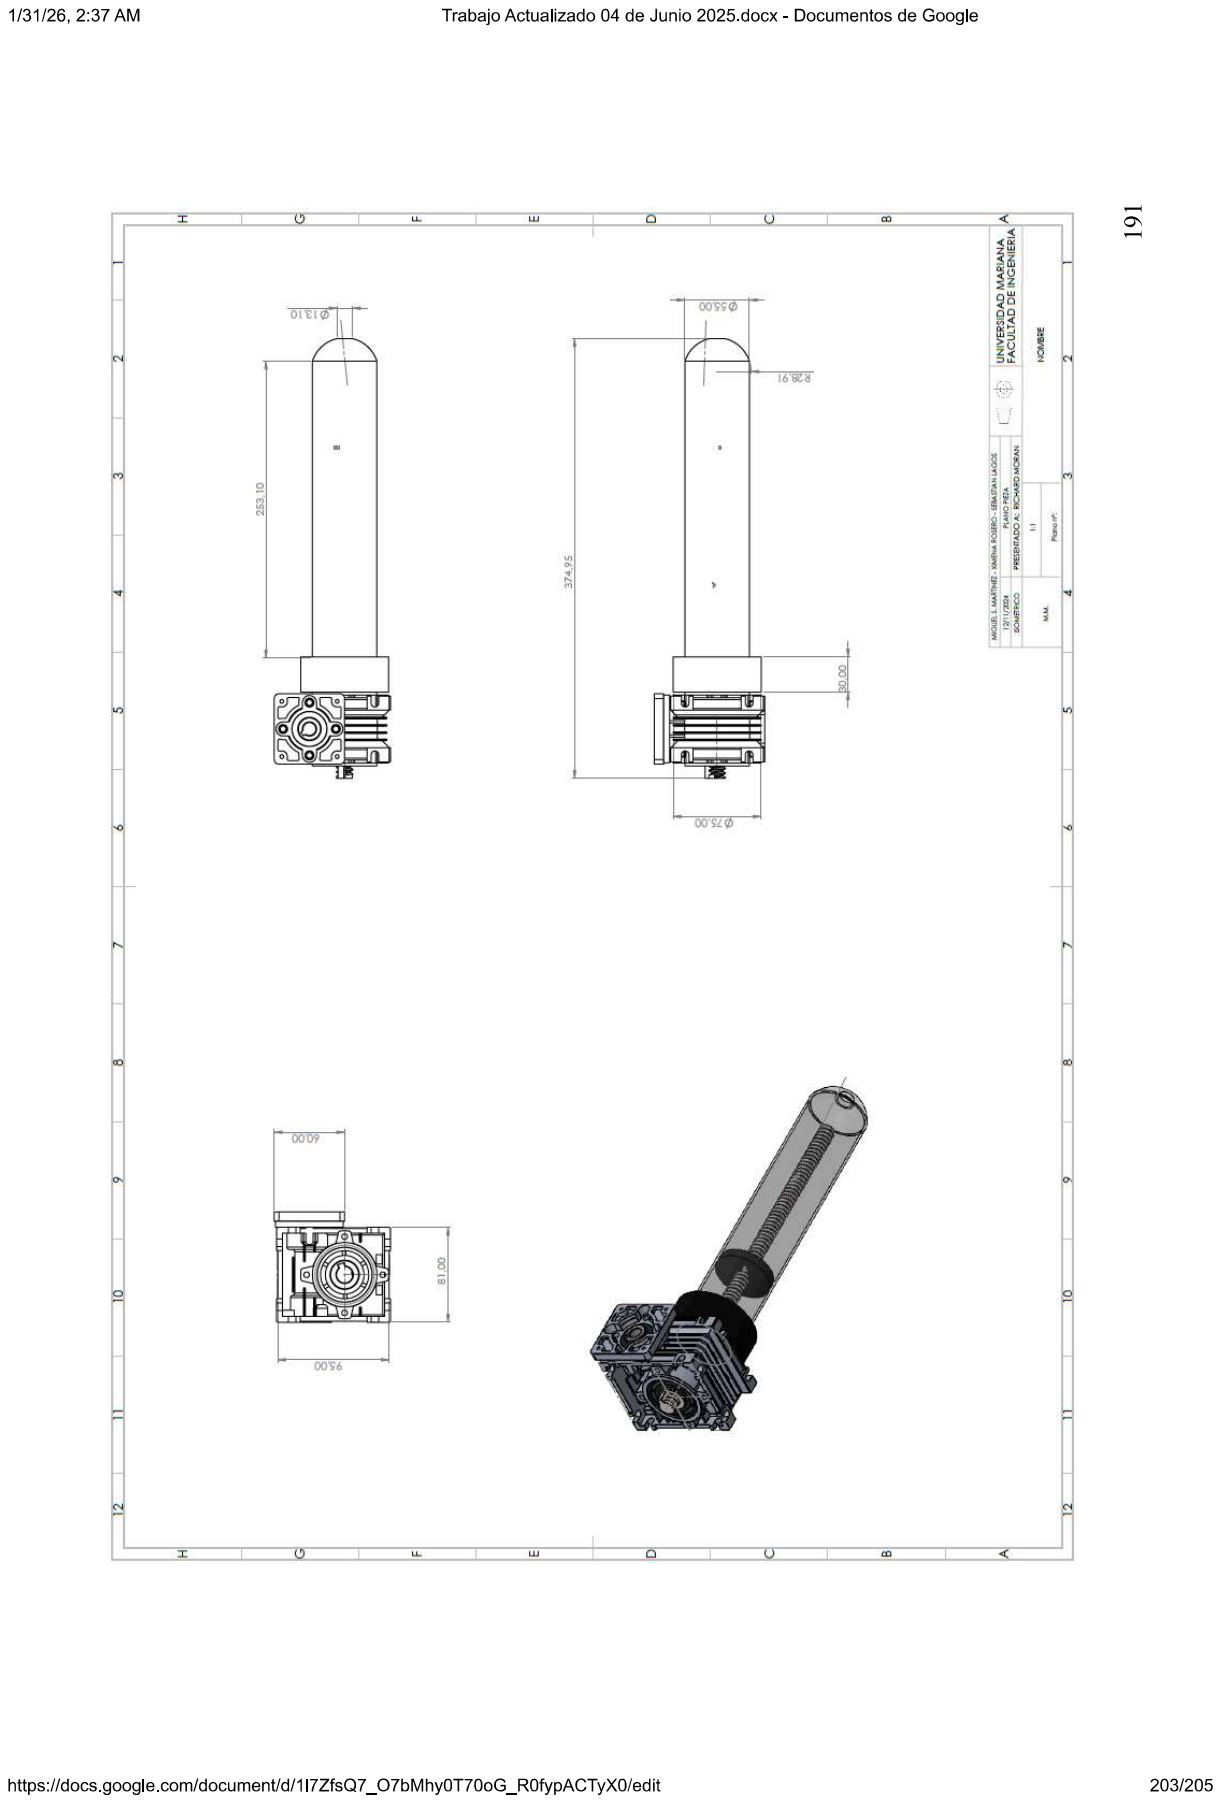
[picture p124: page 47]
