IngMiguelMartinez/cnc-3d-social-housing-thesis/docs/Certificado_Ponente_Cartagena.pdf

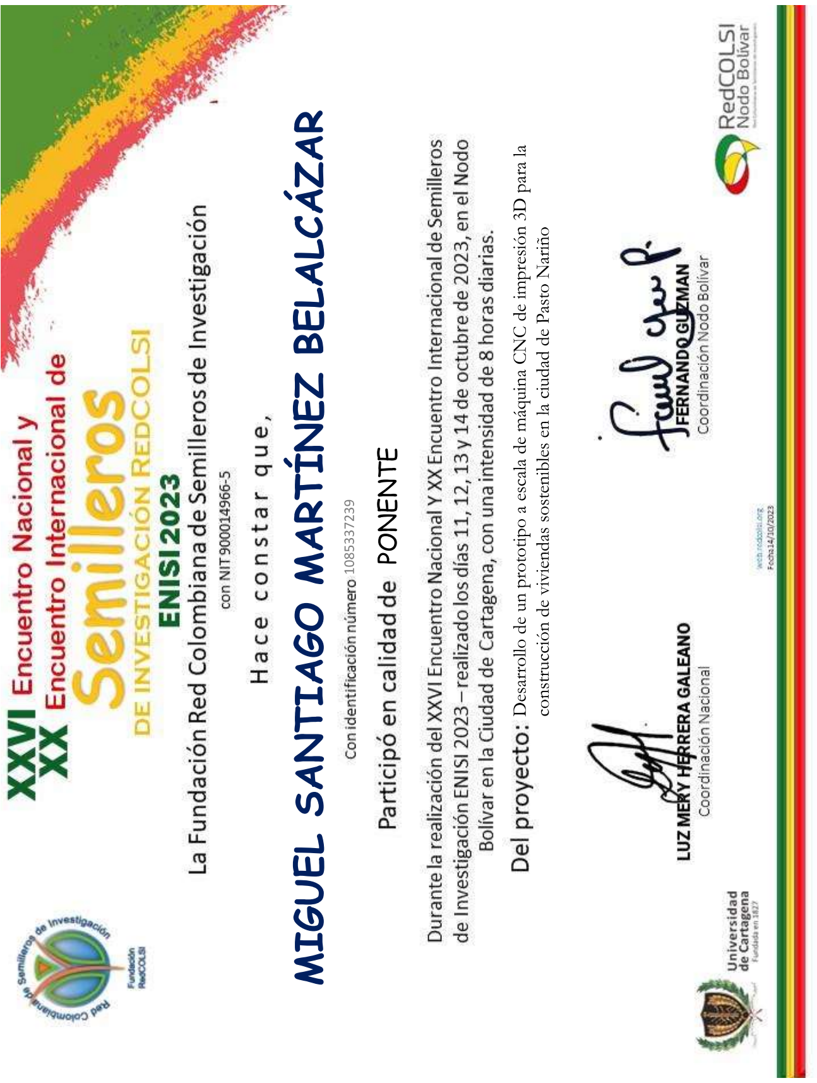
[picture p125: page 1]
